diego-tag/ducted-fan/README.md

# Progetto Double Propeller Ducted-Fan (DPDF)

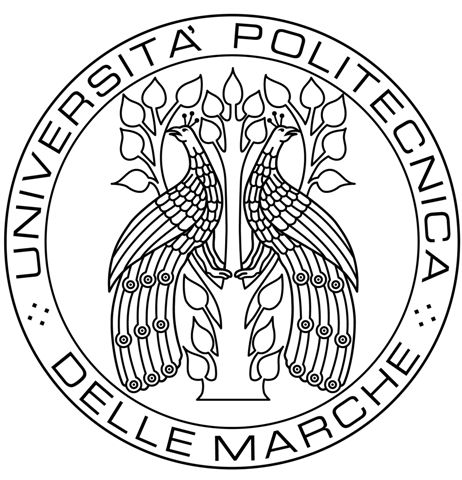
[picture p1: relazione/corrente/figures/00_frontespizio/logo_univpm.jpg]
Logo Univpm


Questo repository contiene la documentazione completa e il firmware per l’UAV **Double Propeller Ducted-Fan (DPDF)** sviluppato come parte del corso di *Laboratorio di Automazione* presso l’Università Politecnica delle Marche.

---

## 📌 Panoramica del progetto

Il **DPDF** è un UAV ducted-fan progettato su misura che presenta:

- Due motori brushless controrotanti per una spinta verticale stabile  
- Controllo aerodinamico tramite flap azionati da servo (pitch e roll)  
- Flight controller basato su STM32H745ZI-Q Nucleo  
- Fusione dei sensori tramite IMU BNO-055 per la stima dell’assetto  
- Misurazione dell’altitudine tramite sensore ToF VL53L1X  
- Implementazione del controllo di hovering basato su PID  

Il sistema è stato sviluppato per ottenere un **hovering** stabile.

## 📁 Struttura del repository

```
root/
├── relazione/
│   └── corrente/main.tex      # Relazione in LaTeX
├── utils/                     # Scripts in python utili (lettura/scrittura seriale)
└── DUCTED_FAN/                # Codice sorgente STM32 in C
```

## 🛠️ Ambiente di sviluppo

- **IDE**: STM32CubeIDE 1.12.1  
- **Configuratore hardware**: STM32CubeMX  
- **Linguaggio**: C (firmware), LaTeX (documentazione)

## 📚 Documentazione

La relazione tecnica completa con tanto di specifiche e schemi è scritta in LaTeX ed è disponibile [qui](relazione/corrente/main.pdf)

## 📎 Autori

- **Mencarelli Matteo**  
- **Secci Bianca**  
- **Tagliatesta Diego**

Supervisionato da:

- Prof. Andrea Bonci  
- Dott. Alessandro Di Biase  

Università Politecnica delle Marche – 2026

> Crediti: Robert Mincu Lareunt

## 📄 Licenza

Questo progetto è educativo ed è destinato all’uso accademico. I progetti hardware e il codice possono essere riutilizzati con la corretta attribuzione.
