diego-tag/ducted-fan/relazione/precedente/chapter3-SOFTWARE/BNO055_software.tex

\section{Descrizione del sub-firmware di gestione del BNO-055 Bosch Sensortec}
