diego-tag/ducted-fan/relazione/corrente/main.pdf

Universita Politecnica delle Marche `

Ingegneria Informatica e dell’Automazione

# Ducted Fan


## Corso di

Laboratorio di Automazione

## Anno accademico 2025-2026

Studenti: | Professore:
Mencarelli Matteo Secci Bianca Tagliatesta Diego | Andrea Bonci
| Dottorando:
| Alessandro Di Biase

Dipartimento di Ingegneria dell’Informazione

## Indice

Introduzione | 2
1 Sistema | 4
2 Hardware | 6
2.2.2 | TATTU LiPo. Caratteristiche tecniche e considerazioni operative . . . | 12
2.6.1 | Turnigy AereoDrive SK3-3536 1400 KV. Caratteristiche fisiche e tecniche 17

2.10.2 BNO-055 Bosch Sensortec. Infrastruttura di alimentazione, comunica-

2.10.3 Principio di misura dell’accelerometro, giroscopio e magnetometro . . 29 2.10.4 BNO-055 Bosch Sensortec. Accelerometro, giroscopio e magnetometro

2.11 VL53L1X ST. Sensore Time-of-Flight per la misurazione a lunga distanza . . | 34
3 Software | 43
4 Test e risultati | 55
Conclusioni e sviluppi futuri | 56
Appendici | 56
A Appendice1 | 57

## Introduzione

Spiegazione dettagliata del task assegnato al gruppo (cosa avete fatto e su quale sistema). Se per lo svolgimento del task `e stato necessario interagire con altri gruppi che hanno lavorato sullo stesso sistema, presentare anche brevemente i task svolti dagli altri gruppi e spiegare la loro interconnessione. Se si `e invece optato per far confluire il lavoro di pi`u gruppi in un’unica relazione, va spiegato qual era il task iniziale dei singoli gruppi e poi come `e avvenuta l’integrazione. In sintesi, l’introduzione deve permettere al lettore di capire subito su cosa avete lavorato. Al termine dell’introduzione inserite anche una breve descrizione per capitoli del contenuto della restante parte della relazione (es. nel Capitolo 2 viene descritto...).
Nel seguito la struttura in capitoli di massima per ogni relazione, da adattare qualora necessario. NOTA: La relazione va pensata e scritta nell’ottica di dare a chi verr`a dopo di voi un documento utile per capire a che punto `e arrivata l’attivit`a svolta dal vostro gruppo e per metterli in condizione di portare avanti il vostro lavoro. Di conseguenza dovete essere chiari e diretti, riportando solo le informazioni necessarie e evidenziando in modo critico cosa effettivamente funziona correttamente e cosa va migliorato

## 1 Sistema

Nel presente capitolo viene descritta la struttura meccanica del Double Propeller Ducted-Fan (DPDF) e viene introdotto l’obiettivo di controllo adottato nel progetto.

## 1.1 Double Propeller Ducted-Fan. Struttura

Il DPDF presenta una struttura cilindrica cava di 220 [mm] di altezza e con un diametro esterno pari a 235 [mm]. Il diametro interno, pari a 230 [mm], contiene le componenti necessarie al volo stabile dell’UAV.
La configurazione con montaggio interno delle componenti responsabili del moto rappresenta l’elemento distintivo rispetto alle architetture di droni convenzionali. Tale configurazione risulta vantaggiosa per qualsiasi forma di interazione di contatto, sia con l’operatore umano sia con oggetti esterni, in quanto le eliche non sono esposte ma risultano integrate e protette dalla stessa struttura portante del drone.
Proseguendo con la descrizione della struttura interna del DPDF, nella parte superiore sono posizionati due motori disposti in configurazione controrotante. L’implementazione di tale assetto garantisce la generazione di spinte verticali senza che il drone ruoti su se stesso attorno all’asse Z, passante per il centro della struttura cilindrica. Le eliche, infatti, generano momenti torcenti in direzione opposta e, bilanciandosi, restituiscono un momento risultante nullo per il velivolo.
Inoltre, l’adozione di due motori si `e resa necessaria in quanto un singolo attuatore non sarebbe stato in grado di generare una spinta sufficiente a garantire la portanza richiesta dal sistema nelle condizioni operative previste. I motori sono ancorati a una struttura a croce usata sia come base sia come rinforzo per le sollecitazioni che il DPDF pu`o subire. Tale struttura `e stata progettata con una geometria e una finitura superficiale tali da minimizzare l’insorgenza di turbolenze aerodinamiche potenzialmente destabilizzanti per il volo del drone. Il disegno strutturale rende il DPDF suscettibile a rotazioni indesiderate sul piano definito dagli assi X e Y. Tali perturbazioni possono compromettere la stabilit`a del sistema, determinando una completa perdita di controllo del mezzo.
Al fine di limitare tali perturbazioni, la parte inferiore del DPDF integra due flap: uno dedicato al controllo dell’assetto lungo l’asse delle ascisse e uno lungo l’asse delle ordinate. I flap, interagendo con il getto d’aria generato dai motori, operano come superfici aerodinamiche di controllo dedicate alla compensazione dei disturbi di roll e pitch. L’intervento di regolazione si basa sulla modifica della direzione e della velocit`a del flusso d’aria spinto verso il basso. Il flap, ruotando di un piccolo angolo, genera una deviazione del getto che lo investe. Tale deviazione produce una variazione della distribuzione di pressione tra il lato esposto al flusso (lato di pressione) e il lato opposto (lato di depressione). La differenza di pressione genera una forza aerodinamica risultante che produce un momento correttivo sull’assetto del velivolo. In prima approssimazione, la forza pu`o essere considerata perpendicolare alla superficie del flap. La direzione e il verso della forza devono essere tali da contrastare il momento perturbativo.

Entrambi i flap sono collegati, a un’estremit`a, al servomotore che ne gestisce il movimento, mentre all’altra sono inseriti in un apposito modulo strutturale che, oltre a fissare ciascun sensore del sistema, lo mantiene parallelo al terreno. I flap sono posizionati in modo tale da risultare perpendicolari tra loro.
Lungo la superficie esterna del cilindro sono state posizionate le componenti hardware necessarie al perseguimento degli scopi progettuali. La posizione di tali componenti `e stata oggetto di studio al fine di ottenere un preciso bilanciamento del sistema. Gli elementi hardware utilizzati verranno approfonditi nel Capitolo 2.
Inoltre, sulla superficie esterna sono montati sei piedi, posizionati in corrispondenza dei vertici dell’esagono in cui `e inscritta la circonferenza del DPDF. Tale configurazione permette di ottenere un’ottima distribuzione dei pesi. I piedi sono agganciati alla struttura mediante due bulloni opportunamente posizionati, il cui dado di fissaggio si trova all’esterno, lasciando cos`ı la testa all’interno. Tale impostazione permette di evitare l’allentamento del dado di fissaggio causato dal flusso d’aria incidente generato dai motori.
L’intera struttura cilindrica, i flap, il supporto di sostegno dei motori e i piedi di appoggio sono stati realizzati tramite stampa 3D, utilizzando PVC come materiale principale. Tutte le componenti sono state stampate separatamente e successivamente assemblate e fissate tra loro al fine di costruire la struttura completa del sistema.

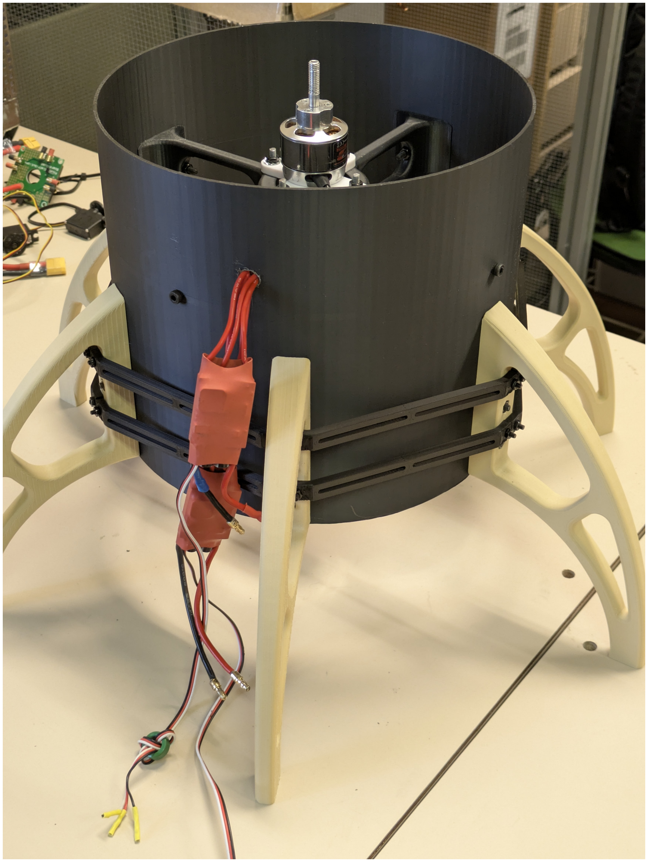
[picture p52: figure]

(a) Struttura di sostegno dei motori | (b) Vista frontale

Figure 1.1: Struttura del ducted fan

## 1.2 Controllo del Double Propeller Ducted-Fan

L’attuale obiettivo di controllo prevede l’ottenimento dell’hovering del DPDF. Con il termine hovering si fa riferimento alla condizione di volo stazionario, in cui l’UAV rimane fermo nello spazio rispetto a un riferimento inerziale, mantenendo posizione e quota costanti nel tempo. Per soddisfare l’obiettivo di hovering, il firmware implementa la teoria dei regolatori PID: un regolatore `e relativo al controllo di quota, mediante la regolazione della portanza dei motori, e due regolatori sono coinvolti nel controllo della posizione mediante la regolazione del comparto flap-servo.

## 2 Hardware

Nel presente capitolo viene fornita la descrizione di tutte le componenti hardware impiegate ai fini progettuali. Per ciascun componente sono stati approfonditi il ruolo nel sistema, le principali caratteristiche fisiche e tecniche e le modalit`a di utilizzo. Infine sono stati riportati un diagramma esplicativo dei collegamenti e una tabella riepilogativa delle connessioni.

## 2.1 STM32 NUCLEO-H745ZI-Q. La scheda di controllo

L’STM32 NUCLEO-H745ZI-Q `e una scheda di sviluppo prodotta da STMicroelectronics, basata sul microcontrollore STM32H745ZI-TQ6, appartenente alla famiglia ad alte prestazioni STM32H7. Il dispositivo `e stato progettato per facilitare lo sviluppo, il debug, e la prototipazione di applicazioni embedded complesse. La NUCLEO-H745ZI-Q `e stata utilizzata per sviluppo e testing dei firmware di gestione di tutte le componenti del D.P.D.F. Su di essa sono state caricate tutte le librerie software sviluppate con l’ausilio di STM32CubeIDE. A seguire, una descrizione dettagliata delle features del microcontrollore STM32H745ZI-TQ6.

### 2.1.1 STM32H745ZI-TQ6. Architettura

Il microcontrollore STM32H745ZI-TQ6 presenta un’architettura dual-core a 32-bit composta da un processore ad alte prestazioni, il Cortex-M7, e da un processore il cui utilizzo `e consigliato per applicazioni real-time e low-power tasks. L’architettura consente l’implementazione di applicazioni multithread. In questo progetto di tesi, l’esecuzione delle librerie software di gestione dei dispositivi interessati `e affidata al Cortex-M4. La selezione e la configurazione delle periferiche dello STM32H745ZI-TQ6 necessarie al raggiungimento degli obiettivi progettuali verranno approfondite nel capitolo dedicato al firmware. A seguire un elenco delle caratteristiche concernenti all’architettura dual-core:

- Il Cortex-M7 opera ad una frequenza di 480 MHz.
- Il Cortex-M4 opera ad una frequenza di 240 MHz.

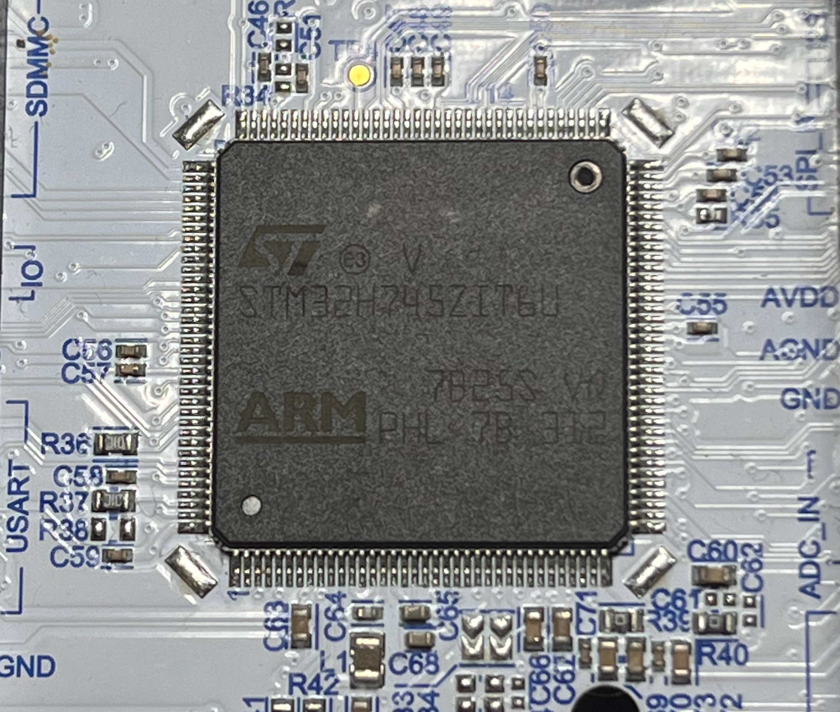
[picture p53: figure]

Figure 2.1: Il microcontrollore STM32H745ZI-TQ6

### 2.1.2 STM32H745ZI-TQ6. Memoria

Il microcontrollore possiede una struttura di memoria complessa e stratificata. Le memorie interne principali sono la memoria Flash e la SRAM. Inoltre, il core M7 monta una cache L1 e una piccola backup SRAM alimentabile a batteria.

Flash
La Flash interna da 2 MByte `e l’area di memoria su cui risiede il firmware. La memoria in questione `e organizzata in dual-bank, che permette la programmazione/cancellazione di una banca dati mentre si esegue sull’altra.

SRAM
Il dispositivo dispone di circa 1 MByte di memoria dati volatile o SRAM, distribuita in pi`u banchi con caratteristiche e destinazioni d’uso differenziate. In particolare:
- La SRAM1 e la SRAM2, rispettivamente da 320 KByte e 384 KByte, costituiscono i blocchi principali ad alta velocit`a, accessibili da entrambi i core. Rappresentano l’area privilegiata per l’allocazione dei dati che richiedono tempi di accesso ridotti e condivisibilit`a tra i due processori.
- Il blocco di SRAM3, da 128 KByte, `e tipicamente dedicato al Cortex-M4, favorendo cos`ı una separazione logica delle risorse riducendo anche i conflitti di accesso.
- SRAM4, SRAM5 e SRAM6, in ordine, 128 KByte, 64 KByte e 64 KByte completano la struttura, fornendo ulteriori spazi di memoria che possono essere destinati a funzioni specifiche o a buffer ad alte prestazioni, secondo esigenze applicative.

Cache L1
Il Cortex-M7, a supporto dell’efficienza complessiva, integra una cache L1 per istruzioni e dati, riducendo la latenza di accesso alla memoria non volatile e minimizzando i colli di bottiglia dovuti alla differenza tra la velocit`a del processore e quella della Flash. In tal modo le prestazioni globali del sistema risultano incrementate.

Flexible Memory Controller e Dual-mode Quad-SPI
Il Flexible Memory Controller `e un’unit`a hardware che consente l’interfacciamento diretto con memorie parallele esterne al dispositivo. Il FMC supporta: SRAM, PSRAM, SDRAM, NOR Flash e NAND Flash. L’integrazione del FMC comporta un incremento nell’efficienza delle comunicazioni. Una volta configurato il controller, la memoria esterna entra a far parte dello spazio di indirizzi del microcontrollore mascherando la complessit`a del protocollo. Il Dual Mode Quad-SPI `e un’altra interfaccia dedicata alle Flash seriali esterne ad alta velocit`a. La soluzione poco fa citata permette di espandere la memoria dedicata al firmware oppure di archiviare dati.

Memory Protection Unit
La Memory Protection Unit `e una componente hardware integrata in ciascun core del microcontrollore. La mansione del circuito integrato in questione `e quella di controllare e regolare l’accesso alla memoria.

Unit`a di elaborazione
L’architettura dell’STM32H745ZI-TQ6 integra anche unit`a di elaborazione dedicate ai calcoli numerici e al processamento dei segnali.

Floating Point Unit
La FPU `e un’unit`a hardware integrata nei due core di elaborazione che consente l’esecuzione diretta di operazioni in virgola mobile. La presenza di questo circuito integrato riduce drasticamente la latenza di calcolo in applicazioni che richiedono elaborazioni numeriche complesse. Nel caso del Cortex-M7 la FPU supporta sia la single precision che la double precision, mentre il Cortex-M4 solo una FPU a precisione singola.

Digital Signal Processing
Il Digital Signal Processing `e un supporto hardware per istruzioni dedicate all’elaborazione numerica di segnali digitali.

### 2.1.3 STM32H745ZI-TQ6. Convertitori

Convertitori Analogici-Digitali
L’STM32H745ZI-TQ6 integra tre convertitori analogici-digitali SAR ADC (successive approximation analog-to-digital converter ) a 16-bit: ADC1, ADC2 e ADC3. I primi due, l’ADC1 e l’ADC2, sono tightly coupled, cio`e strettamente accoppiati, consentendo una sincronizzazione precisa delle conversioni. Questo approccio permette di ottenere alte frequenze di campionamento, precisione temporale e riduzione del carico computazionale del core. L’ADC3 invece `e istanziato separatamente. La risoluzione pu`o essere configurata a 16, 14, 12, 10 o 8 bit.

Convertitori Digitali-Analogici
Il microcontrollore possiede 2 DAC indipendenti la cui risoluzione `e a 12 bit.

### 2.1.4 STM32H745ZI-TQ6. Timer

I timer sono periferiche hardware fornite dal microcontrollore per svolgere attivit`a correlate al tempo. L’STM32H745ZI-TQ6 fornisce 15 timer di diverso tipo e 5 low power timer. Alcuni di questi possono essere utilizzati per la genesi di segnali PWM.

### 2.1.5 STM32H745ZI-TQ6. Periferiche di comunicazione

L’STM32H745ZI-TQ6 integra un insieme ampio e variegato di protocolli di comunicazione. Le periferiche possono essere raggruppate in tre categorie principali: comunicazione seriale, comunicazione veloce e interfacce multimediali speciali. Per quanto riguarda la comunicazione seriale, il microcontrollore supporta i protocolli: I

2C, USART/UART e SPI.
Nell’ambito della comunicazione veloce e avanzata il dispositivo supporta i protocolli: CAN (Controller Area Network), USB OTG, Ethernet MAC, SD/SDIO/MMC. L’integrazione delle interfacce multimediali consente la gestione di applicazioni audio, grafiche e visione artificiale: SAI (Serial Audio Interface), DFSDM (Digital Filter for Sigma-Delta Modulators) e DCMI (Digital Camera Interface).

### 2.1.6 STM32H745ZI-TQ6. Eventi asincroni

Il microcontrollore offre la possibilit`a di gestire con efficacia ogni genere di interrupt (evento asincrono) grazie all’integrazione di un’unit`a di elaborazione dedicata: il NVIC (Nested Vector Interrupt Controller ).

### 2.1.7 NUCLEO-H745ZI-Q. Caratteristiche della scheda

La NUCLEO-H745ZI-Q `e la scheda di sviluppo (development board) che proietta all’esterno tutte le funzionalit`a del microcontrollore poco fa descritto.

Caratteristiche fisiche

- Dimensioni: 133.34 × 70.00 [mm].
- Peso: 120 [g].

ST-LINK/V3E
L’ST-LINK/V3E `e un’interfaccia hardware, gestita dal microcontrollore STM32F723, dedicata al collegamento tra elaboratore esterno e microcontrollore. Il modulo permette di caricare il compilato firmware sul microcontrollore direttamente dalla porta USB Micro-B collegata al sistema di elaborazione. Il modulo permette, inoltre, di eseguire il debug in tempo reale del codice caricato sull’MCU. L’ST-LINK/V3E fornisce anche interfacce ausiliarie utili ai fini dello sviluppo. A seguire un breve elenco esplicativo di queste funzionalit`a aggiuntive:
- VCP (Virtual COM Port): lo ST-LINK integra un’interfaccia di comunicazione che emula una porta seriale virtuale (da cui il nome Virtual COM Port, VCP), tramite connessione USB. In tal maniera, l’elaboratore riconosce lo ST-LINK come una porta COM standard.

- MSC (Mass Storage Class): la scheda di sviluppo appare al sistema di elaborazione come una memoria esterna.

Alimentazione
La scheda di sviluppo offre diversi approcci per l’alimentazione:
- Alimentazione via USB Micro-B ST-LINK a 5V.
- Alimentazione via Jack esterno da 7-12V.
- Alimentazione tramite pin Vin esterno a 3.3V.

Nonostante la presenza di diversi approcci di alimentazione e i differenti voltaggi, la tensione di alimentazione del microcontrollore `e 3.3V, ottenuta attraverso regolatori interni. Sulla scheda di sviluppo sono presenti dei jumper, ovvero dei piccoli interruttori meccanici che permettono di riconfigurare l’hardware della scheda evitando di intaccare il firmware. Si suggerisce di prestare attenzione alla configurazione dei jumper qualora si volesse alimentare la scheda da ingressi diversi dal COM1 o MICRO-B ST-LINK.


Figure 2.2: NUCLEO-H745ZI-Q. Dettaglio esplicativo dei jumper .

Formato fisico
La scheda di sviluppo in esame appartiene alla famiglia Nucleo-144 di STMicroelectronics e, dunque, mette a disposizione 2 connettori Morpho che espongono i 144 pin del microcontrollore. Il sistema di espansione poco fa citato viene chiamato ST Zio. La NUCLEO-H745ZI-Q offre, inoltre, la compatibilit`a hardware e pinout con gli shield Arduino Uno R3.


Figure 2.3: La scheda di sviluppo NUCLEO-H745ZI-Q

## 2.2 TATTU LiPo. Batteria ricaricabile [DA MODIFICARE]

Motori, Servomotori e E.S.C richiedono specifici livelli di tensione per il loro funzionamento, tensioni che non possono essere fornite dalla NUCLEO H745ZI-Q. Si rende, quindi, necessario l’inserimento nel progetto di batterie ricaricabili.
La selezione delle batterie disponibili sul mercato `e stata condotta a seguito di un’analisi approfondita delle caratteristiche elettriche di motori, servomotori ed E.S.C, unitamente ad uno studio dettagliato delle esigenze di autonomia necessarie per le prove di volo, rapportando il tutto al budget disponibile.
Le TATTU LiPo possiedono le prestazioni richieste dal progetto.

### 2.2.1 TATTU LiPo. Caratteristiche fisiche

- Dimensioni: 74 × 35.5 × 29 [mm].
- Peso: 150 [g].
- Numero di celle: 4.

### 2.2.2 TATTU LiPo. Caratteristiche tecniche e considerazioni operative

LiPo
La sigla LiPo sta ad indicare la tecnologia elettrochimica utilizzata nella costruzione della batteria. LiPo nasce da Lithium-Polymer, ovvero polimero di litio. La particolare nominazione deriva dal componente chimico utilizzato come elettrolita, che, nel caso in esame, non `e liquido, ma un polimero gelificato. Malgrado nelle fonti ufficiali non venga specificato il polimero usato nel progetto delle TATTU LiPo, con il fine di informazione, `e stato deciso di riportare quello pi`u comunemente utilizzato per la tipologia di batterie in esame, il polivinilidenfluoruro esafluoropropilene (PVDF-HFP).
Rispetto ad altri sistemi elettrochimici presenti sul mercato (come ad esempio: Li-ion, LiF eP O4, NiMH ecc.), le batterie LiPo presentano un’elevata densit`a di potenza, una bassa resistenza interna e una notevole flessibilit`a nelle geometrie costruttive, oltre ad un contenuto peso. Tali attributi risultano vantaggiosi nell’ambito della progettazione di UAV, come il D.P.D.F.

Tensione
La TATTU LiPo possiede 4 celle da 3.7 [V]. Le celle sono collegate in serie, perci`o la tensione nominale `e circa 14.8 [V].
A carica completa, ogni cella pu`o raggiungere i 4.2 [V], emettendo un’uscita di 16.8 [V]. Il mantenimento della tensione delle celle nell’intorno dei 3.7 [V] contribuisce a preservare la stabilit`a chimica interna delle batterie, riducendo l’erosione delle celle e prolungandone la vita utile. Si consiglia di non mantenere le celle a 4.2 [V] per periodi prolungati di tempo, evitandone cos`ı il danneggiamento.
Nella fase iniziale e di sviluppo firmware, le batterie sono state tenute in bilanciamento alla tensione nominale di 14.8 [V], mentre, nella fase finale, in cui i test di volo sono stati protagonisti, al fine di ottenere un aumento dell’autonomia delle batterie e della prestazione dei motori, queste venivano caricate, mantenendo il bilanciamento tra celle, fino a 4.2 [V] per cella. Infine, `e necessario adottare un’ulteriore accortezza per evitare danni. E consigliabile ` non far scendere la tensione della batteria al di sotto dei 12 [V], mantenendo cos`ı il valore di tensione di ogni cella sopra i 3 [V].

Capacit`a
La capacit`a di una batteria, misurata in [mAh], milliAmpere-ora, definisce la quantit`a di carica elettrica che la batteria pu`o immagazzinare e fornire nel tempo. Nel caso in esame, la capacit`a `e di 1300 [mAh], vale a dire che la batteria pu`o fornire 1.3 [A] per un’ora.

In generale si pu`o utilizzare la seguente formula approssimata per il calcolo del tempo di funzionamento:

th =

C [mAh]
A [mA]

(2.1)

dove th rappresenta il tempo di funzionamento in ore, C la capacit`a della batteria espressa in milliAmpere-ora e A la corrente assorbita espressa in milliAmpere. Con il fine di aumentare l’autonomia di volo, si `e optato per l’accoppiamento in parallelo di due TATTU LiPo, cos`ı da ottenere una capacit`a totale di 2600 [mAh]. L’accoppiamento in sicurezza `e stato effettuato utilizzando il PowerSafe Twin della MNR-electronics, il quale verr`a approfondito nella successiva sezione.

Capacit`a di scarica
Con il termine capacit`a di scarica ci si riferisce alla quantit`a di corrente massima che la batteria pu`o fornire, in sicurezza e in maniera continuativa, senza danneggiarsi. La TATTU LiPo possiede una capacit`a di scarica pari a 75C, vale a dire che pu`o erogare:
Amax = Cs · C =⇒ Amax = 75 [C] · 1.3 [A] = 97.5 [A] | (2.2)

senza surriscaldarsi o danneggiarsi.
Nella precedente formula, Amax si riferisce alla corrente massima erogabile dalla batteria in sicurezza, espressa in [A], Amp`ere. Cs e C, invece, si riferiscono rispettivamente alla capacit`a di scarica e alla capacit`a di erogazione di corrente in un’ora, espressa sempre in [A].

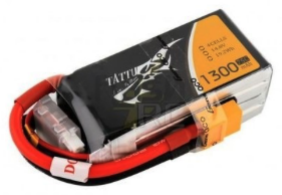
[picture p54: figure]

Figure 2.4: TATTU LiPo 4S 1300mAh 75C

## 2.3 PowerSafe Twin ADV. MNR-electronics

Per garantire la sicurezza e l’affidabilit`a dell’alimentazione a due pacchi batteria, si `e deciso per l’implementazione del modulo di ridondanza, PowerSafe Twin ADV di MNR-electronics.
Il dispositivo incarna un’avanzata soluzione di ridondanza attiva. Quest’ultima fa riferimento alla capacit`a del sistema di intervenire attivamente nel funzionamento del circuito con il fine di garantire continuit`a di alimentazione. Il modulo, di fatto, monitora continuamente alcune variabili di stato, come tensione e corrente, selezionando, in tempo reale, il pacco alimentante il carico. Per esempio, se dovesse abbassarsi la tensione di una batteria sotto una certa soglia critica, il dispositivo commuterebbe automaticamente sull’altra, evitando cos`ı una significativa interruzione della potenza fornita.
Nell’architettura del sistema `e possibile distinguere tre moduli distinti.

Modulo di potenza
Il modulo di potenza `e il circuito elettrico responsabile della commutazione tra i pacchi batteria, del bilanciamento e della distribuzione di corrente verso il carico.
Inoltre, il dispositivo implementa circuiti di protezione, isolando la sorgente guasta, qualora si dovesse presentare un malfunzionamento, ed evitando il trasferimento di corrente fra i pacchi batteria.

Modulo di controllo
Il modulo di controllo rappresenta il ”centro di comando” del dispositivo. L’implementazione di un microprocessore permette la continua misura di parametri decisionali fondamentali, quali: la tensione delle batterie, la corrente di carico e l’eventuale squilibrio. L’inserimento del modulo di controllo nell’architettura circuitale permette l’implementazione della, precedentemente citata, tecnologia di ridondanza attiva.

Modulo di allarme
Il modulo di allarme provvede alla segnalazione di eventuali guasti mediante emissioni luminose (LED) ed acustiche (Buzzer).

### 2.3.1 PowerSafe Twin ADV. Caratteristiche fisiche e tecniche

A seguire, un breve elenco delle caratteristiche fisiche e tecniche del dispositivo:

- Dimensioni con involucro protettivo: 80 × 59 × 26 [mm].
- Peso, considerando sia l’involucro protettivo che i cablaggi (connettori XT60): 100 [g].
- Corrente massima gestibile: 100 [A] (in continua).
- Numero di celle per pacco batteria gestibili: [3S − 8S].
- Tensione massima ammessa in ingresso: ≈ 33.6 [V]. Considerando il minimo 3.7 [V] e il massimo 4.2 [V] per cella: [11.1 ÷ 33.6] [V].

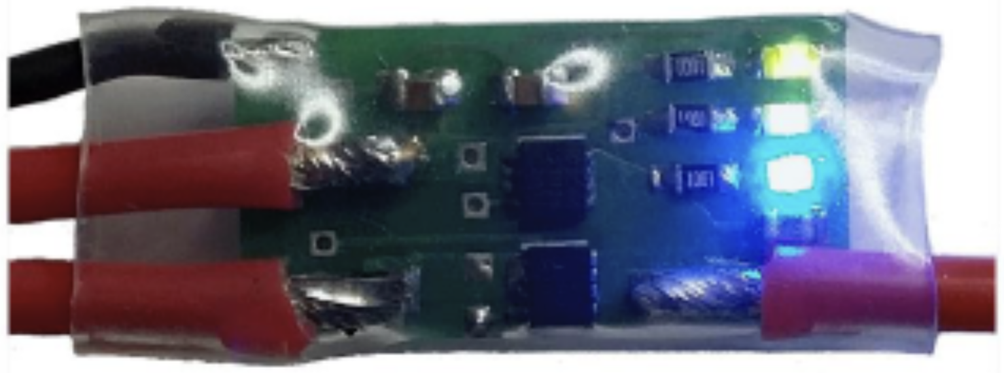
[picture p55: figure]

Figure 2.5: PowerSafe Twin ADV MNR-electronics

## 2.4 DFRobot Power Module. Convertitore di tensione

Ai fini progettuali sono stati implementati diversi dispositivi, ciascuno dei quali richiedente una specifica tensione di alimentazione. Si `e reso necessario ricorrere a convertitori di tensione per distribuire nella maniera corretta le tensioni di alimentazione ai vari dispositivi.
Il DFRobot Power Module riceve in ingresso la tensione proveniente dal pacco batterie, erogando quattro diversi valori di tensione a seconda del terminale che si sceglie di utilizzare. La prima soluzione offerta dal dispositivo fornisce in uscita la stessa tensione che si ha in ingresso, diventando cos`ı un ponte per il passaggio della tensione.
Un’altra soluzione consiste nell’utilizzo degli appositi pin sul dispositivo, dai quali pu`o essere erogata una tensione di 5 [V], selezionabile mediante un apposito switch.
Infine, il dispositivo presenta un terminale che eroga una tensione variabile il cui valore `e controllato da un dimmer. Il dimmer permette di selezionare valori intermedi fino ad un massimo pari alla tensione di ingresso. Quest’ultima `e stata utilizzata nell’alimentazione dei servomotori. La presenza di due servomotori ha richiesto l’integrazione di due convertitori di tensione.

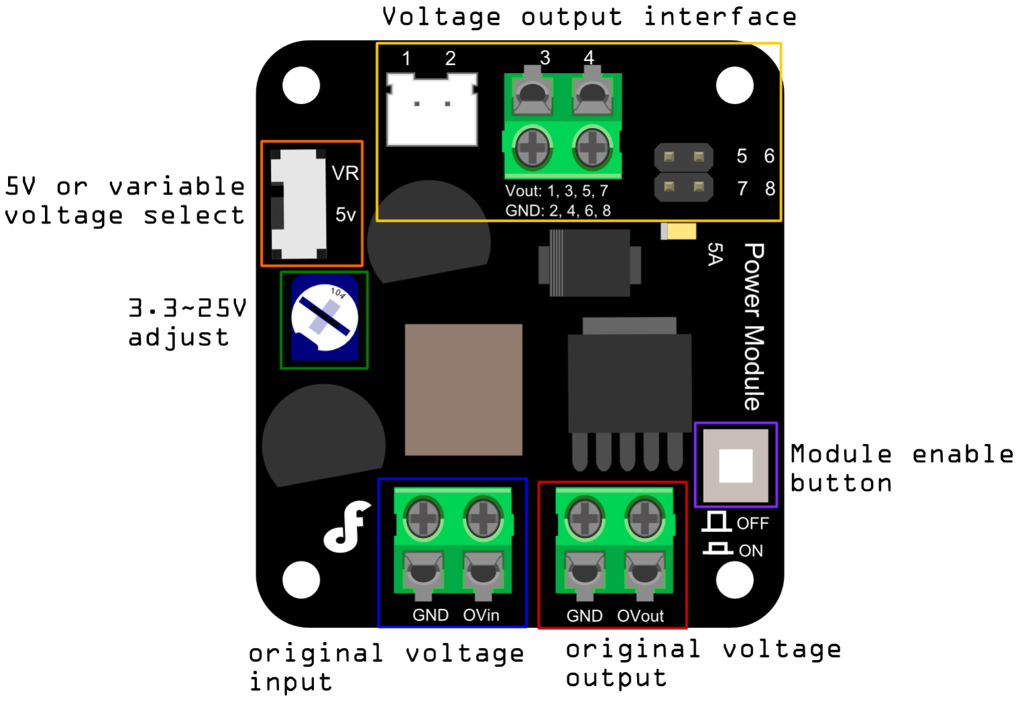
[picture p56: figure]

Figure 2.6: DFRobot Power Module. Disposizione dei terminali di uscita

Caratteristiche fisiche

- Dimensioni: 46 × 50 × 20 [mm].

- Peso: 35 [g].

Caratteristiche tecniche

- Intervallo di tensione in ingresso: [3.6÷25] [V].
- Intervallo di tensione esprimibile in uscita: [3.3÷25] [V].
- Massima potenza erogabile: 25 [W].
- Frequenza di variazione: 350 [kHz].


Figure 2.7: DFRobot Power Module

## 2.5 Power Distribution Board

Con Power Distribution Board (PDB) si fa riferimento ad un sottosistema elettrico la cui principale funzione `e la distribuzione in modo sicuro ed efficiente dell’energia fornita dal pacco batterie agli E.S.C e, conseguentemente, ai motori. Ai fini progettuali, `e stata selezionata una PDB, il cui punto di prelievo del segnale presenta un connettore XT60, adatto al pacco batterie.


Figure 2.8: Power Distribution Board

Il PDB integrato nel contesto operativo possiede quattro uscite eroganti al massimo una corrente di 20 [A] ed un peso di 27.3 [g].

## 2.6 Turnigy AereoDrive SK3-3536 1400KV

Il Turnigy AereoDrive SK3 3536 1400kv `e un motore Brushless alimentato a corrente continua e pilotato a trifase con correnti alternate.
Il rotore contiene magneti permanenti disposti con polarit`a alternata lungo la sua circonferenza. Lo statore invece ospita tre avvolgimenti elettrici (fasi) disposti generalmente a 120 gradi elettrici l’uno rispetto all’altro, connessi ai tre terminali d’uscita che si identificano come A, B e C.
Il rotore, essendo formato da magneti permanenti, non necessita di alimentazione: `e lo statore a generare il campo magnetico rotante che induce il moto.
Il cambio di polarit`a degli avvolgimenti deve essere gestito da un sistema elettronico esterno, l’Electronic Speed Controller (ESC), che nella successiva sezione verr`a approfondito.
I tre conduttori che fuoriescono dal motore rappresentano i terminali delle tre fasi dello statore. Ciascun filo `e collegato a uno degli avvolgimenti e nessuno di essi costituisce un riferimento comune. Per far ruotare il motore `e necessario che tali fasi vengano alimentate secondo una precisa sequenza temporale, generando un campo magnetico rotante. Se si dovessero scambiare due dei tre cavi, l’ordine di commutazione si invertirebbe con conseguente variazione del senso di rotazione.
Nel progetto sono stati impiegati due motori del tipo precedentemente citato, disposti in configurazione controrotante, con il fine di compensare le rotazioni indesiderate di yaw. Tale scelta consente di bilanciare le coppie di reazione generate dalle eliche, riducendo il momento torcente sul velivolo. Inoltre, l’adozione di due motori si `e resa necessaria in quanto un singolo attuatore non sarebbe stato in grado di generare una spinta sufficiente a garantire la portanza richiesta dal sistema nelle condizioni operative previste.

### 2.6.1 Turnigy AereoDrive SK3-3536 1400 KV. Caratteristiche fisiche e

tecniche

- Tensione operativa: [11.1÷16.8] [V].

- Valore KV: 1400 RPM
V
- Potenza massima: 590 [W].
- Corrente massima: 40 [A].
- Resistenza interna: [0.021÷0.025] [Ω].
- Corrente a vuoto: 0.021 [A].
- Diametro dell’albero motore: 5 [mm].
- Peso: 111 [g].
- Spaziatura fori di montaggio: 25×25 [mm].
- Connettori bullet da 3.5 [mm].
- Numero dei poli: 12.

Il valore ”KV” `e comune nel contesto del modellismo ed indica il numero di giri al minuto (RPM) che il motore compie per ogni volt applicato a vuoto, in formula:

RPM = KV · V | (2.3)

A tensioni di alimentazione maggiori rispetto a quelle specificate il motore rischia di assorbire troppa corrente e surriscaldarsi.
I giri al minuto massimi dipenderanno dalla tensione applicata e dalle dimensioni delle eliche. Nel presente progetto, il motore in interesse deve essere alimentato a batteria, vale a dire in corrente continua, lasciando spazio alla necessit`a di un dispositivo che trasformi la tensione continua erogata dalle batterie in un segnale trifase a corrente alternata. Il dispositivo in questione `e il precedentemente citato Electronic Speed Controller.


Figure 2.9: Turnigy Aereo Drive SK3 3536 1400 KV

## 2.7 Turnigy Plush 40A. Electronic Speed Controller

Il Turnigy Plush 40A `e un controllore elettronico di velocit`a per motori brushless a corrente continua (BLDC) [1].
Trasforma la tensione continua in ingresso in tensioni alternate sfasate di 120 gradi elettrici. L’applicazione della corretta sequenza di correnti alle fasi dello statore richiede la conoscenza della posizione angolare in ogni istante di tempo. Il Turnigy Plush 40A stima tale informazione in maniera indiretta, misurando la forza controelettromotrice indotta dal rotore, evitando cos`ı l’uso di sensori di posizione; il dispositivo in interesse pu`o dunque essere definito sensorless. L’ESC in questione pu`o essere concettualmente suddiviso in due sezioni principali: la sezione di potenza e la sezione di controllo. La sezione di potenza `e responsabile della conversione continua-trifase. Tale conversione `e mediata da un ponte trifase a sei MOSFET, suddiviso a sua volta in tre mezzi ponti, ciascuno associato ad una fase del motore. Ogni mezzo ponte `e composto da un transistor di alto lato e da un transistor di basso lato, collegati rispettivamente al potenziale positivo della batteria e a massa. L’opportuna commutazione di apertura e chiusura dei sei MOSFET comporta la generazione di un segnale di tensione alternato per ogni fase.
La sezione di controllo ha come protagonista un microcontrollore che si occupa della generazione di segnali di pilotaggio e della stima della posizione del rotore. Il microcontrollore riceve in ingresso il comando di velocit`a di rotazione del motore sotto forma di segnale PWM. Sulla base di tale comando, il microcontrollore determina il duty cycle del PWM e calcola la sequenza di commutazione dei sei MOSFET, con conseguente generazione del campo magnetico rotante dello statore.
Il Double Propeller Ducted Fan monta due Turnigy Plush 40A, uno per ogni motore.

### 2.7.1 Turnigy Plush 40A. Caratteristiche fisiche

- Corrente nominale: 40 [A].
- Corrente di picco: 55 [A].
- Presenza di un Battery Eliminator Circuit (BEC): 5 [V] a 3 [A].
- Celle di batteria necessarie per il corretto funzionamento del dispositivo: [2 ÷ 6].
- Peso: 39 [g].
- Dimensioni in [mm]: 60 × 24 × 15.

### 2.7.2 Turnigy Plush 40A. Programmazione

Il Turnigy Plush 40A offre la possibilit`a di programmare il suo comportamento operativo, soddisfacendo cos`ı un vasto spettro di possibili esigenze progettuali.
Al fine di ottenere uno specifico comportamento dei motori, tale da adeguarsi alle particolari esigenze di un UAV come il Double Propeller Ducted Fan, entrambi gli ESC sono stati minuziosamente riprogrammati.


Figure 2.10: Turnigy Plush 40A

L’accesso alla Programming Mode e l’effettiva programmazione sono state effettuate mediante l’apposita Turnigy Programming Card, acquistata separatamente. Per effettuare la programmazione, `e necessario disporre i collegamenti elettrici come in figura:

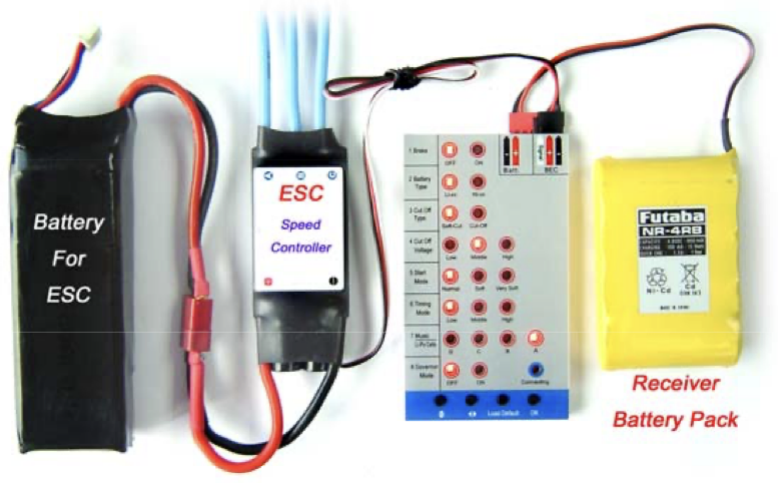
[picture p57: figure]

Figure 2.11: Schema dei collegamenti per la programmazione dell’ESC

La Turnigy Programming Card richiede di essere alimentata da un segnale continuo di tensione appartenente al seguente intervallo: [4.8 ÷ 6] [V]. Per la navigazione fra i parametri `e necessario utilizzare il pulsante up/down, mentre per la selezione dei corrispondenti valori deve essere utilizzato il pulsante left/right.
Nel momento in cui verr`a selezionato il valore desiderato del parametro in programmazione, il LED blu, che risponde al nome di connecting, lampegger`a, segnalando cos`ı il successo dell’operazione. A seguire, una piccola spiegazione del significato dei parametri e i valori attualmente selezionati:

Brake
Il parametro Brake si riferisce alla modalit`a con cui viene gestita la mancanza di segnale PWM di controllo. Nel caso in cui dovesse essere impostato ad ”ON” il motore verr`a immediatamente frenato.

Il parametro in analisi non ha grande valenza ai fini progettuali dal momento che qualsiasi prova di volo `e stata effettuata nell’apposita gabbia, per cui qualunque combinazione del parametro `e accettabile. Nello svolgersi del progetto il parametro `e stato impostato ad ”OFF”.

Battery Type
Il Battery Type riferisce al dispositivo la tipologia di batteria in utilizzo, questo perch´e l’ESC monitora costantemente la tensione della batteria: quando questa scende sotto una certa soglia, entra in azione il Low Voltage Cut-off, riducendo o interrompendo la potenza fornita al motore con il fine di evitare il danneggiamento delle celle. Diverse tipologie di batterie hanno diverse curve di scarica. L’ESC pu`o gestire solamente due tipologie di batterie, LiPo e NiMH. Il progetto prevede l’utilizzo delle Tattu LiPo perci`o il parametro `e stato impostato ad Li-xx.

Low Voltage Protection Mode (Cut-off Type)
Come gi`a riferito in precedenza, la Low Voltage Cut-Off evita il danneggiamento delle celle delle batterie quando queste scendono sotto una certa soglia impostabile.
Il dispositivo permette di scegliere tra Soft Cut-Off e Cut-Off. Se si dovesse scegliere la modalit`a Soft, al superamento della soglia, l’ESC ridurr`a gradualmente la potenza in uscita. Se si dovesse invece scegliere l’altra modalit`a, il dispositivo interromper`a immediatamente la linea di fornitura di potenza al motore.
Al fine di evitare il danneggiamento del sistema, dovuto a un’interruzione improvvisa della fornitura di potenza ai motori durante il volo, seppur all’interno della gabbia, `e stata impostata la modalit`a Soft Cut-Off.

Cut Off Voltage
Il parametro permette di impostare la soglia al di sotto della quale entra in azione la Low Voltage Protection Mode.
- Low: 2.6 [V].
- Medium: 2.85 [V].
- High: 3.1 [V].

Con il fine di limitare il danneggiamento delle batterie, ottenendo contemporaneamente una discreta autonomia di volo, il parametro `e stato impostato a Medium.
Numericamente, considerando le batterie Tattu LiPo a 4 celle, la soglia di attivazione del LVC `e: 2.85 V · 4 = 11.4 V .

Start Mode
La Start Mode gestisce la modalit`a di accelerazione del motore da fermo. Sono disponibili tre diverse modalit`a di partenza, pensate per adattarsi a qualsiasi applicazione.
La Normal Start Mode costituisce la modalit`a di accelerazione pi`u reattiva. L’ESC applica una rampa di potenza relativamente breve: nel giro di [0.3 ÷ 0.5] [s] il motore raggiunge i primi giri utili. L’appena descritta modalit`a `e stata scartata a priori dal momento che, come conseguenza di un’accelerazione repentina, si ha forte stress meccanico sull’albero motore;

inoltre l’improvvisa accelerazione delle eliche pu`o generare forze indesiderate.
Nella Soft Start la rampa di ingresso `e pi`u dolce: il motore, sotto il controllo dell’ESC, impiega [1 ÷ 1.5] [s] per arrivare a regime. Infine, nella Very Soft Start la potenza viene incrementata nell’arco di [2 ÷ 3] [s].
Qualsiasi prova di volo del D.P.D.F `e stata eseguita nell’apposita gabbia di contenimento, in cui il sistema `e stato sospeso mediante funi di sostegno; perci`o, con il fine di evitare movimenti indesiderati, stress meccanico ed errori di misurazione, `e stata impostata la Very Soft Start.

Timing Mode
L’ESC, con il fine di genesi di rotazione, genera campi magnetici rotanti commutando le tre fasi in sequenza. Le commutazioni devono avvenire in sincronia con la posizione del rotore. Il Timing `e l’anticipo angolare con cui l’ESC commuta le fasi rispetto alla posizione stimata del rotore.
Se il Timing dovesse essere basso, il campo magnetico rotante sarebbe quasi allineato con il rotore, disposizione che aumenterebbe l’efficienza elettro-meccanica complessiva del sistema ma diminuirebbe coppia e velocit`a. Al contrario, se dovesse essere alto, si avrebbe pi`u potenza e velocit`a ma anche pi`u dispersione di calore e meno efficienza.
L’High Timing Mode, a cui corrisponde un anticipo angolare di [16÷30]◦
, favorisce potenza e
velocit`a, utile per dispositivi ad alto numero di giri o da corsa. La Low Timing Mode, con un anticipo angolare di [0 ÷ 7]◦
, garantisce una coppia stabile con minima dispersione di calore con una leggera diminuzione della velocit`a massima.
La Medium Timing Mode ([8 ÷ 15]◦
) costituisce un buon compromesso fra efficienza e prestazioni, dunque `e stata scelta ai fini progettuali.

Music Li-Po Cells
La funzionalit`a `e puramente estetica e non influisce sulle prestazioni, per cui non `e stata impostata alcuna musica.

Governor Mode
La Governor Mode ha lo scopo di mantenere la velocit`a di rotazione del motore costante indipendentemente dalle variazioni di carico o tensione della batteria. Non essendo utile ai fini progettuali, il parametro `e stato impostato su ”OFF”.

### 2.7.3 Turnigy Plush 40A. Risoluzione e controllo dei motori

Il Turnigy Plush 40A, al fine di controllare la velocit`a di rotazione dei motori, richiede un segnale del tipo PWM alla frequenza tipica del modellismo, vale a dire 50 [Hz].
In primo luogo, `e necessaria una procedura di armamento dei motori, che consiste nell’invio del segnale PWM con duty cycle del 4.75%. L’esito dell’operazione di armamento pu`o essere stabilito mediante delle segnalazioni acustiche emesse dall’ESC. A seguire, le emissioni acustiche pi`u comuni:

Attesa di un segnale di armamento valido
Un’emissione ogni due secondi segnala l’attesa di un segnale PWM idoneo all’armamento iniziale dei motori. L’emissione viene attivata dal dispositivo immediatamente dopo la connessione di questo all’alimentazione.


Figure 2.12: Turnigy Programming Card

L’immagine riportata sopra non `e riferita alla configurazione attuale degli ESC, ma ha esclusivamente scopo illustrativo.

Esito positivo dell’operazione di armamento
Tre emissioni sonore consecutive seguite da un’emissione prolungata indicano l’esito positivo dell’operazione di armamento.

Esito negativo dell’operazione di armamento
Una rapida ripetizione di emissioni sonore (una ogni 0.25 [s]) segnala il mancato armamento dei motori, dovuto ad un segnale di ingresso errato. Comunemente l’esito negativo di armamento si pu`o presentare nel caso in cui il segnale PWM dovesse avere un duty cycle superiore al 4.75% oppure nel caso in cui il duty cycle dovesse repentinamente variare dal 4.75% a valori superiori. Si consiglia di attendere [2 ÷ 6] [s] prima di iniziare la variazione del duty cycle del segnale per il controllo della velocit`a dei motori. A seguito di vari accertamenti empirici, `e stato stabilito l’intervallo di lavoro dei motori espresso in duty cycle: [6% ÷ 12%].

Risoluzione
Quando si tratta di ESC, con il termine ”risoluzione” non ci si riferisce al numero di campioni di tensione logica distinguibili dal dispositivo, bens`ı allo ”span” di valori del duty cycle distinguibili.
La conoscenza della risoluzione del dispositivo `e utile nella determinazione della variazione minima del duty cycle del segnale PWM di controllo, che a sua volta permette lo sviluppo di un algoritmo di controllo pi`u efficace. Per quanto riguarda il Turnigy Plush 40A, la documentazione ufficiale non specifica la risoluzione del dispositivo; pertanto, si `e fatto riferimento a fonti non ufficiali, che indicano una risoluzione compresa tra 8 e 12 bit.
Si `e optato per uno sviluppo del controllore capace di trascurare la risoluzione del dispositivo, a causa dell’ambiguit`a di tale informazione.

## 2.8 Eliche

Al fine di ottenere una corretta realizzazione progettuale, si rende necessario un minuzioso studio delle eliche da utilizzare. Le eliche e i motori costituiscono un perfetto connubio: se si dovessero scegliere eliche non adeguate, potrebbe non verificarsi la generazione della portanza necessaria al sollevamento del D.P.D.F.
I parametri fondamentali per selezionare un’elica sono il diametro e il passo.
Con il primo si indica il diametro della circonferenza che l’elica descrive durante la rotazione. Con il secondo, invece, si fa riferimento alla distanza teorica che l’elica percorrerebbe lungo il proprio asse in una singola rotazione completa, assumendo un fluido perfettamente solido e assenza di slittamento. Per chiarire il concetto, si pu`o pensare a una vite che compie un giro completo mentre viene inserita nel legno.
Il diametro di un’elica ne influenza:
- Spinta. Un aumento del diametro comporta un aumento della spinta a parit`a di RPM.
- Efficienza. Un aumento del diametro suggerisce un, seppur leggero, aumento dell’efficienza aerodinamica, dal momento che viene mosso un volume d’aria maggiore con una minore velocit`a del getto.
- Coppia del motore richiesta. A parit`a di regime di rotazione, eliche con diametro maggiore oppongono una coppia pi`u elevata da parte del motore per essere mantenute in rotazione. Questo effetto non `e in contrasto con il miglioramento dell’efficienza sopra descritto, poich´e riguarda lo sforzo necessario a sostenere un determinato RPM, non la potenza richiesta per generare la medesima spinta.
- Reattivit`a. Pi`u `e alto il valore del diametro e pi`u `e alta l’inerzia rotazionale, diminuendo la reattivit`a del sistema.

Un elevato diametro `e consigliato per sistemi che hanno l’obiettivo di stabilit`a. Per quanto riguarda il passo, il parametro influisce su:

- Velocit`a in volo orizzontale. Un aumento del passo costituisce un aumento della velocit`a espressa orizzontalmente.
- Spinta. La spinta espressa dall’elica aumenta se se ne aumenta il passo; tuttavia, il diametro dell’elica ha un’influenza maggiore.
- Coppia del motore richiesta. Un maggior passo richiede una maggior coppia indotta dai motori, con conseguente aumento dello stress meccanico.
- Bassa efficienza di hovering. Un aumento del passo comporta un aumento della velocit`a dell’aria mossa dall’elica, con conseguente diminuzione della stabilit`a.

Al contrario, un elevato passo `e tipico dei sistemi focalizzati sulla velocit`a orizzontale e verticale.

### 2.8.1 APC 9x4.5. Caratteristiche fisiche

I dati riportati in [2] indicano le seguenti caratteristiche fisiche:

- Diametro: 9 [in], pari a 228.6 [mm].
- Passo: 4.5 [in], pari a 114.3 [mm].
- Peso: 17.9 [g].
- Materiale: Nylon rinforzato con fibra di vetro (Fiberglass-Reinforced Nylon, FRN ).


Figure 2.13: Elica APC 9x4.5

## 2.9 Hitec HS-82MG Gear micro servo

Il disegno strutturale rende il D.P.D.F suscettibile a rotazioni indesiderate sul piano definito dagli assi X ed Y. Tali perturbazioni possono compromettere la stabilit`a del sistema, determinandone una completa perdita di controllo del mezzo.
Al fine di limitare tali perturbazioni, sono stati integrati due flap, uno relativo al controllo lungo l’asse delle ascisse e uno lungo l’asse delle ordinate.
I flap operano come superfici aerodinamiche di controllo dedicate alla compensazione dei disturbi di rollio e beccheggio. Sono posizionati sulla parte terminale del condotto ed interagiscono con il getto generato dai motori controrotanti. L’intervento si basa sulla modifica della direzione e della velocit`a del flusso d’aria spinto verso il basso. Nel progetto sono stati integrati due servomotori del tipo sopra citato, uno per ogni flap.

### 2.9.1 HS-82 MG Hitec. Caratteristiche fisiche

- Dimensioni: 29.8 × 12.0 × 29.6 [mm].
- Peso: 19.0 [g].


Figure 2.14: HS-82 MG Hitec. Misure

Coppia di stasi
Con coppia di stasi si fa riferimento alla coppia massima che il servomotore pu`o mantenere in posizione statica mentre oppone resistenza ad una forza esterna.
L’HS-82 offre una coppia di stasi pari a: 2.2 [Kg·cm] con 4.8 [V] in ingresso e 2.7 [Kg·cm] a 6.0 [V].

Coppia di stallo
La coppia di stallo `e la massima coppia teorica che il servomotore pu`o generare a velocit`a angolare nulla, vale a dire con carico irremovibile.
Per il dispositivo, la coppia di stallo assume i seguenti valori: 2.8 [Kg·cm] a 4.8 [V] e 3.4 [Kg·cm] a 6.0 [V].

Velocit`a angolare
La velocit`a angolare del dispositivo senza carico `e di 60° in 0.12 [s] a 4.8 [V], mentre `e di 60° in 0.10 [s] a 6.0 [V]. Rapportando ad un singolo grado di variazione, si ha: 1° in 0.0020 [s] a 4.8 [V] e 1° in 0.0017 [s] a 6.0 [V].

Corrente operativa
La corrente operativa `e la corrente assorbita dal servomotore mentre questo `e in movimento. Le informazioni qui sotto riportate si riferiscono al servomotore privo di carico.
Si ha un assorbimento di 220 [mA] per 60° a 4.8 [V] e un assorbimento di 280 [mA] per 60° a 6.0 [V].

Corrente di stallo
Con corrente di stallo si fa riferimento alla massima corrente che il dispositivo assorbe quando `e alimentato in condizione di blocco meccanico. Con questa configurazione, l’assorbimento di corrente ammonta a 1450 [mA] a 4.8 [V] e 1800 [mA] a 6.0 [V].

Corsa operativa
La corsa operativa fa riferimento all’intervallo angolare che il servomotore copre in risposta ad un segnale PWM standard. Nel caso del HS-82, l’intervallo `e pari a 120°.


Figure 2.15: HS-82 MG

### 2.9.2 HS-82 MG Hitec. Caratteristiche tecniche e controllo

Alimentazione
L’intervallo di tensione operativa `e il seguente: [4.8÷6.0] [V].
Per valori di tensione prossimi all’estremo superiore dell’intervallo si hanno dei miglioramenti sulle prestazioni generali del dispositivo. Tuttavia aumentano anche gli effetti dei comportamenti indesiderati, come un aumento della dispersione di calore per effetto Joule o dello stress sull’elettronica interna di controllo.
Per evitare complicazioni, il valore di tensione in ingresso `e stato impostato a 5.5 [V].

Controllo
Il controllo della posizione angolare del rotore avviene tramite segnale PWM. Analogamente al Turnigy Plush 40A, si `e optato per una frequenza di 50 [Hz], mentre l’ampiezza `e pari a 3.3 [V]. Con il fine di ottenere il posizionamento dei flap in configurazione perpendicolare al terreno, `e necessario fornire un impulso di attivazione pari a 1.5 [ms]. Con la frequenza scelta, tale valore corrisponde ad un duty cycle del 7.5%, che rappresenta la posizione

centrale del servomotore.
La documentazione indica una Dead Band Width pari a 5 [µs], ovvero la minima variazione di impulso che il servomotore `e in grado di rilevare. Da ci`o si deduce che la minima variazione angolare attuabile col servomotore `e di 0.5°. Nel contesto applicativo ci`o equivale ad una variazione minima del duty cycle pari a 0.025%. Per ottenere una rotazione oraria del rotore, il comando deve operare nel seguente intervallo di impulsi: 1.5÷2.1 [ms]. L’effetto di rotazione antioraria si ha per: 0.9÷1.5 [ms]. Analizzando il dato di velocit`a dei servomotori, `e possibile determinare il tempo necessario affinch´e il servo compia la minima variazione angolare. Da questa informazione si pu`o calcolare la frequenza massima di variazione della posizione del rotore, che si aggira intorno ai 400 [Hz].

Figure 2.16: HS-82 MG Hitec. Disposizione dei terminali

## 2.10 BNO-055 Bosch Sensortec. Unit`a di misura inerziale e magnetometro

Al fine di controllare l’orientamento nello spazio del D.P.D.F mediante servomotori, si necessita dell’informazione di rotazione del sistema nello spazio di riferimento. Si richiede, dunque, un dispositivo capace di ottenere tale informazione. Il BNO-055 della casa Bosch Sensortec, con la sua accuratezza, `e il miglior candidato per tale responsabilit`a. Il BNO-055 `e un sensore di orientamento assoluto a 9 assi sviluppato da Bosch Sensortec. Il dispositivo `e un System in Package[A] che integra un accelerometro triassiale a 14 bit, un giroscopio triassiale a 16 bit, un sensore geomagnetico triassiale e un microcontrollore Cortex M0

+ a 32 bit incaricato nell’eseguire il software di sensor fusion integrato.
Il software, poc’anzi citato, combina i dati provenienti da accelerometro, giroscopio e magnetometro, fornendo: Quaternioni, Angoli di Eulero come pitch, roll e yaw e Vettori di orientamento lineari e gravitazionali. Nel presente progetto, il chip BNO-055 `e stato acquistato con montaggio su scheda di breakout incluso, dunque nel paragrafo sottostante sono state aggiunte sia le dimensioni/peso del modulo che le dimensioni/peso del chip.

### 2.10.1 BNO-055 Bosch Sensortec. Caratteristiche fisiche

- dimensioni del modulo: 20 × 24 × 2 mm.
- dimensioni del chip: 3.8 × 5.2 × 1.1 mm.
- massa del modulo: 3 g.
- massa del chip: ≈ 150mg.

### 2.10.2 BNO-055 Bosch Sensortec. Infrastruttura di alimentazione, comu-

nicazione ed integrazione del sensore

Alimentazione Il sensore ha due distinti ingressi di alimentazione: il VDD e il VDDIO. Il VDD `e il principale terminale di alimentazione dei sensori. Il valore di tensione iniettabile nell’ingresso in analisi appartiene al seguente intervallo: [2.4÷3.6] [V]. Il VDDIO, invece, `e il distinto ingresso di alimentazione del µC e delle interfacce digitali. In questo caso, il valore di tensione pu`o assumere valori di questo intervallo: [1.7÷3.6] [V]. Tuttavia, il dispositivo `e montato su di una breakout board che offre a disposizione solamente un terminale di alimentazione, chiamato VIN , il quale fornisce, mediante un micro regolatore di tensione, l’alimentazione sia al VDD che al VDDIO. Il valore di tensione in ingresso al terminale VIN appartiene all’intervallo: [2.4÷3.6] [V]. Il BNO-055, inoltre, supporta tre differenti modalit`a di alimentazione: Normal mode, Low power mode e Suspend mode. Per lo sviluppo `e stata scelta la Normal mode.

Protocollo di comunicazione
Il BNO-055 offre la possibilit`a di utilizzare due distinti protocolli di comunicazione seriale, I

2C e UART. Nel presente progetto `e stato utilizzato esclusivamente il protocollo I

| 2C. Come
per il VL53L1X di STMicroelectronics, precedentemente trattato, il sensore dispone della capacit`a di comunicare in Fast Mode, scambiando byte a 400 [kHz] (oltre che in Standard Mode a 100 [kHz]). Anche in questo caso, sia la breakout board che il sensore forniscono i terminali di Serial Data (SDA) e Serial Clock (SCL).


Figure 2.17: BNO-055 Bosch Sensortec. Configurazione dei pin e breakout board

### 2.10.3 Principio di misura dell’accelerometro, giroscopio e magnetometro

Prima di descrivere le features dell’accelerometro, giroscopio e magnetometro installati nel BNO-055, si ritiene necessario dedicare una sezione di approfondimento circa i principi di funzionamento dei sensori precedentemente citati.

Accelerometro
L’accelerometro integrato nel BNO-055 Bosch Sensortec `e di tipo capacitivo M.E.M.S, Micro-Electro-Mechanical System. Il dispositivo consente la misura dell’accelerazione lungo i tre assi

cartesiani.
Il principio di funzionamento si basa sulla rilevazione delle variazioni di capacit`a tra microstrutture mobili e fisse realizzate su un substrato di silicio.
L’elemento sensibile di ciascun asse `e costituito da una massa sospesa, proof mass, vincolata da microtravi elastiche ad una cornice ancorata al substrato. In condizioni di quiete, la massa `e in equilibrio e la capacit`a tra le piastre interdigitate[A] rimangono simmetriche.
Quando il dispositivo `e sottoposto ad un’accelerazione lungo uno degli assi sensibili, la massa inerziale si sposta in direzione opposta a quella dell’accelerazione, generando una variazione differenziale delle capacit`a tra le piastre.
La variazione di capacit`a viene rilevata da un circuito integrato, che la converte in un segnale elettrico, proporzionale alla velocit`a applicata.
Il segnale analogico prodotto, viene successivamente digitalizzato da un convertitore analogico digitale integrato nel chip.

Giroscopio
Il giroscopio integrato nel dispositivo fa parte della categoria M.E.M.S di tipo vibrante, vibrating structure gyroscope, e consente la misura della velocit`a angolare lungo i tre assi cartesiani. Il principio di funzionamento si basa sull’effetto Coriolis, che si manifesta quando una massa in moto oscillatorio subisce una rotazione rispetto ad un sistema di riferimento inerziale. All’interno del sensore, ciascun asse dispone di una o pi`u masse vibranti, le quali vengono mantenute in oscillazione a frequenza costante, mediante un circuito di attuazione elettrostatica. Quando il dispositivo ruota attorno ad uno degli assi la massa subisce una forza di Coriolis data da:
F⃗
c = 2m(⃗v × ⃗ω) | (2.4)

dove m `e la massa oscillante, ⃗v `e la velocit`a della massa nella sua traiettoria vibrante, ⃗ω `e la velocit`a angolare del corpo.
Questa forza induce uno spostamento trasversale rispetto alla direzione di vibrazione, che viene rilevato attraverso variazioni di capacit`a tra elettrodi fissi e mobili, similmente a quanto avviene nell’accelerometro.
Tali variazioni, proporzionali alla velocit`a angolare, vengono convertite in un segnale elettrico mediante un circuito di lettura differenziale e successivamente digitalizzate tramite un convertitore analogico digitale integrato.

Magnetometro
Il sensore integra inoltre un magnetometro ad effetto Hall, sfruttante il fenomeno fisico della tensione di Hall per misurare l’orientamento del dispositivo rispetto al campo magnetico terrestre.
Nella sua forma pi`u semplice, un elemento di Hall `e una sottilissima lamina di materiale conduttore o semiconduttore attraversata da una corrente continua controllata. Se su questa lamina agisce un campo magnetico con componente perpendicolare alla direzione della corrente, i portatori di carica vengono deviati lateralmente della forza di Lorentz:
F = q(⃗v × B⃗ ) | (2.5)

con ⃗v vettore velocit`a della carica e B⃗ vettore campo magnetico. Questa deviazione produce un accumulo di carica ai bordi opposti della lamina e, in regime stazionario, un campo elettrico trasversale che equilibra la forza magnetica. Il risultato `e una differenza di potenziale trasversale, la tensione di Hall: VH che risulta proporzionale alla componente di campo magnetico normale alla superficie del sensore e alla corrente che lo attraversa. Per un elemento Hall omogeneo abbiamo:

VH =

IB⃗⊥

nqs

(2.6)

dove B⃗⊥ `e la componente del campo perpendicolare al piano della lamina; n `e la densit`a di portatori, q `e la carica elementare e s `e lo spessore del film attivo. Nel magnetometro, ogni elemento di Hall `e disposto in modo che la propria normale sia allineata con uno degli assi cartesiani del sistema di riferimento del sensore. Quando il campo magnetico terrestre attraversa il dispositivo, ciascun elemento rileva la proiezione del vettore B⃗ lungo il proprio asse e la trasforma in una tensione di Hall proporzionale.
Dopo l’amplificazione della tensione di Hall e la conversione analogico-digitale, si ottiene un tripletto numerico che rappresenta le tre componenti cartesiane del campo magnetico locale. Il vettore tridimensionale ottenuto viene ricostruito e poi confrontato con il valore atteso del campo geomagnetico.
Tramite la sensor fusion, il magnetometro fornisce il riferimento assoluto dell’azimut, cio`e la direzione del Nord magnetico nel sistema di riferimento solidale al sensore.

### 2.10.4 BNO-055 Bosch Sensortec. Accelerometro, giroscopio e magneto-

metro integrati

L’accelerometro, il giroscopio e il magnetometro sono tutti prodotti da Bosch Sensortec.

Accelerometro
L’accelerometro installato sul BNO-055 appartiene alla famiglia Bosch Sensortec. La sua risoluzione `e di 14 bit. L’accelerometro, per adattarsi ad una vasta gamma di esigenze progettuali, mette a disposizione diversi intervalli di misura:
- [±2] [g]. Modalit`a utile nella rilevazione di piccolissime accelerazioni.
- [±4] [g]. Rappresenta un compromesso equilibrato. Adatto alla maggior parte delle applicazioni, di fatto, quando attiva la sensor fusion, viene impostato tale intervallo di misura.
- [±8] [g] e [±16] [g]. Le modalit`a vengono utilizzate in applicazioni dinamiche estremamente veloci. Questi intervalli difficilmente vengono saturati. Nel presente progetto non sono stati nemmeno presi in considerazione.

L’accelerometro, con attiva la sensor fusion, ha una banda passante di 62.5 Hz.

Giroscopio
Come per l’accelerometro, anche il giroscopio appartiene alla casa Bosch Sensortec. La sua risoluzione, per`o, `e di 16 bit. Anche in questo caso si dispone di diversi intervalli di misura:
- [±125]°/s. Modalit`a pensata per movimenti lenti e precisi, di fatto, possono essere rilevate minime variazioni d’angolo.

- [±250]°/s. Viene conservata la precisione a fronte di un intervallo pi`u permissivo rispetto al precedente.
- [±500]°/s. Questa modalit`a `e adottata dalla maggioranza delle applicazioni.
- [±1000]°/s. La modalit`a `e stata pensata per azionamenti energici.
- [±2000]°/s. Quest’ampio intervallo `e adatto ad applicazioni estremamente veloci. I dati in questa modalit`a sono estremamente rumorosi. Nonostante questo, `e la modalit`a operativa impostata, quando la sensor fusion `e attiva. L’estremo rumore di questa modalit`a, viene attenuato dalla sensor fusion.

A un aumento dell’ampiezza dell’intervallo, corrisponde una diminuzione della qualit`a del dato. Il giroscopio, nel mentre che la sensor fusion `e attiva, ha una banda passante di 32 Hz.

Magnetometro
Anche il magnetometro porta il marchio Bosch Sensortec. Il dispositivo misura campi nell’ordine dei ± 1300 [µT] sugli assi X e Y, e ± 2500 [µT] sull’asse Z. Seguendo il precedente ordinamento degli assi, la risoluzione `e rispettivamente di 13 bit e 15 bit. La documentazione suggerisce un’elevata sensibilit`a ai disturbi (soft iron, hard iron). Difetto che pu`o essere corretto attivando la sensor fusion.
La banda passante del dispositivo, quando `e attivata la sensor fusion `e di 10 Hz.

Sensor fusion
Se presi singolarmente, nessuno dei sensori trattati fornisce misure accurate e complete. Il progetto necessita di un sensore che possa fornire la rotazione del sistema intorno agli assi. Questa rotazione `e ottenuta dall’integrazione della grandezza estratta dal giroscopio, tuttavia, `e intrinsecamente suscettibile ad errori (amplificazione di rumore o bias). L’accelerometro fornisce un’informazione assoluta circa la direzione del vettore gravit`a, da cui possono essere ricavati gli angoli di roll e pitch; in combinazione con il magnetometro si ottiene anche lo yaw. Tuttavia, il limite principale risiede nella presenza di accelerazioni non dovute alla gravit`a, di fatto, rapidi movimenti o vibrazioni producono rumore che interferiscono con la determinazione del vettore gravit`a.
Infine, il magnetometro `e suscettibile alla presenza di elementi ferromagnetici o correnti elettriche, determinando, cos`ı, errori significativi nella misura.
La sensor fusion nasce con l’obiettivo di superare tali limiti, combinando coerentemente le informazioni disponibili. Nei sistemi pi`u evoluti, utilizzati nelle piattaforme di navigazione di veicoli e velivoli, si impiegano filtri come EKF (Filtro di Kalman esteso) o UKF (Filtro di Kalman a Punti Sigma). La documentazione ufficiale del BNO-055 riporta che il microcontrollore presenta un algoritmo di sensor fusion che utilizza il Filtro di Kalman esteso. Nel presente progetto, con il fine di aumentare l’attendibilit`a, l’accuratezza e la stabilit`a della misura, la sensor fusion `e stata sempre tenuta attiva.
A seguire una rappresentazione schematica del System in package BNO-055 Bosch Sensortec.


Figure 2.18: BNO-055 Bosch Sensortec. Architettura di sistema

### 2.10.5 BNO-055 Bosch Sensortec. Modalit`a operative

Il dispositivo di misura fornisce una grande variet`a di segnali di output, che possono essere scelti selezionando l’appropriata modalit`a operativa.
Le modalit`a operative vengono classificate in base all’attivazione o meno del software di sensor fusion, nello specifico distinguiamo tra le Non-Fusion modes e le Fusion modes.

Fusion-modes
Nel momento in cui viene impostata una delle seguenti modalit`a, l’algoritmo di fusione esegue automaticamente, in background, la calibrazione dei sensori.
- IMU (Inertial Measurement Unit). In questa modalit`a di fusione, l’orientamento relativo del BNO-055 nello spazio, `e determinato utilizzando i dati estratti dall’accelerometro e dal giroscopio. La computazione `e veloce, di fatto `e suggerita nelle applicazioni ad alta velocit`a.
- M4G (Magnet for Gyroscope). Simile alla precedente modalit`a, tuttavia, il giroscopio non viene pi`u utilizzato per la rilevazione della rotazione bens`ı la variazione dell’orientamento del magnetometro nel campo magnetico terrestre.
- COMPASS. In questa modalit`a, il BNO-055 opera come una bussola elettronica, stimando l’orientamento sul piano orizzontale rispetto al nord magnetico. Rispetto alle modalit`a IMU e NDOF, che sfruttano il giroscopio per una risposta pi`u pronta e stabile, questa modalit`a utilizza il magnetometro con consumi inferiori ma robustezza minore.
- NDOF. In questa modalit`a, la computazione dell’orientamento del dispositivo, `e eseguita servendosi di tutti i dati provenienti dai sensori. La presente modalit`a `e quella con il pi`u alto consumo di corrente.

Nel presente progetto, la modalit`a NDOF `e sempre stata scelta come modalit`a operativa del BNO-055. A seguire, un’immagine riportata dalla documentazione ufficiale, specificante la frequenza con cui il sensore produce dati in uscita, nel mentre che la sensor fusion `e attiva.

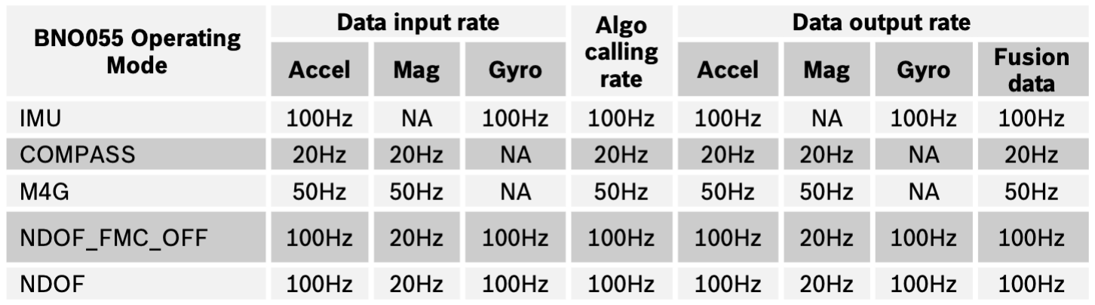
[picture p58: figure]

Figure 2.19: Frequenza di acquisizione della misura per ciascuna modalit`a di fusione sensoriale, tabella ripresa dal datasheet ufficiale

Non-Fusion Modes

- ACCONLY. Il dispositivo fornisce solamente dati grezzi provenienti dall’accelerometro, ponendo magnetometro e giroscopio nella modalit`a a basso consumo.
- MAGONLY. Se impostata, il dispositivo fornisce solamente i dati del magnetometro, sospendendo accelerometro e giroscopio.
- GYROONLY. La modalit`a `e simile alle precedenti, per`o, in questo caso il dispositivo fornisce solo le misure del giroscopio, sospendendo l’accelerometro ed il magnetometro.
- ACCMAG. In questa modalit`a, il sistema fornisce sia le misure dell’accelerometro che quelle del magnetometro. Il giroscopio `e sospeso.
- ACCGYRO. Simile alla precedente, ma il sensore rende disponibili solo le misure dell’accelerometro e del giroscopio.
- MAGGYRO. In questo caso, il sensore fornisce le misure del magnetometro e del giroscopio, sospendendo l’accelerometro.
- AMG (ACC-MAG-GYRO). Con la presente modalit`a, il µC attiva tutti i sensori, fornendo le misure di accelerometro, giroscopio e magnetometro.

## 2.11 VL53L1X ST. Sensore Time-of-Flight per la misurazione a lunga distanza

Al fine di ottenere il comportamento desiderato del D.P.D.F, `e necessario conoscere la distanza da terra mentre quest’ultimo `e in volo. Bisogna, dunque, includere un sensore apposito.
Il VL53L1X di STMicroelectronics `e pienamente coerente con i requisiti precedentemente espressi. Tuttavia, non si `e optato per l’integrazione diretta del sensore della casa STMicroelectronics, si `e preferito acquistare il modulo IRIS11A0J9776 prodotto da Pololu. La breakout board di Pololu, contenente il sensore VL53L1X `e stata scelta per semplificare la fase di configurazione elettronica del dispositivo.

Per comprendere il suo principio di misura, `e opportuno dedicare un’intera sezione alla sua descrizione.

### 2.11.1 Il principio di misura di un sensore Time-of-Flight (ToF)

La modalit`a di misura conosciuta come Time-of-Flight si basa sulla determinazione del tempo impiegato da un segnale, generalmente un impulso luminoso nella banda dell’infrarosso, per compiere un viaggio di andata e ritorno tra un emettitore ed un bersaglio riflettente. In particolare, per il dispositivo in analisi, la sorgente di emissione luminosa `e costituita da un laser a cavit`a verticale (VCSEL), che emette brevi impulsi di luce modulata. Il segnale emesso si propaga nell’ambiente fino ad incontrare un oggetto. Parte della radiazione viene riflessa e raccolta da un rilevatore sensibile alla luce, generalmente un SPAD array o ”Single-Photon Avalanche Diode”. Questo rilevatore `e in grado di registrare fino all’arrivo di singoli fotoni, consentendo una misura estremamente sensibile del tempo di volo. Una volta noto l’intervallo temporale tra l’istante di emissione dell’impulso e quello di ricezione del suo ”eco”, il calcolo della distanza si ottiene applicando la relazione:

d =

c · ∆t
2

(2.7)

dove d `e la distanza dell’oggetto dalla superficie, c `e la velocit`a della luce nel vuoto e ∆t `e il tempo di volo misurato. Il fattore 2 al denominatore tiene conto che il segnale percorre il tragitto due volte, andata e ritorno. I ”ToF” moderni possono utilizzare tecniche avanzate di correlazione temporale o modulazione di fase per migliorare la precisione e la resistenza al rumore ambientale.
Nel caso in esame, il VL53L1X utilizza la tecnologia base ToF o dToF, ”Direct Time-of-Flight”.

### 2.11.2 VL53L1X STMicroelectronics. Caratteristiche fisiche

A seguire, un breve elenco delle principali caratteristiche fisiche:

- dimensioni del chip: 4.90 × 1.25 × 1.56 [mm].
- dimensioni del modulo: 17.50 × 12 × 2.56 [mm].
- massa del chip: 30 [mg].
- massa del modulo: 0.5 [g] (senza i pin header ).

### 2.11.3 VL53L1X STMicroelectronics. Caratteristiche tecniche

Alimentazione
Il sensore presenta un unico ingresso di alimentazione il cui nome `e VDD. L’intervallo di tensione di alimentazione `e: [2.6÷3.5][V]

Protocollo di comunicazione
Il dispositivo `e stato sviluppato per comunicare con il microcontrollore utilizzando esclusivamente il protocollo di comunicazione I

2C. Il sensore dispone della capacit`a di comunicare in Fast Mode, scambiando byte ad una frequenza di 400 [kHz].
Il VL53L1X fornisce i pin di Serial Data (SDA) e di Serial Clock (SCL).

XSHUT e GPIO 1 (Interrupt)
Il VL53L1X dispone di un ingresso denominato XSHUT, che consente di spegnere o riavviare il dispositivo a livello hardware, indipendentemente dall’Host. Portando l’ingresso al livello logico basso, il sensore entra in modalit`a di shutdown, interrompendo le misurazioni e riducendo il consumo di corrente. Al contrario, applicando un livello di tensione alto, il sensore viene inizializzato e reso operativo.
Oltre che l’ingresso XSHUT, il sensore dispone di un’uscita denominata GPIO1, spesso indicata anche come INT (interrupt), la cui funzione principale `e segnalare al microcontrollore eventi o stati del sensore.
Nel presente progetto, il pin XSHUT `e stato utilizzato esclusivamente per il reset forzato del sensore, mentre il GPIO1 `e stato impiegato per segnalare la disponibilit`a della misura, semplificando il firmware, riducendo il carico computazionale e consentendo la gestione della temporizzazione, aspetti che verranno approfonditi nella dedicata sezione nel capitolo Software.


Figure 2.20: Pin Configuration | Figure 2.21: System Block Diagram

L’immagine a sinistra, specifica la disposizione della piedinatura del modulo Pololu (P.C: Pin Configuration), mentre, la figura di destra, rappresenta la suddivisione modulare del VL53L1X (S.B.D: System Block Diagram).

Emettitore Il VL53L1X monta un emettitore laser ad infrarossi con lunghezza d’onda pari a 940 [nm] appartenente alla classe uno. Quest’ultimo fa riferimento alla classificazione di sicurezza stabilita dalla norma internazionale IEC 60825-1. La classificazione ha il dovere di descrivere quanto un’emissione laser possa essere pericolosa per l’interazione umana (occhi, pelle ecc). La normativa organizza gli emettitori in classi, dove ogni classe rappresenta un livello crescente di rischio. Per un laser di classe uno, come quello emesso dal dispositivo, le condizioni operative normali sono considerate sicure per occhi e pelle.


Figure 2.22: VL53L1X, dettaglio sull’emettitore

Field of View (FoV)
Il Field of View `e l’angolo massimo entro il quale il dispositivo rileva un oggetto. Per quanto riguarda l’emettitore in esame, il FoV `e all’incirca di 27°.
A seguire, un’immagine esplicativa del FoV :

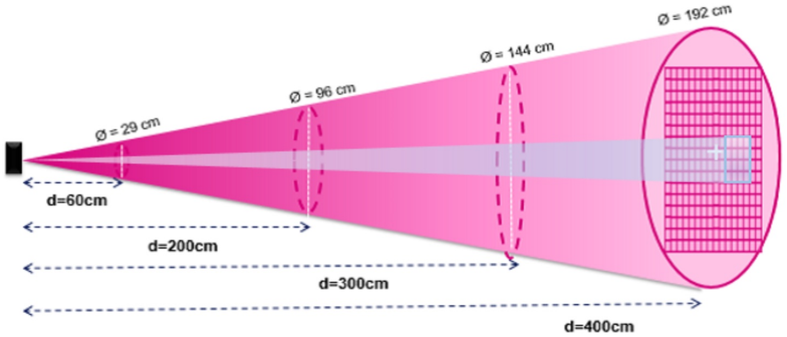
[picture p59: figure]

Figure 2.23: Field of View del VL53L1X

Region-of-interest (R.O.I)
Con Region-Of-Interest si fa riferimento ad un’opzione offerta dal VL53L1X che permette di restringere il Field of View utilizzato nella misura. La funzione `e utile nel caso in cui si voglia migliorare la precisione di misura su oggetti piccoli.
Nel presente progetto, il sensore `e responsabile della misura dell’altitudine del D.P.D.F, per cui la tecnologia (R.O.I) non `e mai stata utilizzata, lasciando il FoV a 27°.

Prestazioni di misura, Timing Budget e modalit`a operative di misura
Il VL53L1X vanta ottime prestazioni di misura, di fatto questa `e accurata e veloce. Il dispositivo ha la capacit`a di misurare distanze fino ai 4 [m] ad una frequenza di 50 [Hz]. Con il fine di coprire una pi`u vasta gamma di applicazioni, il dispositivo fornisce la possibilit`a di selezionare la modalit`a di misura pi`u adatta alla specifica applicazione, oltre che la velocit`a e l’accuratezza. A seguire, una tabella esplicante le varie modalit`a di misura offerte dal dispositivo:

Table 2.1: VL53L1X. Modalit`a di misura

Modalit`a | Range massimo in condizioni di scarsa luce (approssimato) Range massimo con luce ambientale
Short | 136 [cm] | 135 [cm]
Medium | 290 [cm] | 76 [cm]
Long | 360 [cm] | 73 [cm]

Tabella riportata dal datasheet ufficiale del VL53L1X. I valori presentati, sono stati ricavati sotto le seguenti condizioni : timing budget = 100 [ms], bersaglio bianco, riflettanza : 88%, luce ambientale : 200 [kcps/SPAD].

La Short ranging mode `e stata sviluppata per misure ravvicinate ad alta stabilit`a e in ambienti luminosi. La Long range mode `e pensata, invece, per la massimizzazione della portata, al costo di accettare segnali pi`u ”nervosi”. Oltre a quelle precedenti, il dispositivo offre la possibilit`a di selezionare la Medium range mode, che rappresenta un buon compromesso tra distanza operativa e robustezza al rumore.
L’ambiente in cui sono stati effettuati i test di volo `e molto luminoso, inoltre, i fili di sostegno, si sono rivelati un vincolo per l’altitudine massima raggiungibile, cos`ı da non superare i 60 [cm].
Dunque, ai fini progettuali, la Short ranging mode `e stata privilegiata, diventando l’unica modalit`a operativa utilizzata per tutto l’arco del progetto.
Con il fine di una minuziosa gestione della temporizzazione e dell’accuratezza, `e stata sfruttata la funzione di Timing Budget del sensore. Con Timing Budget si fa riferimento al tempo totale che il sensore impiega per eseguire una singola misurazione di distanza. Il Timing Budget `e espresso in [ms] e pu`o assumere i seguenti valori: [20÷1000] [ms]. Un aumento del Timing Budget comporta una riduzione della frequenza di misura ma, al tempo stesso, ne migliora l’accuratezza e la stabilit`a.
La documentazione suggerisce che un Timing Budget di 33 ms offre ottime prestazioni in termini di velocit`a ed accuratezza, per cui, ai fini progettuali, `e stato selezionato tale valore. Per la gestione dell’effettiva temporizzazione `e stato variato l’Inter-Measurement Period, approfondito nella sezione Software.
A seguire, un’immagine riportata direttamente dallo User Manual del VL53L1X, raffigurante le prestazioni di misura a fronte di diversi valori del Timing Budget.


Figure 2.24: VL53L1X, prestazioni di misura

## 2.12 Schema dei collegamenti

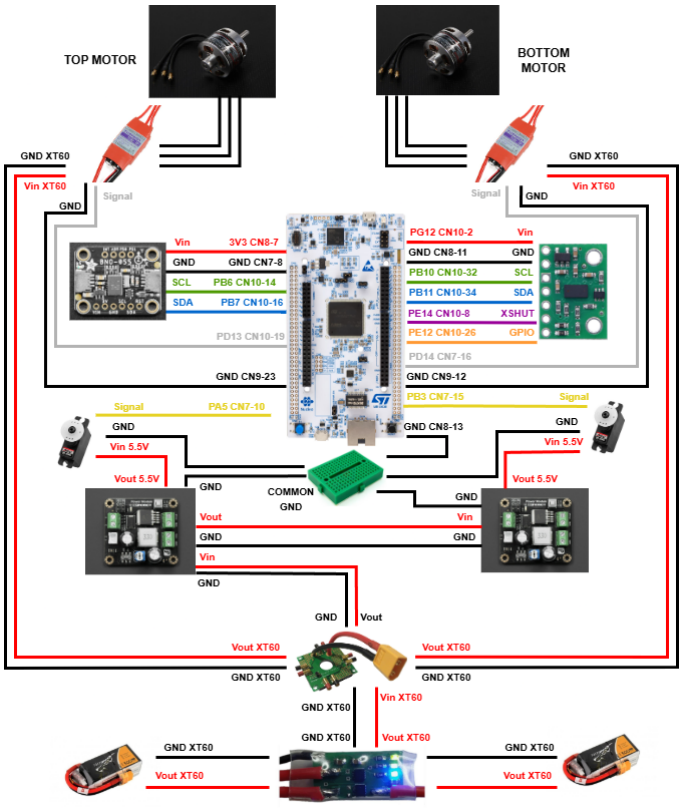
[picture p60: figure]

Figure 2.25: Schema dei collegamenti

### 2.12.1 Tabelle dei collegamenti

Di seguito sono riportati i collegamenti elettrici tra i principali componenti del sistema e la scheda di controllo.

Collegamenti NUCLEO-H745ZI-Q e VL53L1X
Il sensore VL53L1X (STMicroelectronics) `e stato collegato direttamente alla NUCLEO-H745ZI-Q.

VL53L1X | NUCLEO-H745ZI-Q
| Vin | PG12, CN10-2
| GND | GND, CN10-5
SCL | SCL I2C2: PB10, CN10-32
SDA | SDA I2C2: PB11, CN10-34
| XSHUT | PE14, CN10-8
| GPIO | CN10-26

Table 2.2: Collegamenti NUCLEO-H745ZI-Q e VL53L1X

Collegamenti NUCLEO-H745ZI-Q e BNO-055
Il sensore BNO-055 (Bosch Sensortec) `e stato collegato direttamente alla NUCLEO-H745ZI-Q.
BNO-055 | NUCLEO-H745ZI-Q
| Vin | 3.3V, CN8-7
| GND | GND, CN8-11
SCL | SCL I2C1: PB6, CN10-14
SDA | SDA I2C1: PB7, CN10-16

Table 2.3: Collegamenti NUCLEO-H745ZI-Q e BNO-055

Collegamenti DF-Robot, servo e NUCLEO-H745ZI-Q
Per garantire il corretto funzionamento del comparto servomotori `e necessario un riferimento di massa comune. Nel progetto `e stata utilizzata una breadboard esterna per distribuire la massa proveniente dalla NUCLEO-H745ZI-Q (GND, CN7-8). L’alimentazione dei servomotori `e stata prelevata direttamente dall’uscita dei convertitori di tensione collegati in serie.
DF-Robot roll | Roll-servo | Common GND | NUCLEO-H745ZI-Q
Vout-3 | Vin (5.5V) | - | -
Vout-GND | GND | C.GND | GND, CN7-8
- | Signal | - | TIM2-CH1: PA5, CN7-10

Table 2.4: Collegamenti NUCLEO-H745ZI-Q e Roll-servo

DF-Robot pitch | Pitch-servo | Common GND | NUCLEO-H745ZI-Q
Vout-3 | Vin (5.5V) | - | -
Vout-GND | GND | C.GND | GND, CN7-8
- | Signal | - | TIM2-CH2: PB3, CN7-15

Table 2.5: Collegamenti NUCLEO-H745ZI-Q e Pitch-servo

Collegamenti Power Distribution Module, ESC e NUCLEO-H745ZI-Q
Per il comparto motori, gli ESC sono collegati al Power Distribution Module, a sua volta connesso al comparto batterie-PSM e ai motori tramite i rispettivi connettori trifase. Il terminale di massa degli ESC deve condividere la massa della NUCLEO-H745ZI-Q, mentre il terminale Signal deve essere connesso al pin PWM della scheda.
Power Distribution Module | Top-motor-ESC | NUCLEO-H745ZI-Q
Vout XT-60 | Vin XT-60 | -
GND XT-60 | GND XT-60 | -
- | Signal | TIM4-CH2: PD13, CN10-19
- | GND | GND

Table 2.6: Collegamenti NUCLEO-H745ZI-Q e Top-motor-ESC

Power Distribution Module | Bottom-motor-ESC | NUCLEO-H745ZI-Q
Vout XT-60 | Vin XT-60 | -
GND XT-60 | GND XT-60 | -
- | Signal | TIM4-CH3: PD14, CN7-16
- | GND | GND

Table 2.7: Collegamenti NUCLEO-H745ZI-Q e Bottom-motor-ESC

Nota: il dispositivo che riceve il segnale PWM deve condividere lo stesso riferimento di massa del dispositivo che genera tale segnale.

## 3 Software

Il firmware di controllo del Double Propeller Ducted-Fan (DPDF) `e stato sviluppato con l’obiettivo di ottenere una condizione di hovering sufficientemente stabile del velivolo. L’implementazione `e stata realizzata in linguaggio C all’interno di STM32CubeIDE (versione 1.16.1), utilizzando i flussi di configurazione hardware, generazione codice basata su HAL (Hardware Abstraction Layer ), compilazione e debug integrati nell’ambiente. Per la configurazione delle periferiche del microcontrollore STM32H745ZI-TQ6 `e stato impiegato STM32CubeMX (versione 6.12.1).
Per i sensori BNO055 (Bosch Sensortec) e VL53L1X (STMicroelectronics) sono stati integrati i driver ufficiali dei produttori, nativamente platform-agnostic, e adattati al contesto HAL tramite un sottile livello di interfaccia per comunicazione, interrupt e gestione dei pin. In coerenza con la natura di questa attivit`a, che `e una relazione di progetto e non una tesi, `e importante evidenziare che una parte del sub-firmware di base (in particolare l’infrastruttura iniziale e i moduli driver) era gi`a stata sviluppata dal gruppo precedente: il lavoro attuale si `e concentrato su analisi, integrazione, validazione e documentazione tecnica del codice nel contesto del progetto DPDF.
Nelle sezioni successive vengono quindi descritti i diagrammi di flusso e l’organizzazione del firmware adottata nel progetto, mantenendo la terminologia operativa usata nel codice (i termini procedura e funzione sono considerati equivalenti in questa relazione).

## 3.1 Diagrammi di flusso

Nella presente sezione sono stati riportati i diagrammi di flusso esplicativi del funzionamento del firmware. Poich´e i driver di gestione del VL53L1X e BNO-055 sono esterni allo sviluppo, sono stati riportati anche i diagrammi di flusso di questi, in tal modo da specificare la procedura di estrazione dell’informazione.

### 3.1.1 Diagramma di flusso del fimware

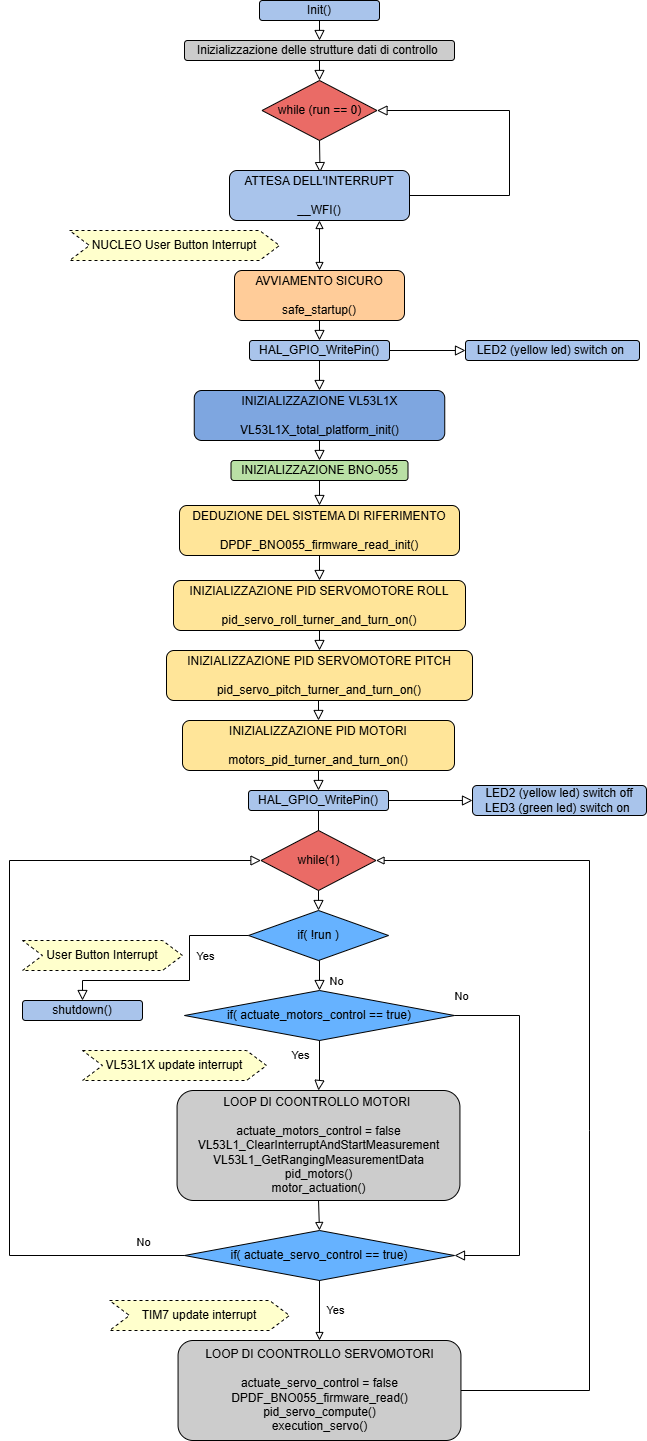
[picture p61: figure]

Figure 3.1: Diagramma di flusso del funzionamento del firmware

### 3.1.2 Diagramma di flusso del VL53L1X per misurazione di quota

Il presente diagramma di flusso, ripreso dal datasheet relativo al driver di gestione del VL53L1X [15], `e illustrativo della sequenza di invocazione di funzione da operare per estrarre l’informazione di misura di quota dal sensore. Successivamente alla funzione StartMeasurement(), il diagramma offre tre alternative circa la modalit`a con cui verificare la presenza di una nuova misura. Nel caso in esame, viene adottata la Interrupt mode, applicata nel loop di controllo del comparto motori.


Figure 3.2: Diagramma di flusso del VL53L1X per la misurazione della quota

## 3.2 Gestione singoli componenti

Il firmware `e organizzato in modo modulare: il file main.c contiene l’orchestrazione (startup sicuro, inizializzazioni e ciclo principale), mentre la logica di controllo `e distribuita in moduli dedicati:

- Motors PID and manager.c: gestione motori, PID di quota, startup sicuro e shutdown;
- Servos PID and manager.c: lettura IMU, PID di roll/pitch e attuazione servomotori;
- DPDF var def.h: costanti e strutture dati condivise tra i moduli.

Questa scelta riduce la complessit`a del main e separa chiaramente l’elaborazione “lenta” (nel ciclo principale) dalla gestione eventi “rapida” (nelle interrupt). In particolare, le callback di interrupt sono implementate in Motors PID and manager.c e non eseguono direttamente i controlli PID: si limitano a impostare flag condivise (actuate motors control, actuate servo control) poi consumate nel while(1). In questo modo il tempo passato in ISR resta ridotto e il comportamento `e pi`u prevedibile.

### 3.2.1 Definizione delle costanti e delle strutture condivise

I limiti dei comandi PWM e i parametri comuni sono dichiarati tramite macro in DPDF var def.h. In particolare:

- CCR VALUE FOR MOTOR ACT definisce il duty-cycle di armamento ESC;
- UPPER/LOWER LIMIT TOP MOTOR SATURATION definiscono i limiti del PID quota;
- UPPER/CENTER/LOWER SERVO SATURATION definiscono i limiti dei servomotori.

Sono inoltre definite due strutture PID: pid prmts t (motori) e pid controller t (servi), entrambe comprensive di guadagni e stato interno (errore precedente e termine integrale). La distinzione in due strutture riflette due strategie diverse di anti-windup implementate nei due rami di controllo.

1 | #define CCR_VALUE_FOR_MOTOR_ACT | 712
2 | #define UPPER_LIMIT_TOP_MOTOR_SATURATION | 900
3 | #define LOWER_LIMIT_TOP_MOTOR_SATURATION | 800
4 | #define UPPER_LIMIT_SERVO_SATURATION | 1545
5 | #define CENTER_UPPER_LOWER_SERVO_SATURATION | 1125
6 | #define LOWER_LIMIT_SERVO_SATURATION | 705

7
8 | typedef struct {
9 | float prop_coeff;
10 | float int_coeff;
11 | float der_coeff;
12 | float sampl_time;
13 | float err_old;
14 | float int_term;
15 | } pid_prmts_t;

16
Listing 3.1: Esempio di costanti firmware usate per evitare “numeri magici”

### 3.2.2 Gestione quota: VL53L1X + PID motori

Il controllo della quota usa il sensore ToF VL53L1X come misura e pilota i due ESC con lo stesso comando PWM, cos`ı da variare la portanza totale senza introdurre sbilanciamenti intenzionali (TIM4->CCR2 = TIM4->CCR3).
Dal punto di vista .ioc, i blocchi principali coinvolti sono:
- periferiche I2C per la comunicazione sensori (nel progetto risultano inizializzate I2C1 e I2C2);
- TIM4 CH2-CH3 in PWM a 50 Hz per i due ESC;
- EXTI su pin data-ready del VL53L1X per attivare il loop motori a nuova misura disponibile.

La logica PID `e implementata con anti-windup a saturazione (clamping): se l’uscita supera i limiti consentiti, viene bloccata; il termine integrale viene aggiornato solo in zona lineare. Nel main l’elaborazione quota parte quando la callback EXTI del pin GPIO PIN 12 imposta la flag actuate motors control. Nel ciclo principale, alla ricezione dell’evento, il firmware esegue in sequenza: clear interrupt del VL53L1X, lettura misura, calcolo PID, scrittura PWM.

1 | uint16_t pid_motors(pid_prmts_t *poi, int16_t ranging_measurement, uint16_t ref) {
2 | if (!poi || poi->sampl_time <= 0.0f)
3 | return 0; // Prevent division-by-zero crash

4
5 | // Cast to float first to prevent hidden signed/unsigned promotion bugs
6 | float err = (float) ref - (float) ranging_measurement;

7
8 | float p_term = poi->prop_coeff * err;

9
10 | // Use current ’err’ (Backward Euler) for standard, more stable integration
11 | float new_int_term = poi->int_term + (poi->int_coeff * poi->sampl_time * err);

12
13 | float d_term = (poi->der_coeff / poi->sampl_time) * (err - poi->err_old);

14
15 | poi->err_old = err; // Update state for next cycle

16
17 | float ing = p_term + new_int_term + d_term;

18
19 | /******************** ANTI-WIND-UP FILTER, CLAMPING METHOD ********************/
20 | if (ing > UPPER_LIMIT_TOP_MOTOR_SATURATION) {
21 | ing = UPPER_LIMIT_TOP_MOTOR_SATURATION;
22 | } else if (ing < LOWER_LIMIT_TOP_MOTOR_SATURATION) {
23 | ing = LOWER_LIMIT_TOP_MOTOR_SATURATION;
24 | } else {
25 | // Only accumulate integration term if output is NOT saturated
26 | poi->int_term = new_int_term;
27 | }

28
29 | return (uint16_t) ing;
30 | }
Listing 3.2: PID quota motori con saturazione anti-windup

L’attuazione viene poi applicata direttamente ai registri CCR dei due canali PWM di TIM4.

1 void motor_actuation(uint16_t ing_motor) {

2
3 | TIM4->CCR2 = ing_motor;
4 | TIM4->CCR3 = ing_motor;
Listing 3.3: Attuazione simultanea dei due motori

### 3.2.3 Gestione assetto: BNO055 + PID servomotori

Il controllo di assetto utilizza il BNO055 in modalit`a NDOF. In fase di inizializzazione viene acquisito l’assetto iniziale (offset) e successivamente si lavora sulle rotazioni relative lungo gli assi di interesse.
Dal punto di vista .ioc, i blocchi principali sono:
- periferica I2C per lettura IMU;
- TIM2 CH1-CH2 in PWM a 50 Hz per roll-servo e pitch-servo;
- TIM7 come base tempi periodica per attivare il loop servo.

Il PID dei servomotori `e implementato con offset centrale (posizione 0°) e anti-windup condizionale: quando l’uscita `e saturata, l’integratore continua ad accumulare solo se l’errore tende a riportare il comando dentro il range attuabile. Il loop di assetto viene attivato periodicamente da TIM7 tramite la flag actuate servo control. Anche in questo caso la callback imposta solo la flag, mentre lettura IMU, calcolo PID e aggiornamento CCR1/CCR2 avvengono nel main.

1 uint16_t pid_servo_compute(pid_controller_t *pid, float ref, float angle_value) {

2
3 | // Compute error
4 | float error = ref - angle_value;

5
6 | // Proportional
7 | float p_term = pid->kp * error;

8
9 | // Integral (Euler forward method)
10 | float i_term_unclamped = pid->int_term + (pid->ki * pid->sample_time * error);

11
12 | // Derivative (backward difference)
13 | float d_term = (pid->kd / pid->sample_time) * (error - pid->e_old);

14
15 | // Total effort
16 | float control_effort = p_term + i_term_unclamped + d_term;

17
18 | // Consider offset
19 | float u_out = CENTER_UPPER_LOWER_SERVO_SATURATION + control_effort;

20
21 | // Anti-Windup (Clamping method) and saturation
22 | uint16_t final_pwm;

23
24 | if (u_out > UPPER_LIMIT_SERVO_SATURATION) {
25 | final_pwm = UPPER_LIMIT_SERVO_SATURATION;

26 | // Conditional integration: update integral only if error help with saturation
27 | if (error < 0)
28 | pid->int_term = i_term_unclamped;

29
30 | } else if (u_out < LOWER_LIMIT_SERVO_SATURATION) {
31 | final_pwm = LOWER_LIMIT_SERVO_SATURATION;
32 | // Conditional integration: update integral only if error help with saturation
33 | if (error > 0)
34 | pid->int_term = i_term_unclamped;

35
36 | } else {
37 | // Linear
38 | final_pwm = (uint16_t) u_out;
39 | pid->int_term = i_term_unclamped; // Normal update
40 | }

41
42 | // Save error for the computation in the next loop
43 | pid->e_old = error;

44
45 | return final_pwm;
46 | }
Listing 3.4: PID servomotori per controllo roll/pitch

L’attuazione finale aggiorna i registri CCR1 e CCR2 di TIM2.

1 void execution_servo(uint16_t ingresso_roll, uint16_t ingresso_pitch) {

2
3 | TIM2->CCR1 = ingresso_roll;
4 | TIM2->CCR2 = ingresso_pitch;
5 | }
Listing 3.5: Scrittura del comando PWM ai due servomotori

## 3.3 Funzionamento complessivo

L’esecuzione complessiva segue una sequenza deterministica ed evento-driven:

1. Safe startup: avvio consentito solo dopo pressione del pulsante utente; segue conto alla rovescia visivo tramite LED (gestito da TIM6) e attesa in low-power ( WFI());
2. Inizializzazione sensori: reset/abilitazione VL53L1X, inizializzazione BNO055 e acquisizione offset iniziale;
3. Inizializzazione attuatori: avvio PWM servi e motori, configurazione PID;
4. Arming ESC: comando PWM fisso di armamento (valore 712) e attesa stabilizzazione (5 s);
5. Controllo concorrente nel main loop: quota su evento data-ready VL53L1X (flag actuate motors control), assetto su evento periodico TIM7 (flag actuate servo control);
6. Shutdown sicuro: su pressione del pulsante utente durante l’esecuzione (toggle della variabile run), riporta attuatori in stato sicuro e blocca il sistema.

La porzione seguente mostra la parte centrale del main: inizializzazione dei moduli, attivazione del controllo e doppio loop evento-driven per quota e assetto.

1
2 | HAL_UART_Transmit(&huart3, (uint8_t*) "Waiting safe startup (press user button)...\n",
strlen("Waiting safe startup (press user button)...\n"),
3 | HAL_MAX_DELAY);

4
5 | while (!run) {
6 | __WFI();
7 | }

8
9 | HAL_UART_Transmit(&huart3, (uint8_t*) "Initialization starting in 5 seconds\n", strlen("
Initialization starting in 8 seconds\n"),
10 | HAL_MAX_DELAY);

11
12 | safe_startup(&htim6);

13
14 | HAL_GPIO_WritePin(GPIOG, GPIO_PIN_12, GPIO_PIN_SET); // Power the altitude sensor

15
16 | /*
| */
17 | /* | SENSOR INITIALIZATION
*/
18 | /*
| */

19
20 | /*------------------------------ VL53L1X INITIALIZATION ------------------------------*/

21
22 | // Hardware reset the sensor with XSHUT (PE14 starts LOW from MX_GPIO_Init)
23 | HAL_GPIO_WritePin(GPIOE, GPIO_PIN_14, GPIO_PIN_SET);
24 | HAL_Delay(10);

25
26 | VL53L1_Error status = VL53L1_total_platform_init(Dev, 0x52, VL53L1_I2C, 400, 20000, 33);

27
28 | if (status == VL53L1_ERROR_NONE) {
29 | | HAL_UART_Transmit(&huart3, (uint8_t*) "Altitude sensor (VL53L1X) initialized\n",
strlen("Altitude sensor (VL53L1X) initialized\n"),
30 | HAL_MAX_DELAY);
31 | } else {
32 | | sprintf(msg_VL53L1X, "Altitude sensor (VL53L1X) initialization error: %d\n", status);
33 | | HAL_UART_Transmit(&huart3, (uint8_t*) msg_VL53L1X, strlen(msg_VL53L1X), HAL_MAX_DELAY
| );
34 | return 1;
35 | }

36
37 | /*------------------------------ BNO055 INITIALIZATION ------------------------------*/

38
39 | myBNO.bus_read = bus_read;
40 | myBNO.bus_write = bus_write;
41 | myBNO.delay_msec = delay_func;
42 | myBNO.dev_addr = BNO055_I2C_ADDR1;
43 | bno055_init(&myBNO);
44 | bno055_set_operation_mode(BNO055_OPERATION_MODE_NDOF);

45 | //bno055_calibration();
46 | DPDF_BNO055_firmware_read_init(axis_zero_rot);
47 | HAL_UART_Transmit(&huart3, (uint8_t*) "IMU (BNO055) initialized\n", strlen("IMU (BNO055)
initialized\n"), HAL_MAX_DELAY);

48
49 | /*
| */
50 | /* | ACTUATORS AND PID INITIALIZATIONS
| */
51 | /*
| */

52
53 | HAL_TIM_PWM_Start(&htim2, TIM_CHANNEL_1); // Start PWM for TIM1-CH2 (roll servo)
54 | HAL_TIM_PWM_Start(&htim2, TIM_CHANNEL_2); // Start PWM for TIM2-CH2 (pitch servo)

55
56 | pid_servo_init(&pid_roll, 2.0f, 0.0f, 0.0f, 0.01f);
57 | pid_servo_init(&pid_pitch, 2.0f, 0.0f, 0.0f, 0.01f);

58
59 | HAL_TIM_PWM_Start(&htim4, TIM_CHANNEL_2); // Start PWM for TIM4-CH2: top motor
60 | HAL_TIM_PWM_Start(&htim4, TIM_CHANNEL_3); // Start PWM for TIM4-CH3: bottom motor

61
62 | motors_pid_turner_and_turn_on(6, 0, 0, 0.033f, &motor_pid_params);
63 | HAL_UART_Transmit(&huart3, (uint8_t*) "Initialization completed!\n", strlen("
Initialization completed!\n"), HAL_MAX_DELAY);

64
65 | /*
| */
66 | /* | ESC SETUP
| */
67 | /*
| */

68
69 | // Setup signal for ESC (duty cycle at 4.75%)
70 | motor_actuation(712);

71
72 | HAL_UART_Transmit(&huart3, (uint8_t*) "Wait 5 seconds for ESC setup...\n", strlen("Wait 5
seconds for ESC setup...\n"), HAL_MAX_DELAY);

73
74 | // Delay for ESC setup
75 | HAL_Delay(5000);

76
77 | HAL_UART_Transmit(&huart3, (uint8_t*) "ESC setup completed (ensure no more beeps are
| emitted)\n",
78 | strlen("ESC setup completed (ensure no more beeps are emitted)\n"), HAL_MAX_DELAY
| );

79
80 | HAL_TIM_Base_Start_IT(&htim7); | // start interrupt for servo control actuation

81
82 | HAL_GPIO_WritePin(GPIOE, GPIO_PIN_1, GPIO_PIN_RESET); // turn off LD2 (yellow led)
83 | HAL_GPIO_WritePin(GPIOB, GPIO_PIN_0, GPIO_PIN_SET); // turn on LD1 (green led)

84
85 | // Start measurement LAST because first edge arrives ~25ms from now

86 | VL53L1_StartMeasurement(Dev);

87
88 | /* USER CODE END 2 */

89
90 | /* Infinite loop */
91 | /* USER CODE BEGIN WHILE */
92 | while (1) {

93
94 | // Break out of main loop immediately if shutdown is flagged
95 | if (!run) {
96 | HAL_UART_Transmit_DMA(&huart3, (uint8_t*) "User requested shutdown\n", strlen("
| User requested shutdown\n"));

97
98 | shutdown();
99 | break;
100 | }

101
102 | /*--------------------------------------------- MOTOR ACTUATION AND CONTROL
| ---------------------------------------------*/

103
104 | if (actuate_motors_control) {
105 | actuate_motors_control = false;

106
107 | VL53L1_ClearInterruptAndStartMeasurement(Dev);

108
109 | VL53L1_GetRangingMeasurementData(Dev, &rangingData);

110
111 | uint16_t pwm_motors = pid_motors(&motor_pid_params, rangingData.RangeMilliMeter,
| ref_altitude);

112
113 | motor_actuation(pwm_motors);

114
115 | sprintf(msg_VL53L1X, "%d,%d\n", rangingData.RangeMilliMeter, pwm_motors);
116 | HAL_UART_Transmit_DMA(&huart3, (uint8_t*) msg_VL53L1X, strlen(msg_VL53L1X));

117
118 | }

119
120 | /*--------------------------------------------- SERVO-MOTOR ACTUATION AND CONTROL
| ---------------------------------------------*/

121
122 | if (actuate_servo_control) {
123 | actuate_servo_control = false;

124
125 | DPDF_BNO055_firmware_read(axis_zero_rot, axis_rotation_ist);

126
127 | uint16_t pwm_roll = pid_servo_compute(&pid_roll, ref_roll_pitch,
| axis_rotation_ist->rot_x);
128 | uint16_t pwm_pitch = pid_servo_compute(&pid_pitch, ref_roll_pitch,
| axis_rotation_ist->rot_y);

129
130 | execution_servo(pwm_roll, pwm_pitch);

131
132 | sprintf(msg_bno, "%ld,%ld,%d,%d\n", axis_rotation_ist->rot_x, axis_rotation_ist->
| rot_y, pwm_roll, pwm_pitch);
133 | HAL_UART_Transmit_DMA(&huart3, (uint8_t*) msg_bno, strlen(msg_bno));

134

135 | }
Listing 3.6: Sequenza di inizializzazione e ciclo principale di controllo

La gestione degli eventi asincroni (pulsante utente, data-ready del sensore quota, base tempi servo) `e concentrata nelle callback di interrupt:

1 void HAL_TIM_PeriodElapsedCallback(TIM_HandleTypeDef *htim) {

2
3 | if (htim->Instance == TIM6) {
4 | // Tim 6 emits at 2 Hz
5 | HAL_GPIO_TogglePin(GPIOE, GPIO_PIN_1); // Toggle LD2 (yellow led)
6 | current_number_of_toggles++;
7 | }

8
9 | if (htim->Instance == TIM7) {
10 | actuate_servo_control = true;
11 | }

12
13 }

14
15 | void HAL_GPIO_EXTI_Callback(uint16_t GPIO_Pin) {
16 | // When user button is pressed (used for safe startup)
17 | if (GPIO_Pin == GPIO_PIN_13) {
18 | run = !run;
19 | }

20
21 | // When VL53L1X data is ready, trigger PID
22 | if (GPIO_Pin == GPIO_PIN_12) {
23 | actuate_motors_control = true;
24 | }

25
26 }
Listing 3.7: Callback di interrupt per startup e scheduling dei controlli

## 4 Test e risultati

Dedicate un capitolo a tutti i test effettuati con relativi risultati, includete sia i test finali relativi al funzionamento complessivo, sia i test delle singole parti (se significativi). Descrivete in dettaglio le condizioni in cui sono stati svolti i test in modo che siano ripetibili. Durante i test fate dei video e acquisite i dati (es usando la funzione di log di Putty), per i test pi`u rilevanti `e opportuno consegnare anche questo materiale per documentare i test effettuati. Nella relazione riportate i risultati con dei grafici come quello in Figura 4.1 (inserite sempre nei grafici le label sugli assi con grandezza e relativa unit`a di misura). Commentate in modo critico i risultati ottenuti, evidenziando sia quelli positivi sia quelli negativi.

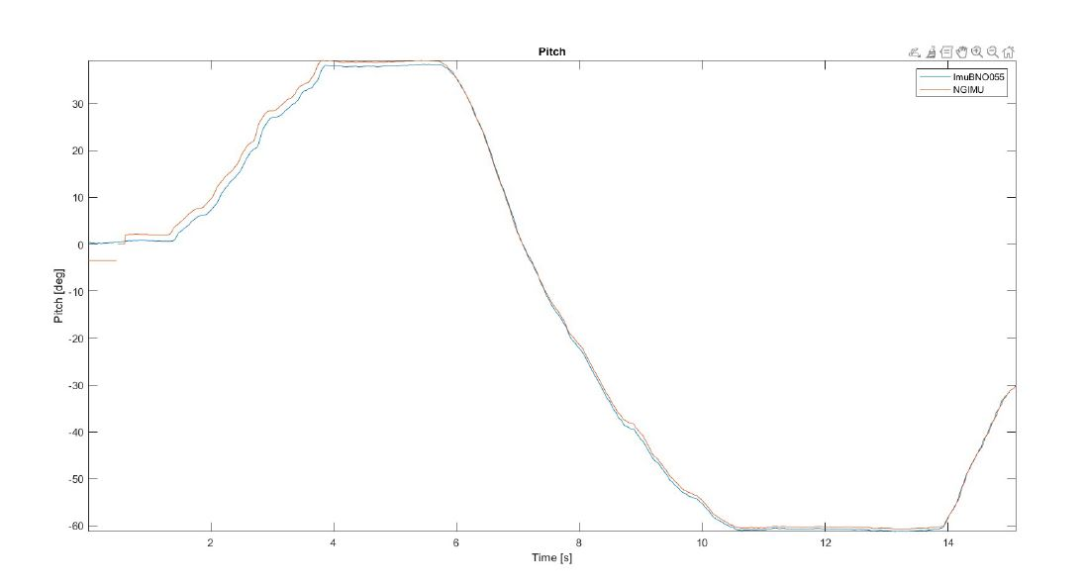
[picture p62: figure]

Figure 4.1: Esempio di grafico

## 4.1 Test1

Per ogni test riportate: cosa state testando, in che condizioni si `e svolto il test, riferimenti a video/file di log che consegnate insieme a relazione e codice, grafici dei risultati, commento dei risultati.

## 4.2 Test2

## Conclusioni e sviluppi futuri

Riassumere brevemente il lavoro svolto rispetto al task assegnato, evidenziando quali risultati sono stati raggiunti e quali no. Se ci sono aspetti del task non completati spiegare quali sono stati i problemi riscontrati in merito.
Inserire considerazioni personali su possibili sviluppi futuri dell’attivit`a svolta (idee per migliorarla che non avete avuto modo di sperimentare, aspetti che suggerite di approfondire, problemi da risolvere..).

## A Appendice1

Se necessario ricorrete alle appendici per spiegare le parti ”di contorno” dell’attivit`a svolta e/o ci`o che non riuscite ad inserire nello schema generale dei capitoli della relazione (es acquisizione dei dati con Matlab).

## Bibliografia

[1] Manufacturer, “Dc motor driver documentation,” 2024. Datasheet e manuale utente.
[2] Gruppo di lavoro precedente, “Relazione di riferimento del laboratorio,” 2023. Documento interno del corso.
