diego-tag/ducted-fan/relazione/precedente/Chapter2-HARDWARE/Figures/FotoEffettivaDispositivo_PowerSafeTwinADV.gif

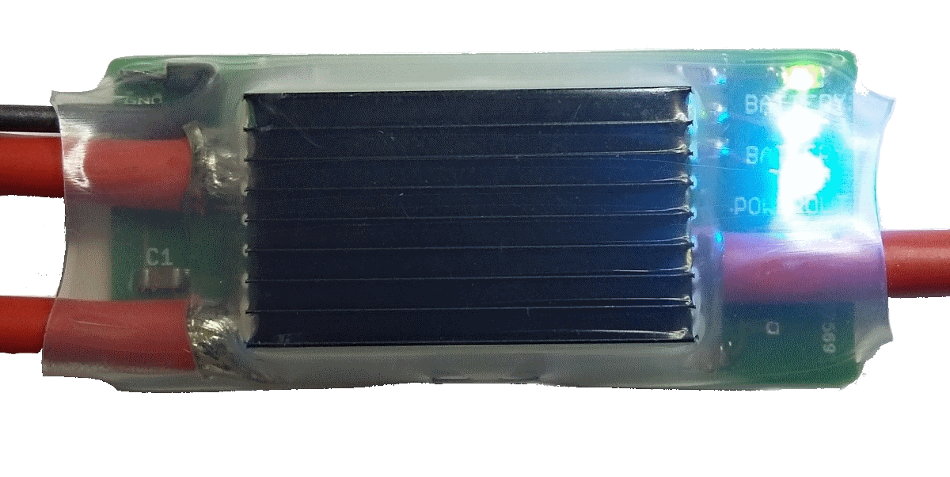
relazione/precedente/Chapter2-HARDWARE/Figures/FotoEffettivaDispositivo_PowerSafeTwinADV.gif
