diego-tag/ducted-fan/relazione/precedente/Chapter2-HARDWARE/Figures/FoV _VL53L1X.webp

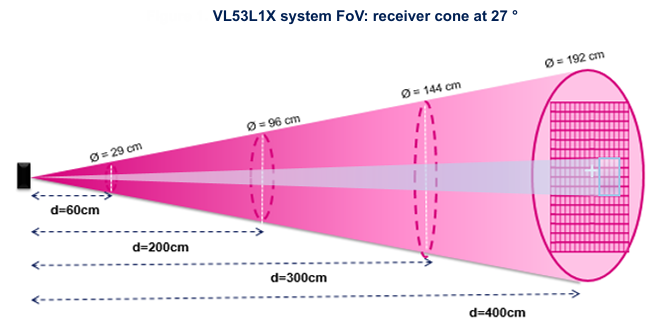
relazione/precedente/Chapter2-HARDWARE/Figures/FoV _VL53L1X.webp
