diego-tag/ducted-fan/relazione/precedente/Chapter2-HARDWARE/Figures/tattu-lipo-4s-14-8v-1300mah-75c-presa-batteria-xt60.jpg

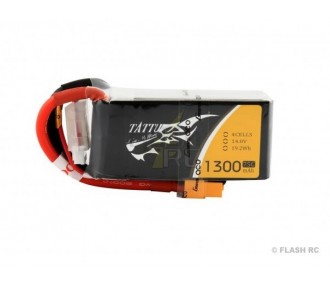
relazione/precedente/Chapter2-HARDWARE/Figures/tattu-lipo-4s-14-8v-1300mah-75c-presa-batteria-xt60.jpg
