diego-tag/ducted-fan/relazione/precedente/chapter3-SOFTWARE/Figures/GPIO_Pins2.png

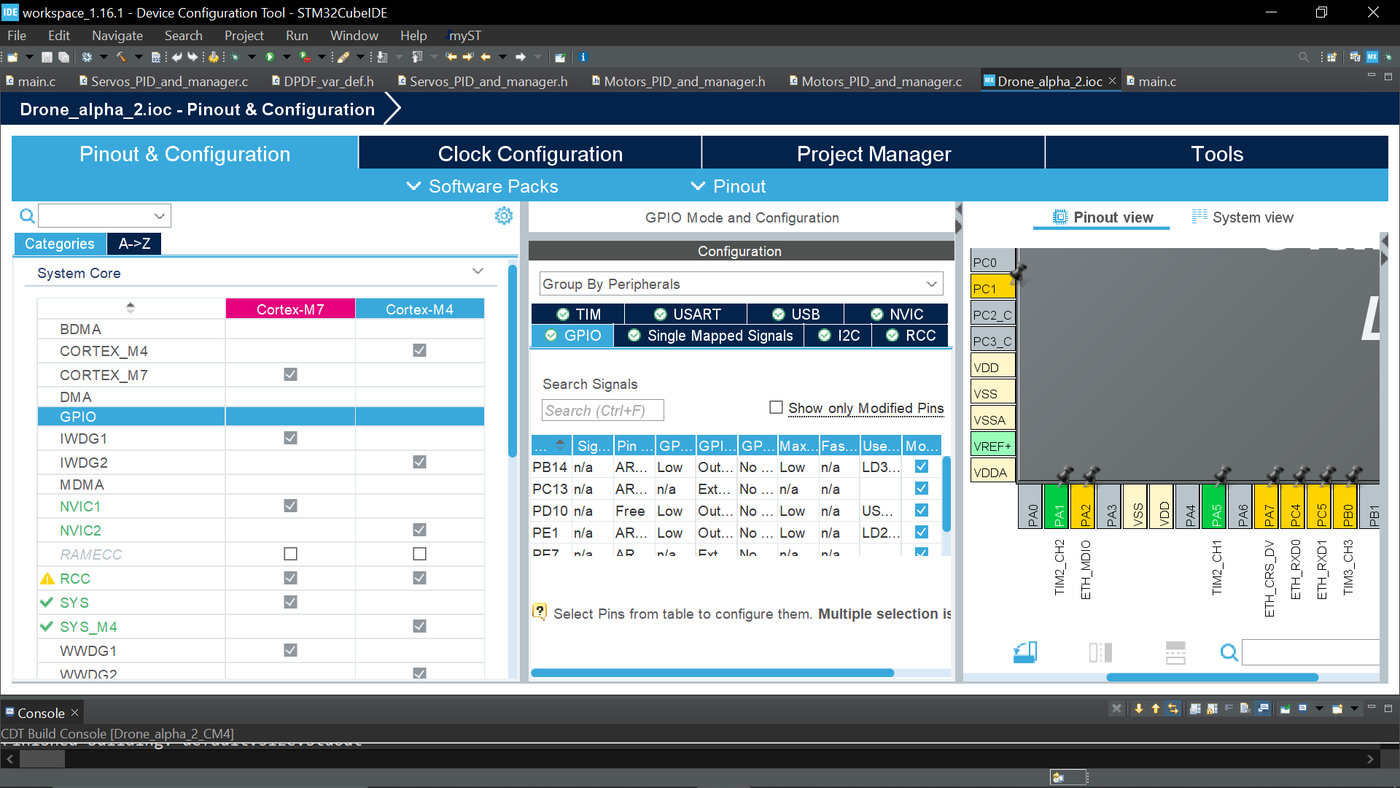
relazione/precedente/chapter3-SOFTWARE/Figures/GPIO_Pins2.png
