diego-tag/ducted-fan/relazione/precedente/chapter3-SOFTWARE/Figures/I2C1_protocollo di comunicazione.png

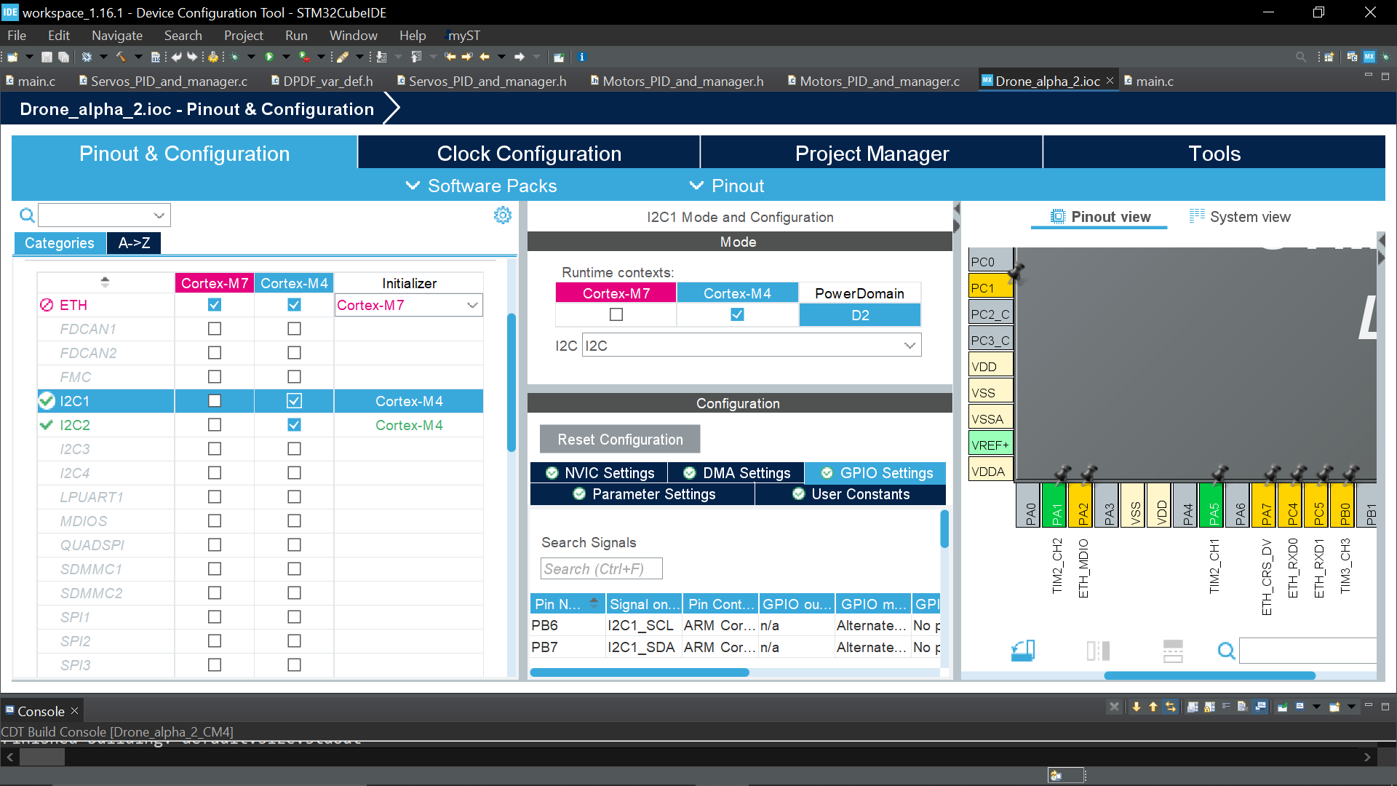
relazione/precedente/chapter3-SOFTWARE/Figures/I2C1_protocollo di comunicazione.png
