diego-tag/ducted-fan/relazione/precedente/chapter3-SOFTWARE/Figures/NVIC_Interrupt attive - Copia.png

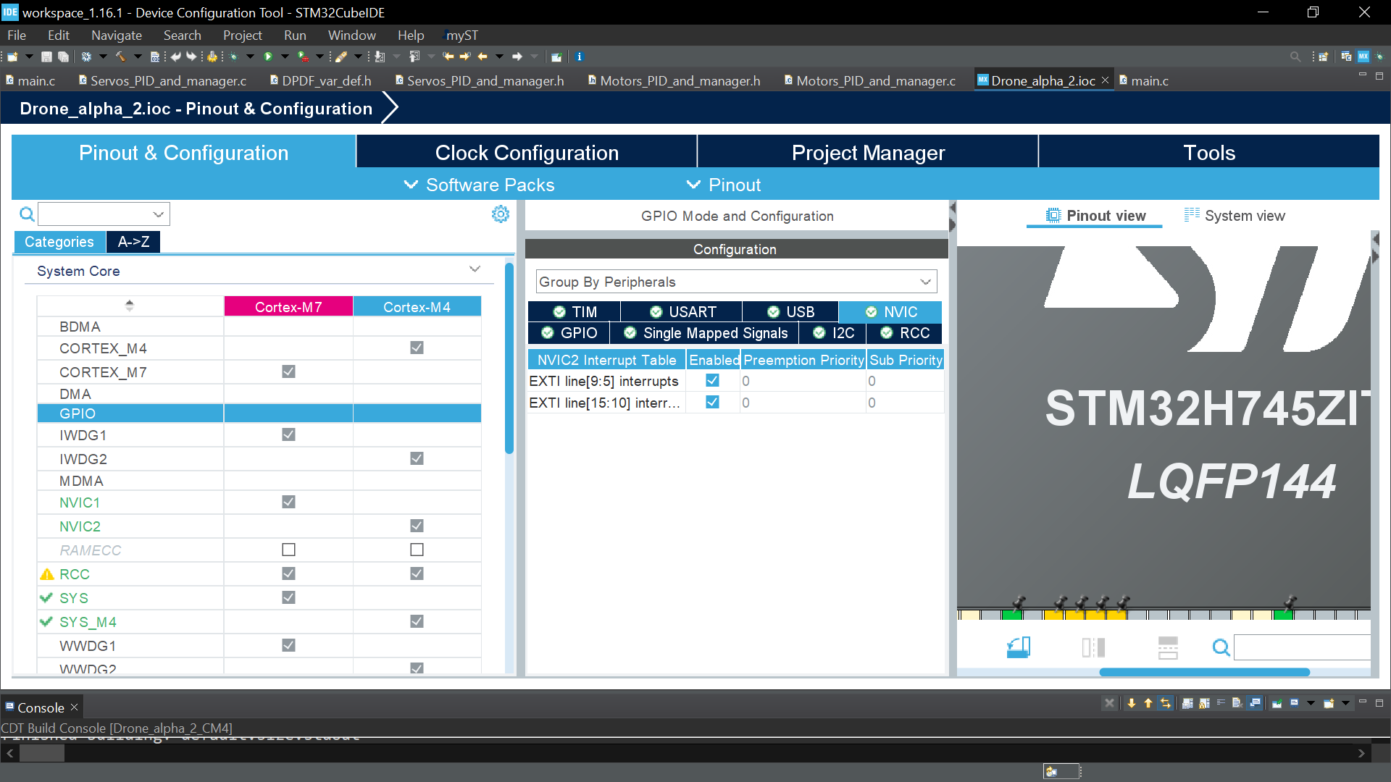
relazione/precedente/chapter3-SOFTWARE/Figures/NVIC_Interrupt attive - Copia.png
