diego-tag/ducted-fan/relazione/precedente/chapter3-SOFTWARE/Figures/PulseTIM4.png

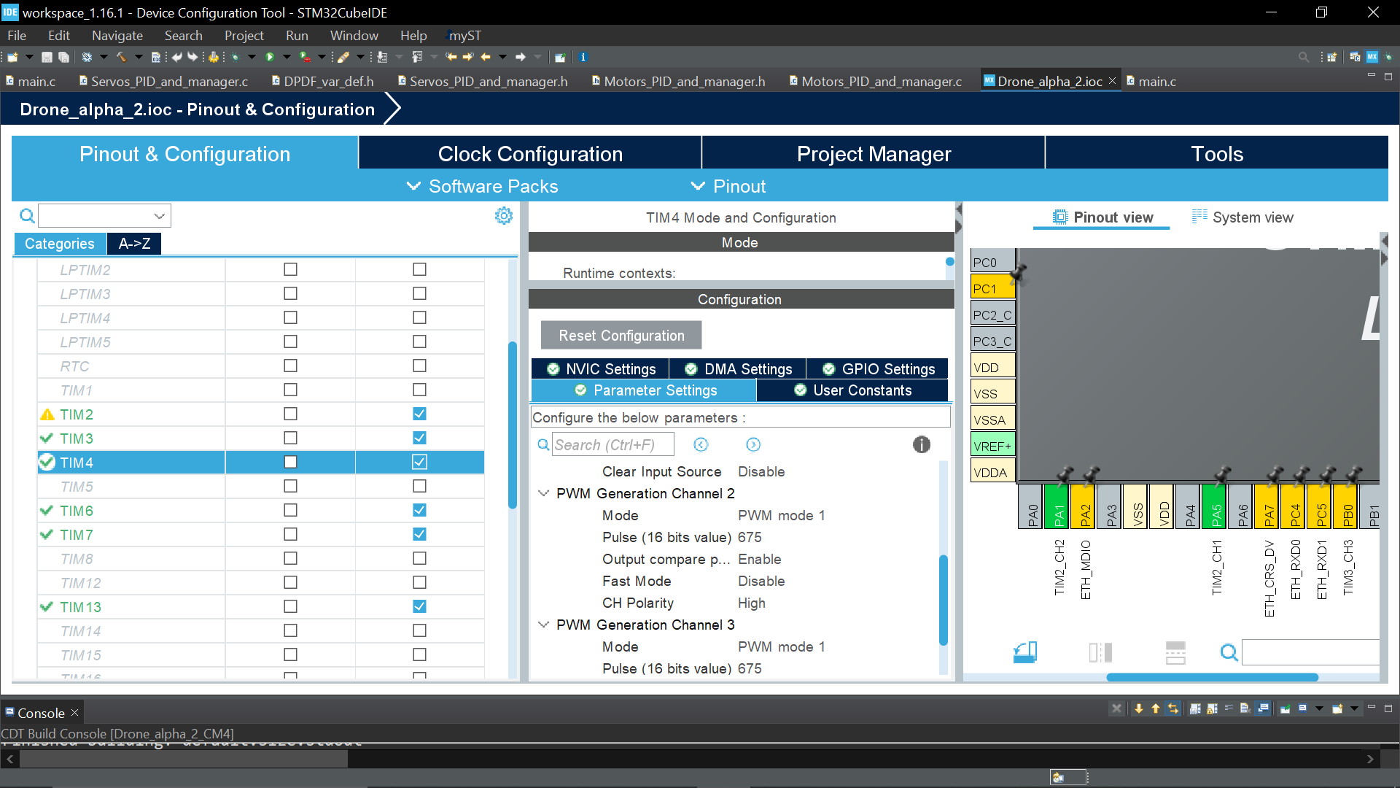
relazione/precedente/chapter3-SOFTWARE/Figures/PulseTIM4.png
