diego-tag/ducted-fan/relazione/precedente/chapter3-SOFTWARE/Figures/TIM3_NVIC_Globalnterrupt.png

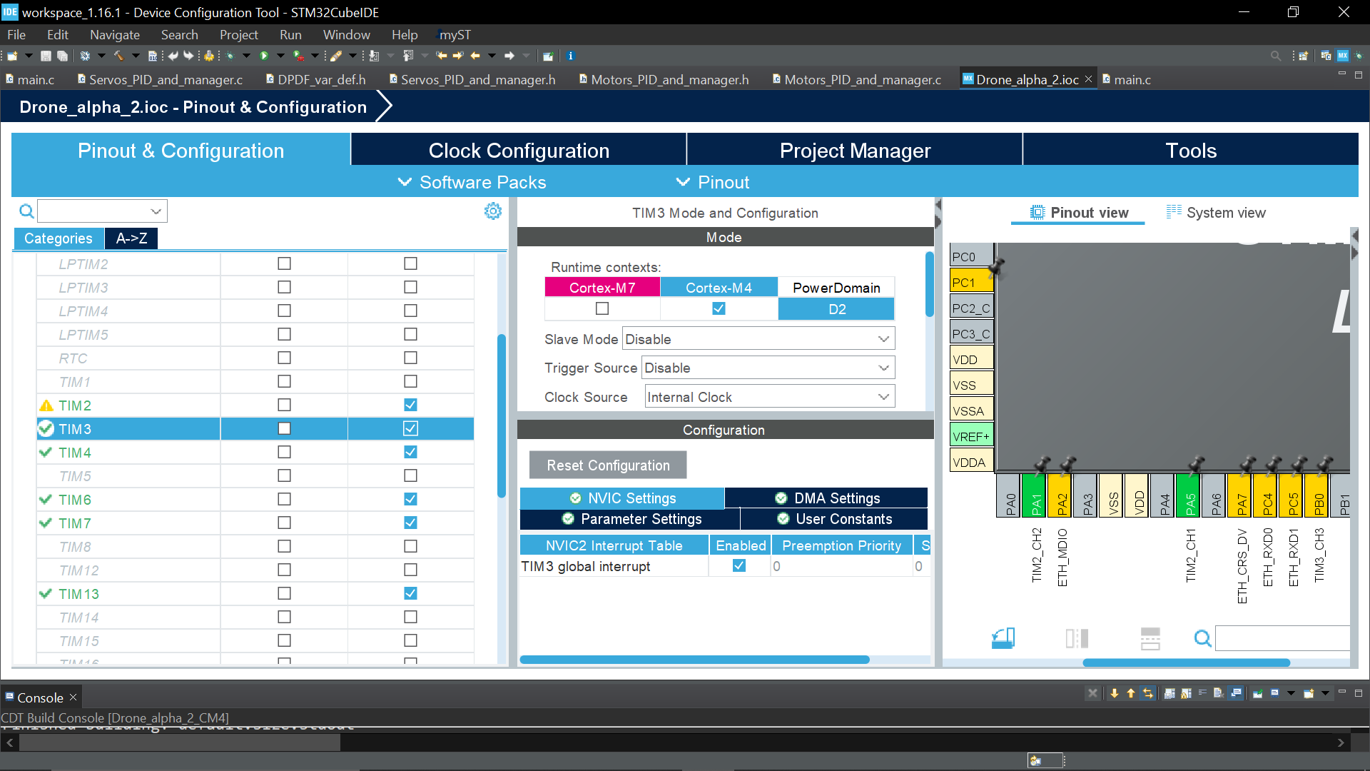
relazione/precedente/chapter3-SOFTWARE/Figures/TIM3_NVIC_Globalnterrupt.png
