diego-tag/ducted-fan/relazione/precedente/chapter3-SOFTWARE/Figures/TIM4ChannelView.png

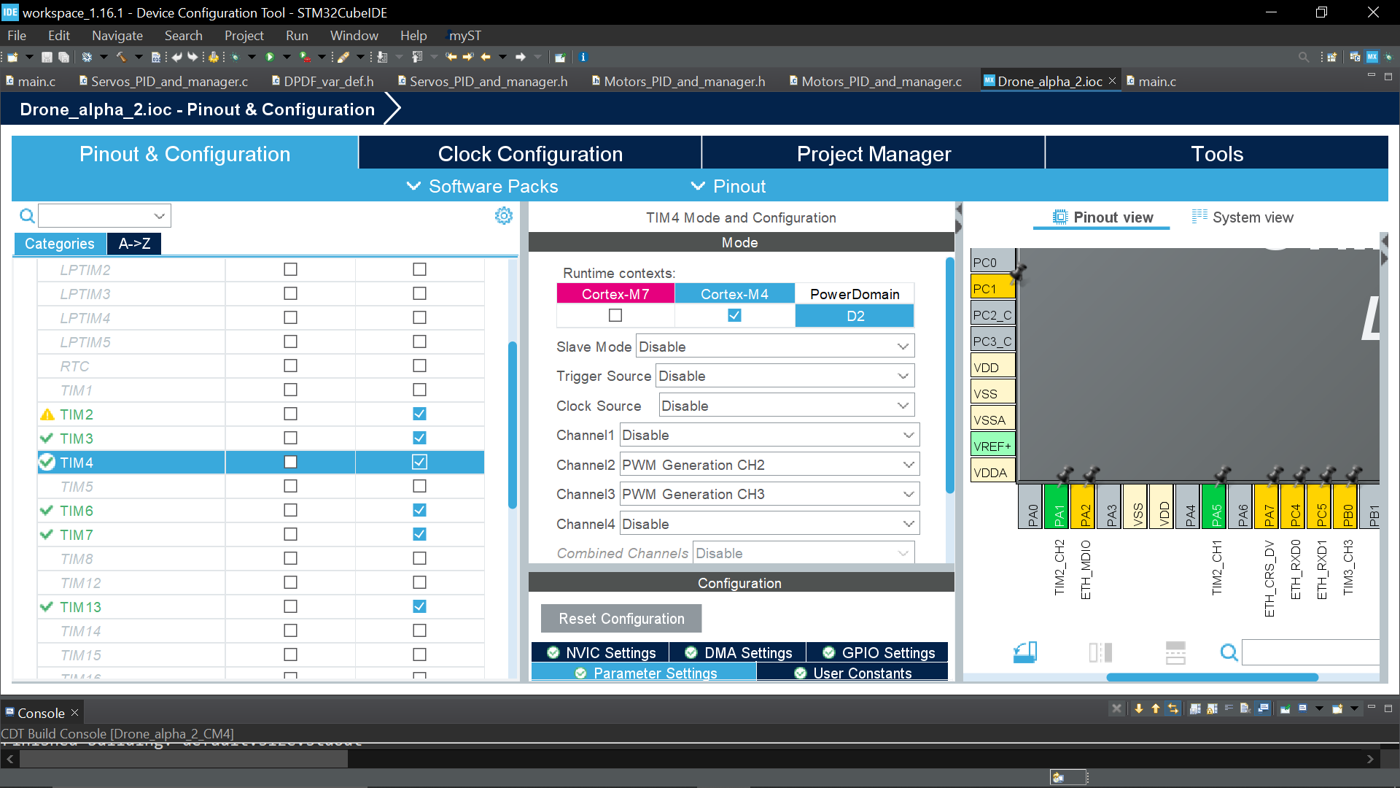
relazione/precedente/chapter3-SOFTWARE/Figures/TIM4ChannelView.png
