diego-tag/ducted-fan/relazione/precedente/chapter3-SOFTWARE/Figures/TIM6_NVIC_GlobalInterrupt.png

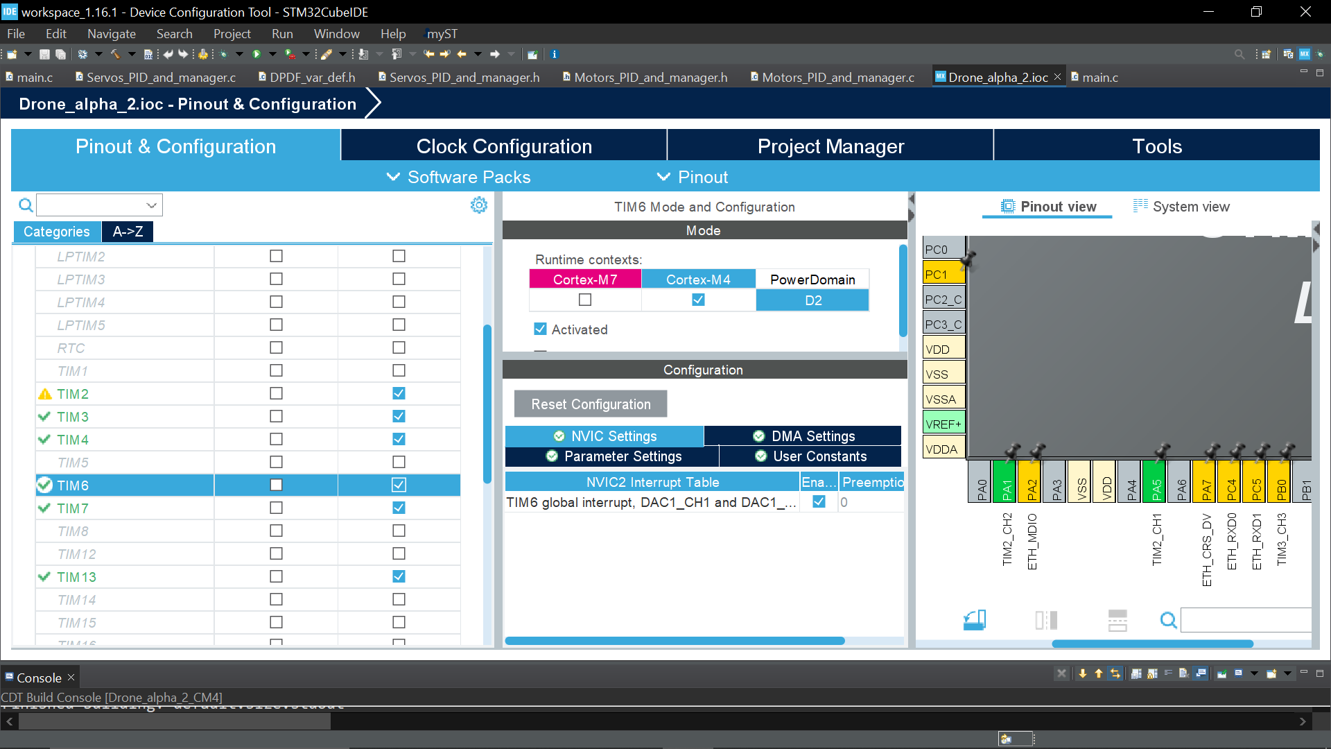
relazione/precedente/chapter3-SOFTWARE/Figures/TIM6_NVIC_GlobalInterrupt.png
