diego-tag/ducted-fan/relazione/precedente/chapter3-SOFTWARE/Figures/TIM6_PeriodPrescaler.png

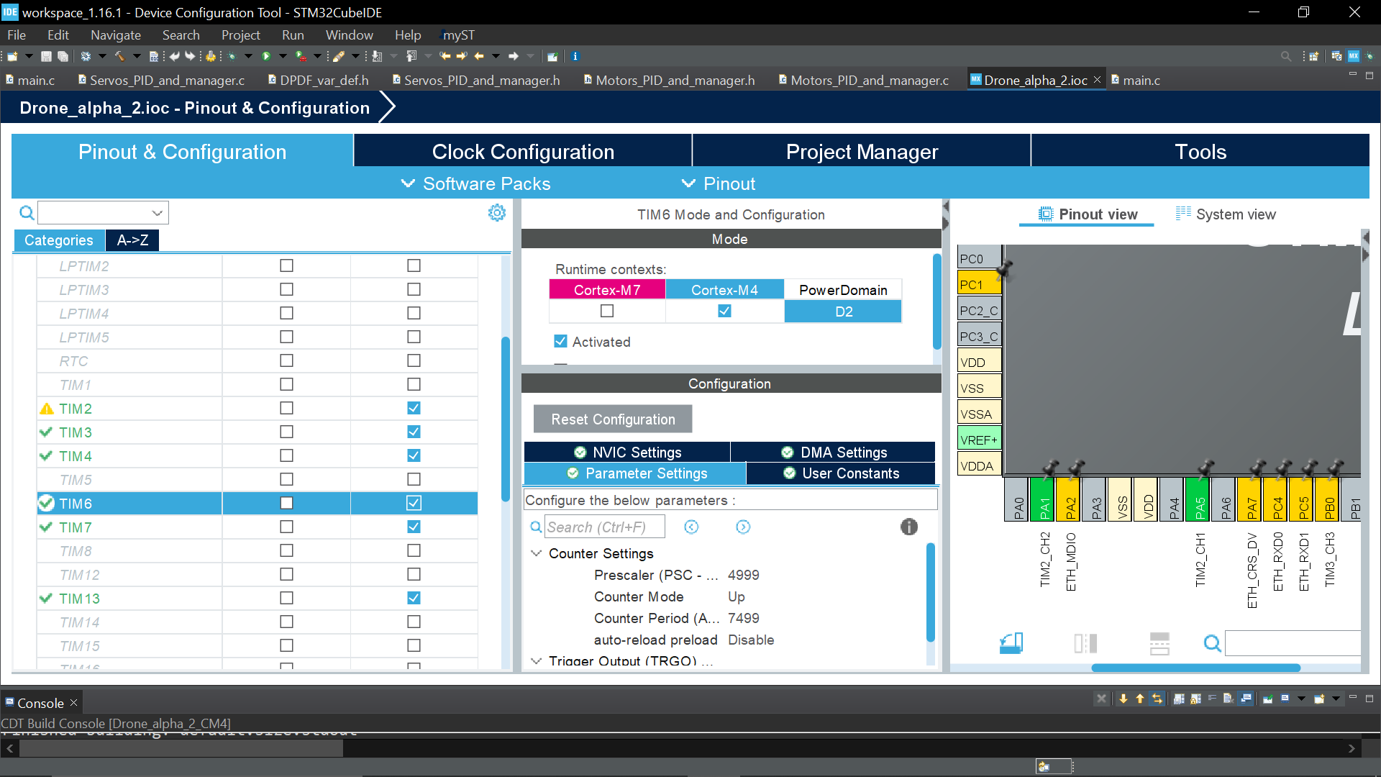
relazione/precedente/chapter3-SOFTWARE/Figures/TIM6_PeriodPrescaler.png
