diego-tag/ducted-fan/relazione/precedente/chapter3-SOFTWARE/Figures/TIM6GlobalInterrupt.png

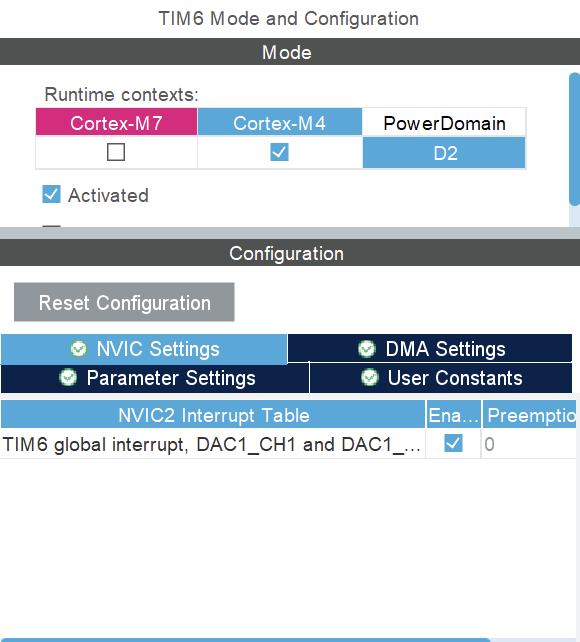
relazione/precedente/chapter3-SOFTWARE/Figures/TIM6GlobalInterrupt.png
