diego-tag/ducted-fan/relazione/precedente/figures copia/Diagramma_di_flusso_GestionMPU6050InvenSense.drawio.png

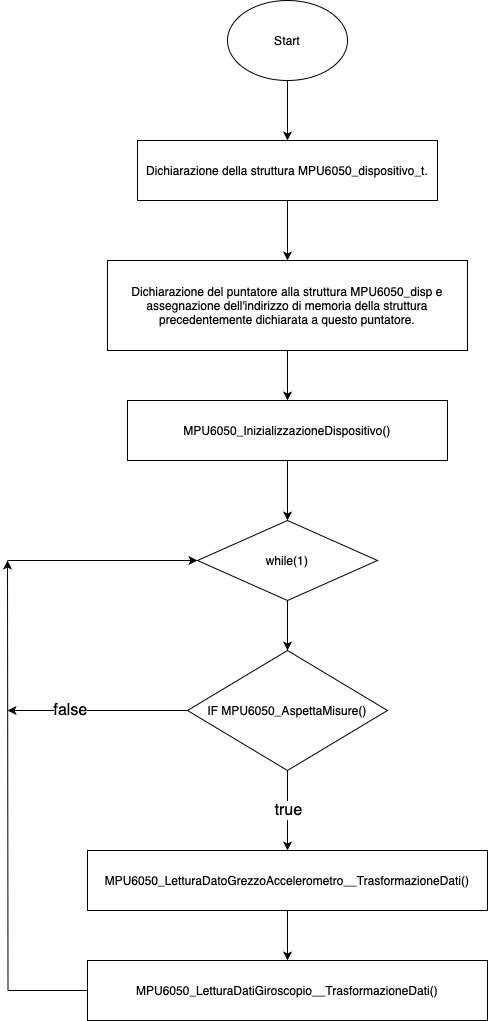
relazione/precedente/figures copia/Diagramma_di_flusso_GestionMPU6050InvenSense.drawio.png
