diego-tag/ducted-fan/relazione/precedente/figures copia/VL53L1X_DiagrammaDiFlusso.drawio.png

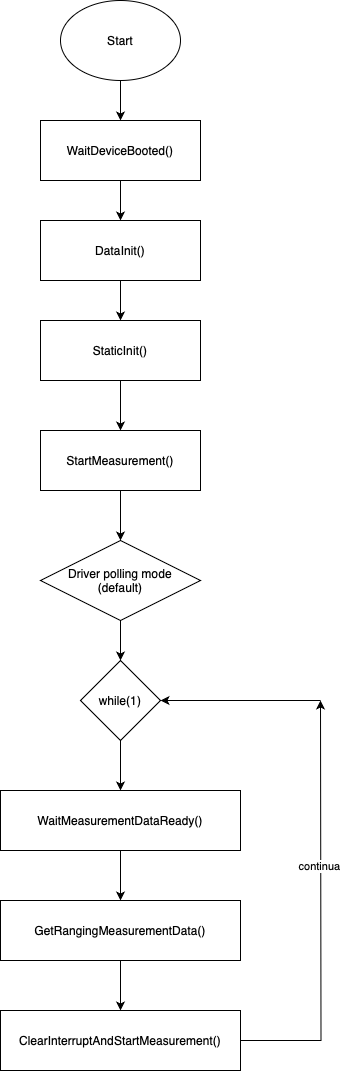
relazione/precedente/figures copia/VL53L1X_DiagrammaDiFlusso.drawio.png
