diego-tag/ducted-fan/relazione/precedente/images/Immagine_2_modulo_GY_86.png

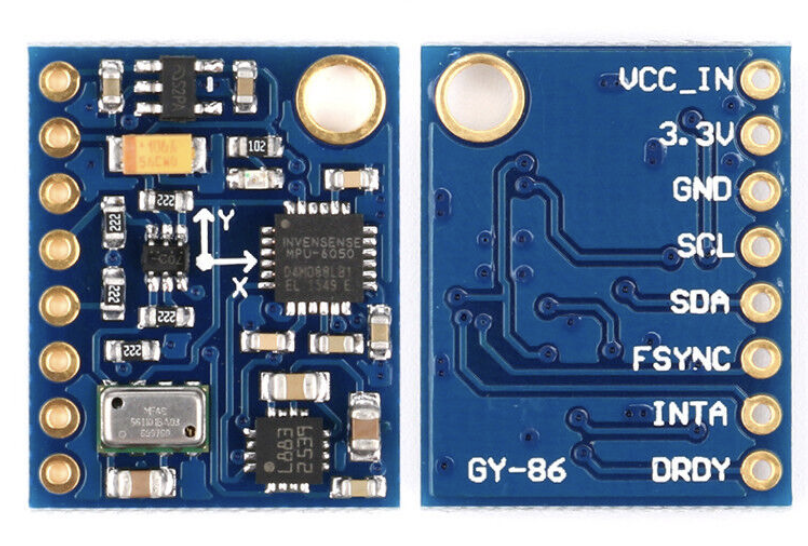
relazione/precedente/images/Immagine_2_modulo_GY_86.png
