diego-tag/ducted-fan/relazione/precedente/images/Immagine_4_Pololu.png

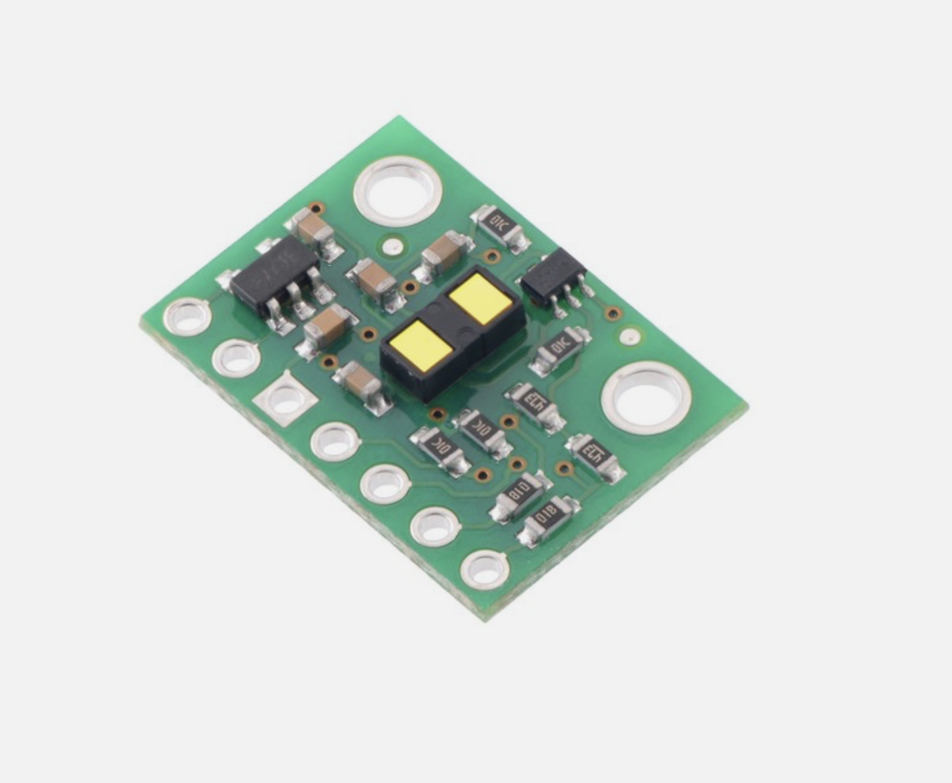
relazione/precedente/images/Immagine_4_Pololu.png
