diego-tag/ducted-fan/relazione/precedente/images/IMMAGINE_A_1_piastre_inerdigitate .png

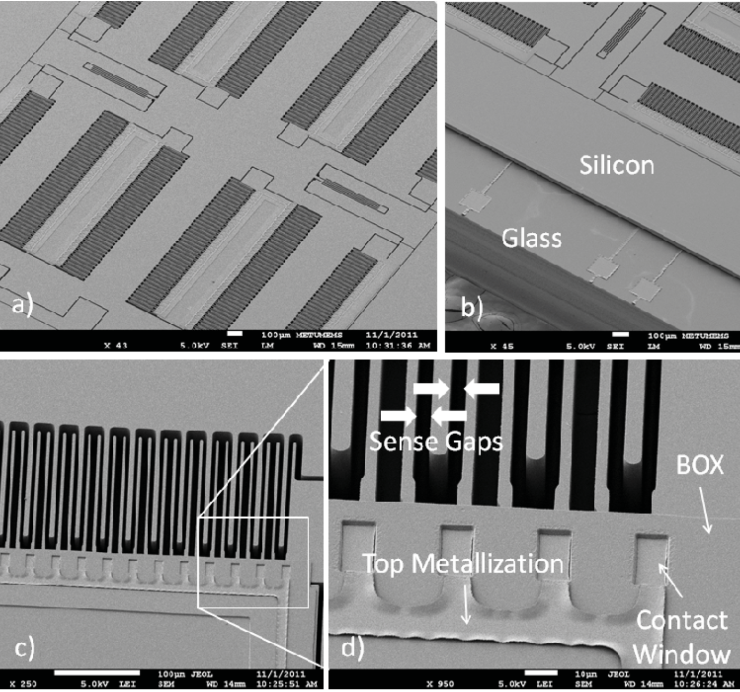
relazione/precedente/images/IMMAGINE_A_1_piastre_inerdigitate .png
