diego-tag/ducted-fan/relazione/precedente/Chapter2-HARDWARE/Figures/shopping.jpeg

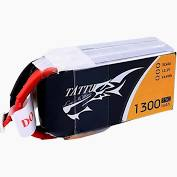
relazione/precedente/Chapter2-HARDWARE/Figures/shopping.jpeg
