diego-tag/ducted-fan/relazione/precedente/chapter1-TUTORIAL/Figura.pdf

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
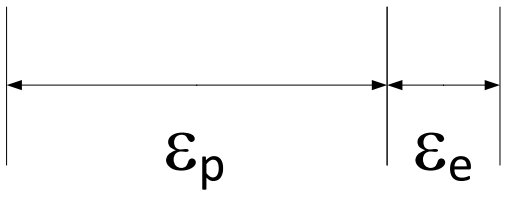
[picture p85: figure]
