diego-tag/ducted-fan/relazione/precedente/chapter3-SOFTWARE/Figures/Catena_delle_inclusioni.pdf

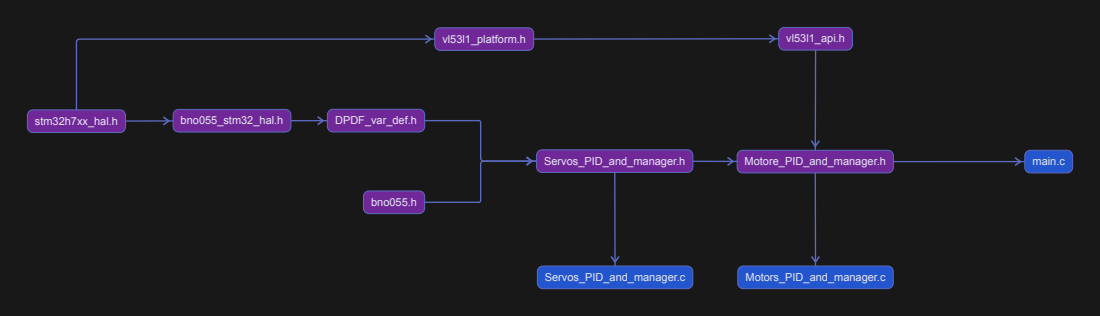
[picture p86: page 1]
DPDF_var_def.h; Servos_PID_and_manager.h; bno055.h; bno055_stm32_hal.h; vl53l1_api.h; stm32h7xx_hal.h; Motore_PID_and_manager.h; Servos_PID_and_manager.c; Motors_PID_and_manager.c; main.c; vl53l1_platform.h
