diego-tag/ducted-fan/DUCTED_FAN/CM4/Core/Src/main.c

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
/* Includes ------------------------------------------------------------------*/
#include "main.h"

/* USER CODE BEGIN PD */

#ifndef HSEM_ID_0
#define HSEM_ID_0 (0U) /* HW semaphore 0*/
#endif

/* USER CODE END PD */


I2C_HandleTypeDef hi2c1;
I2C_HandleTypeDef hi2c2;

TIM_HandleTypeDef htim2;
TIM_HandleTypeDef htim4;
TIM_HandleTypeDef htim6;
TIM_HandleTypeDef htim7;

UART_HandleTypeDef huart3;
DMA_HandleTypeDef hdma_usart3_tx;

/* USER CODE BEGIN PV */
volatile bool run = 0;
volatile bool actuate_servo_control = false;
volatile bool actuate_motors_control = false;
uint8_t rx_byte;
volatile uint8_t current_number_of_toggles = 0;
/* USER CODE END PV */

static void MX_GPIO_Init(void);
static void MX_DMA_Init(void);
static void MX_TIM6_Init(void);
static void MX_TIM7_Init(void);
static void MX_I2C1_Init(void);
static void MX_I2C2_Init(void);
static void MX_TIM4_Init(void);
static void MX_USART3_UART_Init(void);
static void MX_TIM2_Init(void);
/**
 * @brief  The application entry point.
 * @retval int
 */
int main(void) {
	/* USER CODE BEGIN Boot_Mode_Sequence_1 */
	/*HW semaphore Clock enable*/
	__HAL_RCC_HSEM_CLK_ENABLE();
	/* Activate HSEM notification for Cortex-M4*/
	HAL_HSEM_ActivateNotification(__HAL_HSEM_SEMID_TO_MASK(HSEM_ID_0));
	/*
	 Domain D2 goes to STOP mode (Cortex-M4 in deep-sleep) waiting for Cortex-M7 to
	 perform system initialization (system clock config, external memory configuration.. )
	 */
	HAL_PWREx_ClearPendingEvent();
	HAL_PWREx_EnterSTOPMode(PWR_MAINREGULATOR_ON, PWR_STOPENTRY_WFE,
	PWR_D2_DOMAIN);
	/* Clear HSEM flag */
	__HAL_HSEM_CLEAR_FLAG(__HAL_HSEM_SEMID_TO_MASK(HSEM_ID_0));

	/* USER CODE END Boot_Mode_Sequence_1 */
	/* MCU Configuration--------------------------------------------------------*/

	/* Reset of all peripherals, Initializes the Flash interface and the Systick. */
	HAL_Init();

	/* Initialize all configured peripherals */
	MX_GPIO_Init();
	MX_DMA_Init();
	MX_TIM6_Init();
	MX_TIM7_Init();
	MX_I2C1_Init();
	MX_I2C2_Init();
	MX_TIM4_Init();
	MX_USART3_UART_Init();
	MX_TIM2_Init();
	/* USER CODE BEGIN 2 */

	/*-------------------------------------------------------------------------------------------------------*/
	/*					  		    INITIALIZATION OF VARIABLES AND STRUCTURES			      			     */
	/*-------------------------------------------------------------------------------------------------------*/

	char uart_msg[STANDARD_MESSAGE_LENGTH];

	/*------------------------------ CONTROL-RELATED STRUCTURES ------------------------------*/

	struct bno055_t myBNO;

	pid_controller_t pid_roll, pid_pitch, pid_motor, pid_yaw;
	median_filter_t  tof_filter = {0};          /* Zero-init is safe */
	imu_angles_t     imu_ref;
	imu_angles_t     imu_now;
	uint16_t motor_pwm = LOWER_LIMIT_MOTOR;

	VL53L1_RangingMeasurementData_t rangingData;
	VL53L1_Dev_t vl53l1_c;
	VL53L1_DEV Dev = &vl53l1_c;

	/*-------------------------------------------------------------------------------------------------------*/
	/*					  		    			  SAFE STARTUP				      			 				 */
	/*-------------------------------------------------------------------------------------------------------*/

	// Ensure button is not held down during power-up
	while (HAL_GPIO_ReadPin(GPIOC, GPIO_PIN_13) == GPIO_PIN_SET) {
		__WFI();
	}

	HAL_UART_Transmit(&huart3, (uint8_t*) "Waiting safe startup (press user button or sends something to serial)...\n", strlen("Waiting safe startup (press user button or sends something to serial)...\n"),
	HAL_MAX_DELAY);

	// Setup USART to listen for exactly 1 byte (used for start/stop from serial)
	HAL_UART_Receive_IT(&huart3, &rx_byte, 1);

	while (!run) {
		__WFI();
	}

	HAL_UART_Transmit(&huart3, (uint8_t*) "Initialization starting in 5 seconds\n", strlen("Initialization starting in 8 seconds\n"),
	HAL_MAX_DELAY);

	safe_startup(NUMBER_OF_TOGGLES);

	/*-------------------------------------------------------------------------------------------------------*/
	/*					  		    	 SENSOR INITIALIZATION				      			 				 */
	/*-------------------------------------------------------------------------------------------------------*/

	/*------------------------------ VL53L1X INITIALIZATION ------------------------------*/

	HAL_GPIO_WritePin(GPIOG, GPIO_PIN_12, GPIO_PIN_SET); // Power the altitude sensor

	// Hardware reset the sensor with XSHUT (PE14 starts LOW from MX_GPIO_Init)
	HAL_GPIO_WritePin(GPIOE, GPIO_PIN_14, GPIO_PIN_SET);
	HAL_Delay(10);

	VL53L1_Error status = VL53L1_total_platform_init(Dev, 0x52, VL53L1_I2C, 400, 20000, 33);

	if (status == VL53L1_ERROR_NONE) {
		HAL_UART_Transmit(&huart3, (uint8_t*) "Altitude sensor (VL53L1X) initialized\n", strlen("Altitude sensor (VL53L1X) initialized\n"),
		HAL_MAX_DELAY);
	} else {
		sprintf(uart_msg, "Altitude sensor (VL53L1X) error: %d\n", status);
		HAL_UART_Transmit(&huart3, (uint8_t*) uart_msg, strlen(uart_msg), HAL_MAX_DELAY);
		return 1;
	}

	/*------------------------------ BNO055 INITIALIZATION ------------------------------*/

	myBNO.bus_read = bus_read;
	myBNO.bus_write = bus_write;
	myBNO.delay_msec = delay_func;
	myBNO.dev_addr = BNO055_I2C_ADDR1;
	bno055_init(&myBNO);

	// Enter config mode to remap axis
	bno055_set_operation_mode(BNO055_OPERATION_MODE_CONFIG);
	HAL_Delay(20);  //BNO055 requires ~19ms to enter CONFIG mode

	// Axis mapping: unchanged (default = 0x24 → X=X, Y=Y, Z=Z)
	bno055_set_axis_remap_value(BNO055_DEFAULT_AXIS);

	// Y e Z inverted to compensate flip of 180° over Y
	bno055_set_remap_x_sign(BNO055_REMAP_AXIS_NEGATIVE);
	bno055_set_remap_y_sign(BNO055_REMAP_AXIS_POSITIVE);
	bno055_set_remap_z_sign(BNO055_REMAP_AXIS_NEGATIVE);

	bno055_set_operation_mode(BNO055_OPERATION_MODE_NDOF);
	//bno055_calibration();
	imu_set_reference(&imu_ref);          // Capture "level" orientation
	HAL_UART_Transmit(&huart3, (uint8_t*) "IMU (BNO055) initialized\n", strlen("IMU (BNO055) initialized\n"), HAL_MAX_DELAY);

	/*-------------------------------------------------------------------------------------------------------*/
	/*                                   PID INITIALIZATIONS                                                 */
	/*-------------------------------------------------------------------------------------------------------*/

	pid_init(&pid_roll,
	         FLIGHT_CFG.servo_roll.kp, FLIGHT_CFG.servo_roll.ki, FLIGHT_CFG.servo_roll.kd,
	         FLIGHT_CFG.servo_roll.sample_time,
	         FLIGHT_CFG.servo_roll.out_min, FLIGHT_CFG.servo_roll.out_max,
	         FLIGHT_CFG.servo_roll.out_offset,
	         FLIGHT_CFG.servo_roll.lpf_alpha,
	         FLIGHT_CFG.servo_roll.deriv_on_measurement);

	pid_init(&pid_pitch,
	         FLIGHT_CFG.servo_pitch.kp, FLIGHT_CFG.servo_pitch.ki, FLIGHT_CFG.servo_pitch.kd,
	         FLIGHT_CFG.servo_pitch.sample_time,
	         FLIGHT_CFG.servo_pitch.out_min, FLIGHT_CFG.servo_pitch.out_max,
	         FLIGHT_CFG.servo_pitch.out_offset,
	         FLIGHT_CFG.servo_pitch.lpf_alpha,
	         FLIGHT_CFG.servo_pitch.deriv_on_measurement);

	snprintf(uart_msg, sizeof uart_msg, "PID servos: %d.%02d,%d.%02d,%d.%02d\n",
			(int)pid_roll.kp,abs((int)(pid_roll.kp * 100) % 100),
			(int)pid_roll.ki,abs((int)(pid_roll.ki * 100) % 100),
			(int)pid_roll.kd,abs((int)(pid_roll.kd * 100) % 100)
	);
	HAL_UART_Transmit(&huart3, (uint8_t*) uart_msg, strlen(uart_msg), HAL_MAX_DELAY);


	pid_init(&pid_motor,
	         FLIGHT_CFG.motor.kp, FLIGHT_CFG.motor.ki, FLIGHT_CFG.motor.kd,
	         FLIGHT_CFG.motor.sample_time,
	         FLIGHT_CFG.motor.out_min, FLIGHT_CFG.motor.out_max,
	         FLIGHT_CFG.motor.out_offset,
	         FLIGHT_CFG.motor.lpf_alpha,
	         FLIGHT_CFG.motor.deriv_on_measurement);

	snprintf(uart_msg, sizeof uart_msg, "PID motors: %d.%02d,%d.%02d,%d.%02d\n",
			(int)pid_motor.kp,abs((int)(pid_motor.kp * 100) % 100),
			(int)pid_motor.ki,abs((int)(pid_motor.ki * 100) % 100),
			(int)pid_motor.kd,abs((int)(pid_motor.kd * 100) % 100)
	);
	HAL_UART_Transmit(&huart3, (uint8_t*) uart_msg, strlen(uart_msg), HAL_MAX_DELAY);

	pid_init(&pid_yaw,
	         FLIGHT_CFG.yaw.kp, FLIGHT_CFG.yaw.ki, FLIGHT_CFG.yaw.kd,
	         FLIGHT_CFG.yaw.sample_time,
	         FLIGHT_CFG.yaw.out_min, FLIGHT_CFG.yaw.out_max,
	         FLIGHT_CFG.yaw.out_offset,
	         FLIGHT_CFG.yaw.lpf_alpha,
	         FLIGHT_CFG.yaw.deriv_on_measurement);

	snprintf(uart_msg, sizeof uart_msg, "PID yaw: %d.%02d,%d.%02d,%d.%02d\n",
			(int)pid_yaw.kp,abs((int)(pid_yaw.kp * 100) % 100),
			(int)pid_yaw.ki,abs((int)(pid_yaw.ki * 100) % 100),
			(int)pid_yaw.kd,abs((int)(pid_yaw.kd * 100) % 100)
	);
	HAL_UART_Transmit(&huart3, (uint8_t*) uart_msg, strlen(uart_msg), HAL_MAX_DELAY);

	snprintf(uart_msg, sizeof uart_msg, "Base throttle: %d.%02d\n",
			(int)FLIGHT_CFG.motor.out_offset,abs((int)(FLIGHT_CFG.motor.out_offset * 100) % 100)
	);
	HAL_UART_Transmit(&huart3, (uint8_t*) uart_msg, strlen(uart_msg), HAL_MAX_DELAY);

	/*-------------------------------------------------------------------------------------------------------*/
	/*                                   PWM INITIALIZATIONS                                                 */
	/*-------------------------------------------------------------------------------------------------------*/

	start_all_pwm();

	/*-------------------------------------------------------------------------------------------------------*/
	/*					  		    	 ACTUATORS SETUP       				      			 				 */
	/*-------------------------------------------------------------------------------------------------------*/

	HAL_TIM_Base_Start_IT(&htim7);  // Start interrupt for servo control actuation
	HAL_UART_Transmit(&huart3, (uint8_t*) "Control servos' actuation started\n", strlen("Control servos' actuation started\n"), HAL_MAX_DELAY);

	// Setup signal for ESC (throttle to the bottom)
	set_pwm_motors(LOWER_LIMIT_MOTOR, LOWER_LIMIT_MOTOR);

	HAL_UART_Transmit(&huart3, (uint8_t*) "Wait 5 seconds for ESC setup (n-beeps and a long beep)...\n", strlen("Wait 5 seconds for ESC setup (n-beeps and a long beep)...\n"), HAL_MAX_DELAY);

	// Delay for ESC setup
	HAL_Delay(5000);

	HAL_UART_Transmit(&huart3, (uint8_t*) "ESC setup completed (ensure no more beeps are emitted)\n",
			strlen("ESC setup completed (ensure no more beeps are emitted)\n"), HAL_MAX_DELAY);

	/*-------------------------------------------------------------------------------------------------------*/
	/*					  		    	 POST INITIALIZATION      				      			 		     */
	/*-------------------------------------------------------------------------------------------------------*/

	HAL_UART_Transmit(&huart3, (uint8_t*) "Initialization completed!\n", strlen("Initialization completed!\n"), HAL_MAX_DELAY);

	HAL_GPIO_WritePin(GPIOE, GPIO_PIN_1, GPIO_PIN_RESET); // turn off LD2 (yellow led)
	HAL_GPIO_WritePin(GPIOB, GPIO_PIN_0, GPIO_PIN_SET); // turn on LD1 (green led)

	// Start measurement LAST because first edge arrives ~25ms from now
	VL53L1_StartMeasurement(Dev);

	/* USER CODE END 2 */

	/* Infinite loop */
	/* USER CODE BEGIN WHILE */
	while (run) {

		/*--------------------------------------------- MOTOR ACTUATION AND CONTROL ---------------------------------------------*/
		if (actuate_motors_control) {
			actuate_motors_control = false;
			/* ---- Read ToF ---- */
			VL53L1_ClearInterruptAndStartMeasurement(Dev);

			VL53L1_GetRangingMeasurementData(Dev, &rangingData);

			/* ---- Compute tilt compensation ---- */
			float compensated_alt_mm = tof_compensate_tilt((float)rangingData.RangeMilliMeter, imu_now.roll_deg,imu_now.pitch_deg);

			/* ---- Compute median measurement---- */
			float alt_mm  = median_filter_compute(&tof_filter, compensated_alt_mm);

			/* ---- Compute motor PID ----- */
			motor_pwm = (uint16_t)(pid_compute(&pid_motor,FLIGHT_CFG.ref_altitude, alt_mm));

			/* --- Send in serial (comment it if not necessary) ---- */
			//sprintf(uart_msg, "%d.%02d,%d\n",(int)alt_mm,abs((int)(alt_mm   * 100) % 100),motor_pwm);
			//HAL_UART_Transmit_DMA(&huart3, (uint8_t*) uart_msg, strlen(uart_msg));

		}

		/*--------------------------------------------- SERVO-MOTOR ACTUATION AND CONTROL ---------------------------------------------*/

		if (actuate_servo_control) {
			actuate_servo_control = false;

			/* ---- Read IMU ---- */
			imu_read_relative(&imu_ref, &imu_now);

			/* ---- Rotate into flap frame ---- */
			flap_axes_t flap;
			axis_remap_imu_to_flaps(imu_now.roll_deg,imu_now.pitch_deg, &flap);

			/* ---- Compute servo PID (IMU Degrees in -> Flap Degrees out) ---- */
			float req_roll_deg  = pid_compute(&pid_roll,  FLIGHT_CFG.ref_roll_pitch, flap.flap_roll);
			float req_pitch_deg = pid_compute(&pid_pitch, FLIGHT_CFG.ref_roll_pitch, flap.flap_pitch);

			/* ---- Actuator Mapping (Degrees -> CCR) ---- */
			uint16_t roll_pwm  = angle_to_pwm(req_roll_deg, CENTER_SERVO, CCR_PER_DEGREE, UPPER_LIMIT_SERVO, LOWER_LIMIT_SERVO);
			uint16_t pitch_pwm = angle_to_pwm(req_pitch_deg, CENTER_SERVO, CCR_PER_DEGREE, UPPER_LIMIT_SERVO, LOWER_LIMIT_SERVO);

			/* ---- Compute mixer (differential throttle per yaw) --- */

			// Compute the yaw PID
			float yaw_correction = pid_compute(&pid_yaw, FLIGHT_CFG.ref_yaw, imu_now.yaw_deg);

			// Split evenly so altitude PID controls average thrust
			float top_f  = (float)motor_pwm + yaw_correction + (FLIGHT_CFG.yaw_trim / 2.0f);
			float bottom_f = (float)motor_pwm - yaw_correction - (FLIGHT_CFG.yaw_trim / 2.0f);

			// Altitude-priority clamping:
			// If correction hits a limit, clamp it. DO NOT shift the other motor.
			// Sacrifice yaw authority to preserve altitude (prevent sinking).
			if (bottom_f > (float)UPPER_LIMIT_MOTOR) {
				bottom_f = (float)UPPER_LIMIT_MOTOR;
			}
			if (top_f < (float)LOWER_LIMIT_MOTOR) {
				top_f = (float)LOWER_LIMIT_MOTOR;
			}
			if (top_f > (float)UPPER_LIMIT_MOTOR) {
				top_f = (float)UPPER_LIMIT_MOTOR;
			}
			if (bottom_f < (float)LOWER_LIMIT_MOTOR) {
				bottom_f = (float)LOWER_LIMIT_MOTOR;
			}

			// Final safety cast
			int16_t top_pwm    = (int16_t)top_f;
			int16_t bottom_pwm = (int16_t)bottom_f;

			/* --- Control --- */
			set_pwm_motors(top_pwm, bottom_pwm);
			set_pwm_servos(roll_pwm, pitch_pwm);


			/* --- Send in serial (comment it if not necessary) ----
			snprintf(uart_msg,sizeof(uart_msg), "%d.%02d,%d.%02d,%d,%d,%d.%02d,%d,%d\n",
					(int)flap.flap_roll, abs((int)(flap.flap_roll * 100) % 100),
					(int)flap.flap_pitch, abs((int)(flap.flap_pitch * 100) % 100),
					roll_pwm,
					pitch_pwm
			);
			*/

			snprintf(uart_msg,sizeof(uart_msg),"%d.%02d,%d,%d\n",
					(int)imu_now.yaw_deg, abs((int)(imu_now.yaw_deg*100) %100),
					top_pwm,
					bottom_pwm
			);
			HAL_UART_Transmit_DMA(&huart3, (uint8_t*) uart_msg, strlen(uart_msg));

		}

    /* USER CODE END WHILE */

    /* USER CODE BEGIN 3 */
	}

	/*-------------------------------------------------------------------------------------------------------*/
	/*                                   SHUTDOWN                                                            */
	/*-------------------------------------------------------------------------------------------------------*/

	// Stop all actuators immediately
	stop_all_pwm(LOWER_LIMIT_MOTOR, CENTER_SERVO);

	HAL_UART_Transmit_DMA(&huart3, (uint8_t*) "Shutdown\n", strlen("Shutdown\n"));

	HAL_GPIO_WritePin(GPIOB, GPIO_PIN_0, GPIO_PIN_RESET); // Turn off LD1 (green led)
	HAL_GPIO_WritePin(GPIOB, GPIO_PIN_14, GPIO_PIN_SET); // Turn on LD3 (red led)
  /* USER CODE END 3 */
}
/**
 * @brief I2C1 Initialization Function
 * @param None
 * @retval None
 */
static void MX_I2C1_Init(void) {

	hi2c1.Instance = I2C1;
	hi2c1.Init.Timing = 0x00301242;
	hi2c1.Init.OwnAddress1 = 0;
	hi2c1.Init.AddressingMode = I2C_ADDRESSINGMODE_7BIT;
	hi2c1.Init.DualAddressMode = I2C_DUALADDRESS_DISABLE;
	hi2c1.Init.OwnAddress2 = 0;
	hi2c1.Init.OwnAddress2Masks = I2C_OA2_NOMASK;
	hi2c1.Init.GeneralCallMode = I2C_GENERALCALL_DISABLE;
	hi2c1.Init.NoStretchMode = I2C_NOSTRETCH_DISABLE;
	if (HAL_I2C_Init(&hi2c1) != HAL_OK) {
		Error_Handler();
	}

	/** Configure Analogue filter
	 */
	if (HAL_I2CEx_ConfigAnalogFilter(&hi2c1, I2C_ANALOGFILTER_ENABLE) != HAL_OK) {
		Error_Handler();
	}

	/** Configure Digital filter
	 */
	if (HAL_I2CEx_ConfigDigitalFilter(&hi2c1, 0) != HAL_OK) {
		Error_Handler();
	}
}

/**
 * @brief I2C2 Initialization Function
 * @param None
 * @retval None
 */
static void MX_I2C2_Init(void) {

	hi2c2.Instance = I2C2;
	hi2c2.Init.Timing = 0x00909FCE;
	hi2c2.Init.OwnAddress1 = 0;
	hi2c2.Init.AddressingMode = I2C_ADDRESSINGMODE_7BIT;
	hi2c2.Init.DualAddressMode = I2C_DUALADDRESS_DISABLE;
	hi2c2.Init.OwnAddress2 = 0;
	hi2c2.Init.OwnAddress2Masks = I2C_OA2_NOMASK;
	hi2c2.Init.GeneralCallMode = I2C_GENERALCALL_DISABLE;
	hi2c2.Init.NoStretchMode = I2C_NOSTRETCH_DISABLE;
	if (HAL_I2C_Init(&hi2c2) != HAL_OK) {
		Error_Handler();
	}

	/** Configure Analogue filter
	 */
	if (HAL_I2CEx_ConfigAnalogFilter(&hi2c2, I2C_ANALOGFILTER_ENABLE) != HAL_OK) {
		Error_Handler();
	}

	/** Configure Digital filter
	 */
	if (HAL_I2CEx_ConfigDigitalFilter(&hi2c2, 0) != HAL_OK) {
		Error_Handler();
	}
}

/**
 * @brief TIM2 Initialization Function
 * @param None
 * @retval None
 */
static void MX_TIM2_Init(void) {

	TIM_MasterConfigTypeDef sMasterConfig = { 0 };
	TIM_OC_InitTypeDef sConfigOC = { 0 };

	htim2.Instance = TIM2;
	htim2.Init.Prescaler = 99;
	htim2.Init.CounterMode = TIM_COUNTERMODE_UP;
	htim2.Init.Period = 14999;
	htim2.Init.ClockDivision = TIM_CLOCKDIVISION_DIV1;
	htim2.Init.AutoReloadPreload = TIM_AUTORELOAD_PRELOAD_DISABLE;
	if (HAL_TIM_PWM_Init(&htim2) != HAL_OK) {
		Error_Handler();
	}
	sMasterConfig.MasterOutputTrigger = TIM_TRGO_RESET;
	sMasterConfig.MasterSlaveMode = TIM_MASTERSLAVEMODE_DISABLE;
	if (HAL_TIMEx_MasterConfigSynchronization(&htim2, &sMasterConfig) != HAL_OK) {
		Error_Handler();
	}
	sConfigOC.OCMode = TIM_OCMODE_PWM1;
	sConfigOC.Pulse = 1125;
	sConfigOC.OCPolarity = TIM_OCPOLARITY_HIGH;
	sConfigOC.OCFastMode = TIM_OCFAST_DISABLE;
	if (HAL_TIM_PWM_ConfigChannel(&htim2, &sConfigOC, TIM_CHANNEL_1) != HAL_OK) {
		Error_Handler();
	}
	if (HAL_TIM_PWM_ConfigChannel(&htim2, &sConfigOC, TIM_CHANNEL_2) != HAL_OK) {
		Error_Handler();
	}
	HAL_TIM_MspPostInit(&htim2);

}

/**
 * @brief TIM4 Initialization Function
 * @param None
 * @retval None
 */
static void MX_TIM4_Init(void) {

	TIM_MasterConfigTypeDef sMasterConfig = { 0 };
	TIM_OC_InitTypeDef sConfigOC = { 0 };

	htim4.Instance = TIM4;
	htim4.Init.Prescaler = 99;
	htim4.Init.CounterMode = TIM_COUNTERMODE_UP;
	htim4.Init.Period = 14999;
	htim4.Init.ClockDivision = TIM_CLOCKDIVISION_DIV1;
	htim4.Init.AutoReloadPreload = TIM_AUTORELOAD_PRELOAD_DISABLE;
	if (HAL_TIM_PWM_Init(&htim4) != HAL_OK) {
		Error_Handler();
	}
	sMasterConfig.MasterOutputTrigger = TIM_TRGO_RESET;
	sMasterConfig.MasterSlaveMode = TIM_MASTERSLAVEMODE_DISABLE;
	if (HAL_TIMEx_MasterConfigSynchronization(&htim4, &sMasterConfig) != HAL_OK) {
		Error_Handler();
	}
	sConfigOC.OCMode = TIM_OCMODE_PWM1;
	sConfigOC.Pulse = 712;
	sConfigOC.OCPolarity = TIM_OCPOLARITY_HIGH;
	sConfigOC.OCFastMode = TIM_OCFAST_DISABLE;
	if (HAL_TIM_PWM_ConfigChannel(&htim4, &sConfigOC, TIM_CHANNEL_2) != HAL_OK) {
		Error_Handler();
	}
	if (HAL_TIM_PWM_ConfigChannel(&htim4, &sConfigOC, TIM_CHANNEL_3) != HAL_OK) {
		Error_Handler();
	}
	HAL_TIM_MspPostInit(&htim4);

}

/**
 * @brief TIM6 Initialization Function
 * @param None
 * @retval None
 */
static void MX_TIM6_Init(void) {

	TIM_MasterConfigTypeDef sMasterConfig = { 0 };

	htim6.Instance = TIM6;
	htim6.Init.Prescaler = 4999;
	htim6.Init.CounterMode = TIM_COUNTERMODE_UP;
	htim6.Init.Period = 7499;
	htim6.Init.AutoReloadPreload = TIM_AUTORELOAD_PRELOAD_DISABLE;
	if (HAL_TIM_Base_Init(&htim6) != HAL_OK) {
		Error_Handler();
	}
	sMasterConfig.MasterOutputTrigger = TIM_TRGO_RESET;
	sMasterConfig.MasterSlaveMode = TIM_MASTERSLAVEMODE_DISABLE;
	if (HAL_TIMEx_MasterConfigSynchronization(&htim6, &sMasterConfig) != HAL_OK) {
		Error_Handler();
	}
}

/**
 * @brief TIM7 Initialization Function
 * @param None
 * @retval None
 */
static void MX_TIM7_Init(void) {

	TIM_MasterConfigTypeDef sMasterConfig = { 0 };

	htim7.Instance = TIM7;
	htim7.Init.Prescaler = 99;
	htim7.Init.CounterMode = TIM_COUNTERMODE_UP;
	htim7.Init.Period = 7499;
	htim7.Init.AutoReloadPreload = TIM_AUTORELOAD_PRELOAD_DISABLE;
	if (HAL_TIM_Base_Init(&htim7) != HAL_OK) {
		Error_Handler();
	}
	sMasterConfig.MasterOutputTrigger = TIM_TRGO_RESET;
	sMasterConfig.MasterSlaveMode = TIM_MASTERSLAVEMODE_DISABLE;
	if (HAL_TIMEx_MasterConfigSynchronization(&htim7, &sMasterConfig) != HAL_OK) {
		Error_Handler();
	}
}

/**
 * @brief USART3 Initialization Function
 * @param None
 * @retval None
 */
static void MX_USART3_UART_Init(void) {

	huart3.Instance = USART3;
	huart3.Init.BaudRate = 115200;
	huart3.Init.WordLength = UART_WORDLENGTH_8B;
	huart3.Init.StopBits = UART_STOPBITS_1;
	huart3.Init.Parity = UART_PARITY_NONE;
	huart3.Init.Mode = UART_MODE_TX_RX;
	huart3.Init.HwFlowCtl = UART_HWCONTROL_NONE;
	huart3.Init.OverSampling = UART_OVERSAMPLING_16;
	huart3.Init.OneBitSampling = UART_ONE_BIT_SAMPLE_DISABLE;
	huart3.Init.ClockPrescaler = UART_PRESCALER_DIV1;
	huart3.AdvancedInit.AdvFeatureInit = UART_ADVFEATURE_NO_INIT;
	if (HAL_UART_Init(&huart3) != HAL_OK) {
		Error_Handler();
	}
	if (HAL_UARTEx_SetTxFifoThreshold(&huart3, UART_TXFIFO_THRESHOLD_1_8) != HAL_OK) {
		Error_Handler();
	}
	if (HAL_UARTEx_SetRxFifoThreshold(&huart3, UART_RXFIFO_THRESHOLD_1_8) != HAL_OK) {
		Error_Handler();
	}
	if (HAL_UARTEx_DisableFifoMode(&huart3) != HAL_OK) {
		Error_Handler();
	}
}

/**
 * Enable DMA controller clock
 */
static void MX_DMA_Init(void) {

	/* DMA controller clock enable */
	__HAL_RCC_DMA1_CLK_ENABLE();

	/* DMA interrupt init */
	/* DMA1_Stream0_IRQn interrupt configuration */
	HAL_NVIC_SetPriority(DMA1_Stream0_IRQn, 0, 0);
	HAL_NVIC_EnableIRQ(DMA1_Stream0_IRQn);

}

/**
 * @brief GPIO Initialization Function
 * @param None
 * @retval None
 */
static void MX_GPIO_Init(void) {
	GPIO_InitTypeDef GPIO_InitStruct = { 0 };
	/* GPIO Ports Clock Enable */
	__HAL_RCC_GPIOC_CLK_ENABLE();
	__HAL_RCC_GPIOA_CLK_ENABLE();
	__HAL_RCC_GPIOB_CLK_ENABLE();
	__HAL_RCC_GPIOE_CLK_ENABLE();
	__HAL_RCC_GPIOD_CLK_ENABLE();
	__HAL_RCC_GPIOG_CLK_ENABLE();

	/*Configure GPIO pin Output Level */
	HAL_GPIO_WritePin(GPIOB, LD1_Pin | LD3_Pin, GPIO_PIN_RESET);

	/*Configure GPIO pin Output Level */
	HAL_GPIO_WritePin(GPIOE, VL53L1X_XSHUT_Pin | LD2_Pin, GPIO_PIN_RESET);

	/*Configure GPIO pin Output Level */
	HAL_GPIO_WritePin(POWER_VL53L1X___BNO055_GPIO_Port, POWER_VL53L1X___BNO055_Pin, GPIO_PIN_SET);

	/*Configure GPIO pin : USER_BUTTON_Pin */
	GPIO_InitStruct.Pin = USER_BUTTON_Pin;
	GPIO_InitStruct.Mode = GPIO_MODE_IT_RISING;
	GPIO_InitStruct.Pull = GPIO_NOPULL;
	HAL_GPIO_Init(USER_BUTTON_GPIO_Port, &GPIO_InitStruct);

	/*Configure GPIO pins : LD1_Pin LD3_Pin */
	GPIO_InitStruct.Pin = LD1_Pin | LD3_Pin;
	GPIO_InitStruct.Mode = GPIO_MODE_OUTPUT_PP;
	GPIO_InitStruct.Pull = GPIO_NOPULL;
	GPIO_InitStruct.Speed = GPIO_SPEED_FREQ_LOW;
	HAL_GPIO_Init(GPIOB, &GPIO_InitStruct);

	/*Configure GPIO pin : PE7 */
	GPIO_InitStruct.Pin = GPIO_PIN_7;
	GPIO_InitStruct.Mode = GPIO_MODE_IT_RISING;
	GPIO_InitStruct.Pull = GPIO_NOPULL;
	HAL_GPIO_Init(GPIOE, &GPIO_InitStruct);

	/*Configure GPIO pin : VL52L1X_GPIO1_Pin */
	GPIO_InitStruct.Pin = VL52L1X_GPIO1_Pin;
	GPIO_InitStruct.Mode = GPIO_MODE_IT_FALLING;
	GPIO_InitStruct.Pull = GPIO_PULLUP;
	HAL_GPIO_Init(VL52L1X_GPIO1_GPIO_Port, &GPIO_InitStruct);

	/*Configure GPIO pins : VL53L1X_XSHUT_Pin LD2_Pin */
	GPIO_InitStruct.Pin = VL53L1X_XSHUT_Pin | LD2_Pin;
	GPIO_InitStruct.Mode = GPIO_MODE_OUTPUT_PP;
	GPIO_InitStruct.Pull = GPIO_NOPULL;
	GPIO_InitStruct.Speed = GPIO_SPEED_FREQ_LOW;
	HAL_GPIO_Init(GPIOE, &GPIO_InitStruct);

	/*Configure GPIO pin : POWER_VL53L1X___BNO055_Pin */
	GPIO_InitStruct.Pin = POWER_VL53L1X___BNO055_Pin;
	GPIO_InitStruct.Mode = GPIO_MODE_OUTPUT_PP;
	GPIO_InitStruct.Pull = GPIO_NOPULL;
	GPIO_InitStruct.Speed = GPIO_SPEED_FREQ_LOW;
	HAL_GPIO_Init(POWER_VL53L1X___BNO055_GPIO_Port, &GPIO_InitStruct);

	/* EXTI interrupt init*/
	HAL_NVIC_SetPriority(EXTI15_10_IRQn, 0, 0);
	HAL_NVIC_EnableIRQ(EXTI15_10_IRQn);

}

/* USER CODE BEGIN 4 */

/*-------------------------------------------------------------------------------------------------------*/
/*					  		INTERRUPT & CALLBACK FUNCTIONS				      					         */
/*-------------------------------------------------------------------------------------------------------*/

void HAL_TIM_PeriodElapsedCallback(TIM_HandleTypeDef *htim) {

	if (htim->Instance == TIM6) {
		// Tim 6 emits at 2 Hz
		HAL_GPIO_TogglePin(GPIOE, GPIO_PIN_1); // Toggle LD2 (yellow led)
		current_number_of_toggles++;
	}

	if (htim->Instance == TIM7) {
		actuate_servo_control = true;
	}

}

void HAL_GPIO_EXTI_Callback(uint16_t GPIO_Pin) {
	// When user button is pressed (used for safe startup)
	if (GPIO_Pin == GPIO_PIN_13) {
		run = !run;
	}

	// When VL53L1X data is ready, trigger PID
	if (GPIO_Pin == GPIO_PIN_12) {
		actuate_motors_control = true;
	}

}

// When RX pin reads something
void HAL_UART_RxCpltCallback(UART_HandleTypeDef *huart) {
	// This is the usb cable
	if (huart->Instance == USART3) {
		// At every terminator, toggle run flag. This is used to trigger start/stop from serial
		if (rx_byte == '\n') {
			run = !run;
		}

		HAL_UART_Receive_IT(&huart3, &rx_byte, 1);
	}
}
/* USER CODE END 4 */
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
