diego-tag/ducted-fan/DUCTED_FAN/DUCTED_FAN.ioc

Mcu.UserName=STM32H745ZITx
PA11.Signal=USB_OTG_FS_DM
PA12.Signal=USB_OTG_FS_DP
PA5.GPIO_Label=PWM_SERVO_ROLL
PA5.Signal=S_TIM2_CH1_ETR
PA8.Signal=USB_OTG_FS_SOF
PA9.Signal=USB_OTG_FS_VBUS
PB0.GPIO_Label=LD1 [Green led]
PB0.Signal=GPIO_Output
PB10.Signal=I2C2_SCL
PB11.Signal=I2C2_SDA
PB14.GPIO_Label=LD3 [Red Led]
PB14.Signal=GPIO_Output
PB6.Signal=I2C1_SCL
PB7.Signal=I2C1_SDA
PC13.GPIO_Label=USER_BUTTON
PC13.Signal=GPXTI13
PD10.GPIO_Label=USB_OTG_FS_PWR_EN
PD10.Signal=GPIO_Output
PD13.GPIO_Label=PWM_TOP_MOTOR
PD13.Signal=S_TIM4_CH2
PD14.GPIO_Label=PWM_BOTTOM_MOTOR
PD14.Signal=S_TIM4_CH3
PD8.GPIO_Label=STLINK_RX
PD8.Signal=USART3_TX
PD9.GPIO_Label=STLINK_TX
PD9.Signal=USART3_RX
PE1.GPIO_Label=LD2 [Yellow led]
PE1.Signal=GPIO_Output
PE12.GPIO_Label=VL52L1X_GPIO1
PE12.Signal=GPXTI12
PE14.GPIO_Label=VL53L1X_XSHUT
PE14.Signal=GPIO_Output
PE7.Signal=GPXTI7
PG12.GPIO_Label=POWER_VL53L1X_&_BNO055
PG12.Signal=GPIO_Output
