diego-tag/ducted-fan/DUCTED_FAN/CM4/Core/Inc/main.h

#define USER_BUTTON_Pin GPIO_PIN_13
#define USER_BUTTON_GPIO_Port GPIOC
#define PWM_SERVO_ROLL_Pin GPIO_PIN_5
#define PWM_SERVO_ROLL_GPIO_Port GPIOA
#define LD1_Pin GPIO_PIN_0
#define LD1_GPIO_Port GPIOB
#define VL52L1X_GPIO1_Pin GPIO_PIN_12
#define VL52L1X_GPIO1_GPIO_Port GPIOE
#define VL53L1X_XSHUT_Pin GPIO_PIN_14
#define VL53L1X_XSHUT_GPIO_Port GPIOE
#define LD3_Pin GPIO_PIN_14
#define LD3_GPIO_Port GPIOB
#define STLINK_RX_Pin GPIO_PIN_8
#define STLINK_RX_GPIO_Port GPIOD
#define STLINK_TX_Pin GPIO_PIN_9
#define STLINK_TX_GPIO_Port GPIOD
#define PWM_TOP_MOTOR_Pin GPIO_PIN_13
#define PWM_TOP_MOTOR_GPIO_Port GPIOD
#define PWM_BOTTOM_MOTOR_Pin GPIO_PIN_14
#define PWM_BOTTOM_MOTOR_GPIO_Port GPIOD
#define POWER_VL53L1X___BNO055_Pin GPIO_PIN_12
#define POWER_VL53L1X___BNO055_GPIO_Port GPIOG
#define PWM_SERVO_PITCH_Pin GPIO_PIN_3
#define PWM_SERVO_PITCH_GPIO_Port GPIOB
#define LD2_Pin GPIO_PIN_1
#define LD2_GPIO_Port GPIOE
