diego-tag/ducted-fan/(commit log)

2026-03-10 src: update name to DUCTED_FAN to ensure compatibility
2026-03-11 src: improved project - new feat: user button shutdown - altitude sensor in interrupt mode instead of polling - cleaner ioc
2026-03-13 relazione: organizzati files di `figures` in cartelle per ogni capitolo
2026-03-13 relazione: migliorato nome di ogni immagine
2026-03-18 relazione: aggiunte foto struttura ducted fan
2026-03-25 fix: mapping degli assi dell'IMU e casting di alcune variabili
    [DPDF_var_def.h, Servos_PID_and_manager.c, main.c]
2026-03-25 refactor: PID motori molto più robusto
2026-03-26 feat: imposta USART con DMA circolare per evitare blocchi
2026-03-26 refactor: spostati callback/interrupt nel `main.c`
2026-03-27 fix: riporta USART in modalità DMA normale
    [DUCTED_FAN.ioc, main.c]
2026-03-30 update general flow
2026-03-30 update flow
2026-04-01 feat: implementata compensazione inclinazione tof (`tof_compensate_tilt`), compensazione disallinamento imu con assi flap (`axis_remap_imu_to_flaps`) e filtro mediano in imu - rifattorizzato molto co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
2026-04-04 refactor: spostato tutte funzioni legate al PWM in `pwm.c` - rinonimata funzione `execution_servo` in `servo_actuation` per essere conforme a `motor_actuation`
2026-04-04 refactor: aggiunto file settings.json di vscode a .gitignore
2026-04-07 fix: usa valori IMU assoluti e non relativi a riferimento iniziale
    [main.c]
2026-04-12 relazione: aggiunta spiegazione della teoria e implementazione PID, compensazione tilt, filtro mediano, compensazione assi IMU, clamping e antiwindup, toggle di `run`
2026-04-13 relazione: modifica alla parte hardware e aggiunta del diagramma di flusso del BNO055
2026-04-16 feat(WIP): yaw correction and other improvements
    [DPDF_var_def.h, main.c]
2026-04-17 feat: pid yaw tuned - fixed correction signs - disable other pids
    [main.c]
2026-04-18 Relazione: modifica all'introduzione dopo l'aggiunta del nuovo PID, piccoli riassunti relativi alla parte hardware, aggiunta parte della bibliografia (da finire)
2026-04-22 fix: nel calcolo dell'altezza, prima compensa l'inclinazione e poi fai la mediana
    [config.c, main.c]
