diego-tag/ducted-fan/(notices)

Notices in the files:
DUCTED_FAN/CM4/Core/Inc/main.h:
Copyright (c) 2025 STMicroelectronics.
All rights reserved.
This software is licensed under terms that can be found in the LICENSE file
